HectorPereira/proyectoIntegrador2/latex/2_metodologia.tex

\section{Desarrollo de la solución}

\subsection{Alcance del proyecto}
El proyecto comprende el diseño, construcción y validación de un brazo robótico didáctico a escala. La arquitectura mecánica contempla cuatro grados de libertad (sin contar el efector), con una estructura paramétrica diseñada para corte láser en MDF de espesores entre 3.2 y 10 mm, pero adaptable también a materiales como acrílico o metal. La base será fija y deberá estar contenida dentro de un volumen de 50 $\times$ 50 $\times$ 50 cm.

\vspace{1em}

El sistema contará con efectores intercambiables, entre ellos un electroimán para la manipulación de piezas ferromagnéticas y una garra mecánica para piezas no magnéticas. Ambos estarán diseñados con un mecanismo de cambio rápido que permita alternar entre uno y otro sin dificultad.

\vspace{1em}

La actuación del brazo se logrará mediante servomotores MG996R, con uno por cada articulación principal. Para optimizar el rendimiento, se implementará una transmisión por eslabones que mantenga la mayor parte de la masa cercana a los ejes de giro.

\vspace{1em}

En cuanto al control y la electrónica, se utilizará un microcontrolador (ESP32 o ATmega328P), un driver MOSFET como el IRFZ44N (o equivalente) para gobernar el electroimán, así como finales de carrera para homing y elementos de señalización visual y sonora mediante LEDs y un buzzer de estado.

\vspace{1em}

El software incluirá un firmware desarrollado en C/C++ y una interfaz gráfica en Python, implementada en Tkinter o PyQt. Esta ofrecerá un modo manual y un modo automático, además de control ON/OFF del electroimán y una cinemática inversa planar básica para la manipulación de piezas.

\vspace{1em}

La alimentación del sistema se resolverá con una fuente capaz de abastecer tanto la lógica como la potencia, incorporando convertidores adecuados para los servos y el electroimán.

\vspace{1em}

Finalmente, en el componente de documentación y docencia, se elaborará un manual de armado, una guía docente y un conjunto mínimo de cinco prácticas de laboratorio orientadas a la enseñanza y experimentación con el brazo robótico.

\subsection{Criterios de aceptación}
El dispositivo debe ser capaz de ejecutar trayectorias punto a punto tanto en modo manual como en modo automático. Asimismo, deberá alcanzar una tasa de éxito superior al 90 \% en las tareas de agarre y manipulación de objetos, garantizando un desempeño confiable durante su operación.

\vspace{1em}

De igual forma, contará con una rutina de referencia operativa que asegure la correcta inicialización del sistema, un mecanismo de paro de emergencia y límites mecánicos verificados para preservar la seguridad del equipo y del entorno.

\vspace{1em}

Finalmente, el proyecto se entregará con un prototipo completamente ensamblado, acompañado del firmware correspondiente, la interfaz gráfica de usuario, un manual de usuario detallado y una guía docente que incluya cinco prácticas evaluables para su aplicación en el ámbito académico.

\subsection{Segmentación de proyecto}
\begin{enumerate}
  \item \textbf{Métodos de fabricación:} Definir el flujo de fabricación y los materiales del prototipo. Priorizar MDF cortado a láser para iteraciones rápidas y precisión 2D, y emplear PLA impreso en 3D en interfaces sometidas a fricción o geometrías no realizables a láser. Diseñar y fabricar galgas para validar tolerancias y encastres MDF–MDF, PLA–PLA y mixtos. Documentar parámetros de corte e impresión y criterios de aceptación dimensional.
  
  \item \textbf{Diseño y manufactura:} Modelar la estructura del brazo considerando distribución de masas, trayectorias y rigidez. Dimensionar y ubicar servomotores (MG996R y SG90), soportes, eslabones y topes mecánicos; definir uniones, casquillos y separadores. Fabricar base, articulaciones, manipulador (garra) y controlador espejo con sus accesorios. Verificar interferencias, holguras y repetibilidad; ajustar iterativamente las piezas hasta lograr el encastre objetivo.
  
  \item \textbf{Electrónica:} Integrar alimentación a 5 V, distribución de potencia y protección básica. Cablear Arduino UNO con servomotores, indicadores LED y buzzer; incorporar el controlador espejo como entrada de posición/estado. Trazar esquema eléctrico, asignar pines y preparar placa o protoboard de control. Validar corrientes de pico y caídas de tensión en carga.
  
  \item \textbf{Programación:} Desarrollar el firmware del Arduino con modos de operación manual, espejo y recorrido preprogramado. Implementar comunicación serial con la interfaz de usuario, temporización y filtrado básico de señales. Incluir homing o posiciones seguras, límites de movimiento y manejo de errores. Entregar archivo fuente versionado y un set mínimo de pruebas funcionales.
  
  \item \textbf{Documentación:} Producir el paquete de entrega: manual de uso, manual de ensamblaje y planos de fabricación. Incluir diagrama eléctrico, lista de materiales, parámetros de corte/impresión, y guías de mantenimiento. Registrar decisiones de diseño, riesgos y recomendaciones para réplica en ámbito educativo. Versionar todos los documentos y figuras con sus fuentes.
 
\end{enumerate}

\subsubsection{Esquema de procedimiento seguido}
\begin{figure}[H]
  \centering
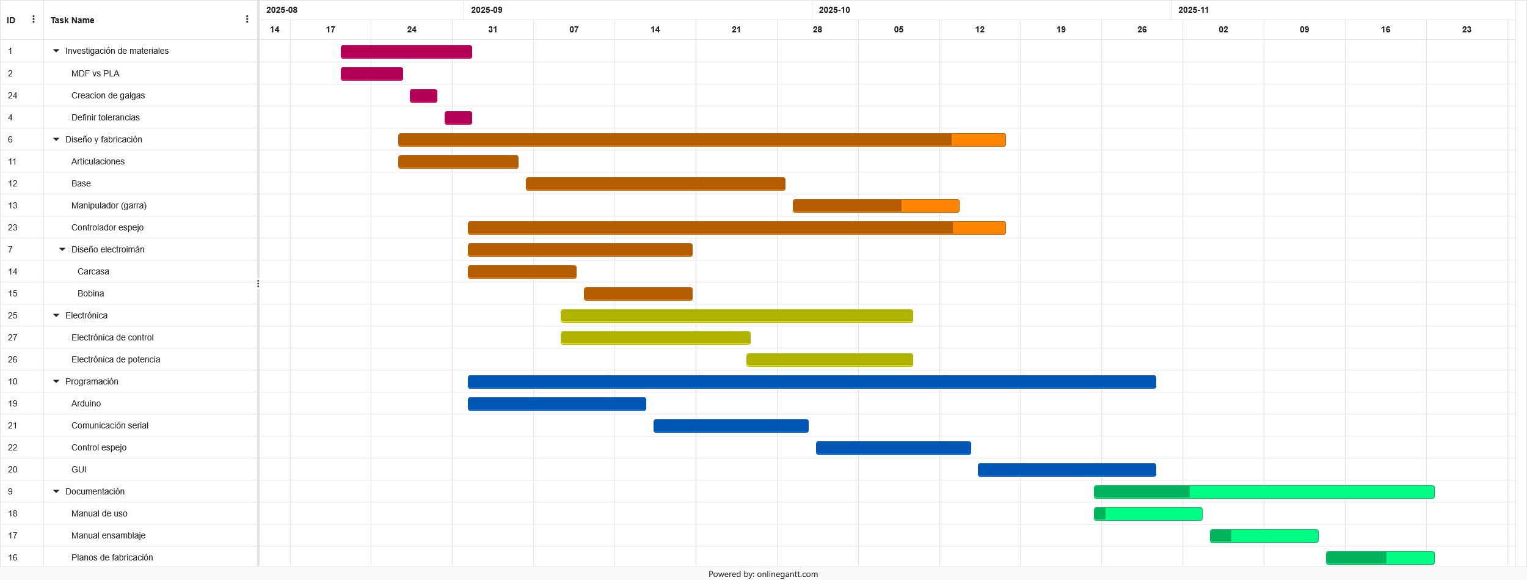
[picture p2: latex/Anexos/Gantt.png]
  
  \caption{Esquema de procedimiento y tareas seguido durante el proyecto. Fuente: elaboración propia}\label{fig:diagrama_gantt}
\end{figure}

Durante el desarrollo del proyecto se planea repartir la carga del proyecto, involucrando cada participante en una subdivisión en específico durante el transcurso de la misma. Sin embargo, permitiendo la flexibilidad de participación mixta en procesos complicados o etapas extensas. 

\vspace{1em}

Inicialmente se da paso al apartado de investigación de materiales, en donde se involucran los procesos de investigación, inspiración, y recolección de datos de métodos de fabricación disponibles en la universidad, además de investigación de lineamientos de diseño y conocimeinto específico de las herramientas. Este desarrollo tiene el objetivo de afirmar el resto del trabajo del proyecto y evitar revisiones excesivas de futuras pruebas y prototipos. 

\vspace{1em}

Luego se da lugar al apartado principal de diseño y fabricación, donde se involucran las tareas de diseñar y producir las partes mecánicas del sistema, como las articulaciones, base, eslabones, muñeca, tablero, controlador espejo, carcasa para la fuente, etc. Dentro de esta etápa también se contempla la fabricación del electroimán y el manipulador mecánico o garra.

\vspace{1em}

Otra consigna planteada la parte de electrónica, donde se busca incorporar electrónica de control, tanto para el manejo de señales de comando de motor, como de lectura para el controlador espejo, manejo adecuado de los indicadores del tablero, etc. Como la electrónica de potencia, encargada de la distribución de energía a lo largo de todo el sistema, utilizando diferentes salidas de la fuente de alimentación para lograr la mejor distribución posible de cargas, incorporando conectores macho--hembra para permitir la modularidad del sistema.

\vspace{1em}

Además, se considera la etapa de programación, donde se incorpora tanto el apartado de programación del microcontrolador en C (bajo nivel) como el desarrollo de una interfaz de usuario que permita la comunicación del sistema para mostrar información más compleja como ángulos de servomotores en tiempo real, grabación trayectos, y gráficos en tiempo real del comportamiento del brazo.

\vspace{1em}
 
Por ultimo se considera una etápa donde se realizan planos, tanto de uso, como de fabricación y mantenimiento, a fin de solucionar problemáticas que el usuario se pueda llegar a encontrar durante el proceso de ensamblado del kit, o si este quiere producir su propio kit didáctico, como si ocurren fallas en el sistema durante la operación del mismo.

\subsection{Materiales}

\begin{table}[H]
\centering
\caption{Lista general de materiales utilizados en el proyecto. Fuente: elaboración propia.}
\begin{tabular}{p{0.32\textwidth} p{0.65\textwidth}}
\toprule
\textbf{Categoría} & \textbf{Materiales} \\
\midrule

\textbf{Estructura mecánica} &
MDF de 3.0--3.2\,mm cortado a láser (base, eslabones y soportes).\\
& Piezas impresas en 3D (PLA) para articulaciones, espaciadores y topes.\\
& Tornillería M3 (tornillos, tuercas, arandelas).\\
& Adhesivos: cianoacrilato/epoxi, sellador para MDF.\\
& Lubricante seco para contactos PLA--PLA.\\
& Bridas y organizadores de cableado.\\
\midrule

\textbf{Actuadores} &
4$\times$ servomotores MG996R (180°).\\
& 1$\times$ servomotor SG90 para garra.\\
& Electroimán con bobina de cobre esmaltado y núcleo ferromagnético.\\
\midrule

\textbf{Electrónica de control} &
Arduino UNO Rev3.\\
& Módulo relé para Arduino (incluye transistor de manejo, optoacoplador y diodo de protección).\\
& LEDs + resistencias (220--330\,$\Omega$), buzzer 5\,V.\\
& 4$\times$ potenciómetros lineales de 10\,k$\Omega$.\\
& Borneras, portafusibles, fusibles (3--5\,A).\\
& Capacitores de desacople (1000--2200\,\textmu F y cerámicos).\\
& Cableado AWG18--20, funda termorretráctil, interruptor.\\
& Protoboard o placa perforada.\\
\midrule

\textbf{Fuente de alimentación} &
Fuente ATX de PC (+5\,V) con adaptador a bornes.\\
& Puenteo PS\_ON a GND y masa en estrella.\\
\bottomrule
\end{tabular}
\end{table}

\subsection{Métodos de fabricación}
\subsubsection{Tolerancias de fabricación}\label{Tolerancias}

Se fabrican galgas con impresión 3D y corte láser para identificar tolerancias y ajustes durante el proceso de diseño y fabricación. 

\begin{figure}[H]
  \centering
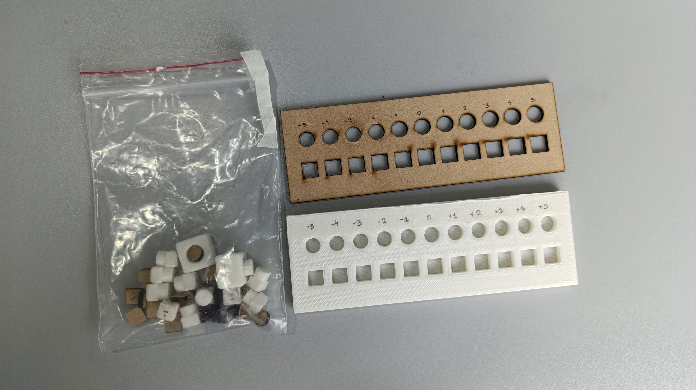
[picture p3: latex/Anexos/Pruebas/Galgas.jpg]
  
  \caption{Galgas para medición de tolerancias. Fuente: elaboración propia}\label{fig:galgas}
\end{figure}

Basádo en pruebas de encaje utilizando las galgas fabricadas, los ajustes para impresión son:
\begin{itemize}
  \item \textbf{Ajuste apretado:} 0.15mm a 0.20mm
  \item \textbf{Ajuste deslizante:} 0.25mm a 0.30mm
  \item \textbf{Ajuste flojo:} 0.30mm en adelante
\end{itemize}

Para imprimir superficies con interferencia entre sí, se debe considerar la presencia de la costura de impresión. Al momento de diseñar se debe incluir un receso en superficies redondas para permitir que la costura no sobresalga al momento de la impresión, y perjudicar la interferencia deseada.

\vspace{1em}

El corte láser brinda una precisión prácticamente exacta en la capa superficial donde se encuentra el punto focal del láser. Se debe considerar que mientras el láser atraviesa el material, y la superficie de contacto con el láser se va alejando del punto de foco, se produce una apertura de aproximadamente 1.8 grados. Lo que se traduce en que si se diseña un agujero de 10mm, en la cara trasera habrán 10.2mm.
