HectorPereira/proyectoIntegrador2/latex/1_marco_teorico.tex

\section{Fundamento técnico-conceptual}

\subsection{Análisis de mercado}
Se realizó una investigación de soluciones existentes con el fin de identificar referentes, buenas prácticas de diseño y alcances realistas para un kit didáctico. Los modelos y enlaces tomados como referencia se listan en el apéndice~\ref{apendice:inspiraciones}.

\subsubsection{GrabCAD}
GrabCAD es una plataforma comunitaria donde profesionales y estudiantes comparten modelos 3D y ensamblajes CAD.\@ Permite publicar, buscar y descargar archivos en formatos habituales (STEP/IGES, STL, SLDPRT), así como previsualizar, documentar y comentar mejoras. En esta revisión se localizaron varios brazos robóticos con distintos esquemas de actuación, útiles para comparar arquitecturas mecánicas, distribución de masas, soluciones de juntas y estrategias de fabricación.

\subsubsection{Robodacta}
Robodacta es una empresa mexicana dedicada a kits de robótica educativa para distintos niveles.\@ Sus propuestas muestran un equilibrio práctico entre costo, montaje y funcionalidad, valioso como punto de referencia. Para los objetivos de este proyecto, sin embargo, su adopción directa presenta límites: la documentación y el software son principalmente propietarios, lo que reduce la posibilidad de adaptación y reutilización abierta, y la importación añade costos y tiempos que afectan la accesibilidad en el contexto local.

\subsection{Diseños considerados}
Todas las soluciones involucran un brazo robótico de 4 articulaciones controladas por un Arduino. Las variaciones en los modelos se pueden clasificar en como se manejan las articulaciones y los actuadores utilizados. Las clasificaciones son:

\begin{itemize}
  \item\textbf{Servomotores MG996R} Un modelado directo y más convencional del brazo robótico, utilizando un servomotor por articulación y colocado directamente en la misma. Apuntando el diseño a la simplicidad, en fácil ensamblado y la reparabilidad, utilizando una combinación entre corte láser en de mdf (en mayor medida) e impresión 3d.
  
  \item\textbf{Servomotores MG996R con eslabones.} Modelo implementado con servomotores pero optimizando la distribución de peso alojando a los mismos lo más cerca del eje de rotación de cada articulación y transmitiendo el movimiento mediante eslabones y palancas, buscando mejorar la eficiencia mecánica. El diseño se vuelve más vistoso y potencialmente útil para instruir en el uso de eslabones y mecanismos simples, sin embargo aumenta la complejidad del diseño llevando mayor cantidad de partes móviles, y disminuyendo la facilidad de ensamble y reparación.

  \item\textbf{Actuadores lineales tornillo---tuerca (motor DC con reductora).} Ofrecen alta fuerza y buen costo por actuador, y pueden estar enfocados a niveles educativos superiores por la implementación de controles PID con sensado de ángulo y calibración manual, entre otras cosas. Sin embargo, el mecanismo es más lento y menos preciso; requiere encoders o potenciómetros y finales de carrera para conocer el ángulo articular. Además, el diseño de eslabones y articulaciones se torna más complejo,  y los mecanismos de codificación de posición son más propensos a \emph{interferencias/ruido} y se convierten en otro posible punto de fallo. El juego mecánico (backlash) y la fricción, además del desgaste de los potenciometros pueden degradar la repetibilidad.

  \item\textbf{Actuadores lineales con asistencia hidráulica (jeringas).} Siendo la alternativa más atractiva, pero también la más compleja. Añade una capa de transmisión hidráulica sobre el actuador lineal. A cambio, ofrece una \emph{relación fuerza---peso} muy favorable (bajo peso en el extremo móvil frente a la fuerza aplicable). No obstante, introduce menor velocidad, necesidad de purgado/cebado, riesgo de fugas y mayor mantenimiento; el control (válvulas, amortiguación) eleva la complejidad significativamente. Al igual que en la opción de tornillo---tuerca, la posición debe codificarse (p.\,ej., potenciómetros/encoders lineales), añadiendo potenciales puntos de fallo.
\end{itemize}

\subsubsection{Criterios de selección}

\begin{itemize}
  \item Distribución de peso: mide la capacidad del sistema de actuación para ubicar la masa de los actuadores cerca de la base o de los ejes principales, reduciendo así el par requerido en las articulaciones. Una buena distribución de peso incrementa la estabilidad y mejora la eficiencia energética del manipulador.
  \item Simplicidad: evalúa el grado de complejidad en el diseño, ensamblaje y operación del mecanismo. Un sistema más simple resulta más accesible para estudiantes y usuarios inexpertos, reduciendo la curva de aprendizaje y los posibles errores durante el montaje o uso.
  \item Costo: considera tanto el precio inicial de adquisición de los actuadores como el de los componentes asociados (accesorios, controladores, sensores, etc.). Este criterio es clave para mantener la accesibilidad del brazo robótico en entornos educativos.
  \item Reparabilidad: analiza la facilidad para reemplazar piezas dañadas o desgastadas, así como la disponibilidad de repuestos en el mercado. Una buena reparabilidad asegura la continuidad en el uso y la sostenibilidad a largo plazo del prototipo.
  \item Durabilidad: se refiere a la resistencia del sistema de actuación frente al desgaste mecánico, la fatiga de materiales y el uso prolongado. Los mecanismos más duraderos requieren menos mantenimiento y ofrecen mayor confiabilidad.
  \item Capacidad de carga: mide la fuerza máxima que el sistema puede ejercer en el efector final, lo cual determina el rango de piezas u objetos que el brazo robótico puede manipular. En el contexto didáctico, se prioriza un equilibrio entre capacidad de carga y ligereza del diseño.
  \item Velocidad: hace referencia al tiempo de respuesta y a la rapidez con la que el actuador puede ejecutar un movimiento. Una mayor velocidad contribuye a realizar demostraciones más dinámicas y a simular con mayor realismo procesos industriales.
  \item Precisión: evalúa la exactitud con la que el sistema puede alcanzar y mantener una posición deseada. Este atributo es fundamental para la enseñanza de conceptos de control, automatización y cinemática, ya que un mayor nivel de precisión permite ejecutar trayectorias repetibles y confiables.
\end{itemize}

\begin{table}[H]
\centering
\caption{Evaluación comparativa de mecanismos de actuación}
\begin{tabular}{lccccc}
\toprule
\textbf{Atributo} &\textbf{Peso} &\textbf{Servom.} &\textbf{Eslabones} &\textbf{Actuadores lin.} &\textbf{Pistones hidr.} \\
\midrule
Distribución de peso & 1 & 6  & 8  & 9 & 10 \\
Simplicidad          & 3 & 10 & 6  & 5 & 4  \\
Costo                & 3 & 9  & 8  & 7 & 7  \\
Reparabilidad        & 2 & 9  & 7  & 6 & 5  \\
Durabilidad          & 2 & 8  & 5  & 4 & 3  \\
Cap. de carga      & 2 & 7  & 7  & 8 & 9  \\
Velocidad            & 1 & 8  & 8  & 5 & 4  \\
Precisión            & 1 & 8  & 7  & 6 & 5  \\
\midrule
\textbf{Total ponderado}       &    & \textbf{127} & \textbf{103} & \textbf{92} & \textbf{86} \\
\bottomrule
\end{tabular}
\end{table}

Tomando en cuenta los criterios especificados con sus respectivos pesos asignados, se llega a la conclusión que un diseño con servomotores articulado es el más adecuado para llevar a cabo los objetivos planteados.

\paragraph{Lineamientos de diseño adoptados}
\begin{itemize}
  \item Enfocar el diseño en la simplicidad de montaje, reduciendo la cantidad de componentes.
  \item Reducir cantidad de elementos propensos a desgaste/fallas, planeando adecuadamente el movimiento y las interacciones físicas entre los materiales del dispositivo.  
  \item Tomar consideración de las tolerancias de fabricación en elementos deslizantes.
  \item Mantener la modularidad e intercambiabilidad del efector (electroimán/garra) y el diseño paramétrico para distintos espesores de MDF.\@
\end{itemize}

Los lineamientos de diseño se centran en garantizar un montaje sencillo y confiable, minimizando la cantidad de componentes y puntos de desgaste. Se consideraron las tolerancias de fabricación en elementos móviles, y se mantuvo un enfoque modular y paramétrico que permite la intercambiabilidad del efector y la adaptación a distintos espesores de MDF.\@

\subsection{Sustento técnico de la solución conceptual}

\subsubsection{Actuadores}

Al comparar el MG996R con el SG90 (\cite{oracid_mg996r_test} y \cite{MrProject_sg90_test}) se nota enseguida que están pensados para usos muy diferentes. El MG996R es mucho más fuerte: puede llegar a un par de hasta 10 kgf·cm, mientras que el SG90 apenas alcanza 0.7 kgf·cm. Esa diferencia hace que el primero sea ideal para mover piezas más pesadas o para darle solidez a un brazo robótico, mientras que el segundo queda limitado a proyectos pequeños y livianos.

\begin{figure}[H]
  \centering
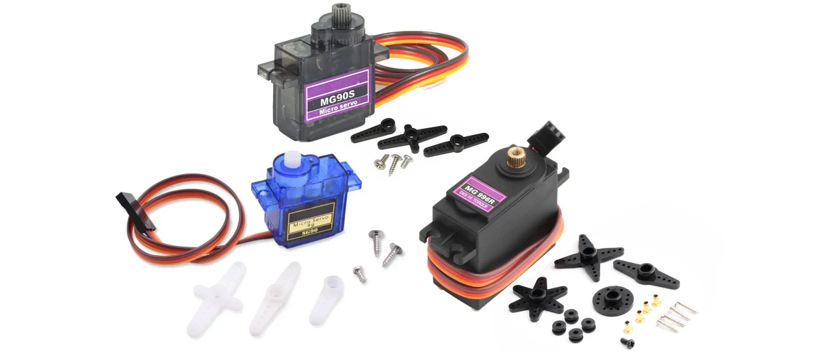
[picture p15: latex/Anexos/Servomotores/servos.jpg]
  
  \caption{Comparación de tamaños entre servomotores SG90, MG90S y MG996R. Fuente: \url{https://ecrobotics.com.bo/producto/servo-motor-mg995r/}}\label{fig:zaitronics_servos_image}
\end{figure}

En tamaño y peso también se distinguen bastante. El SG90 es muy compacto, con solo 9 gramos, frente a los 55 gramos del MG996R. Esa ligereza lo vuelve práctico cuando no hay mucho espacio o cuando se busca mantener la estructura lo más liviana posible, aunque lógicamente no tiene la misma capacidad de carga. En cuanto a velocidad, el SG90 responde un poco más rápido (0.1 s/60° frente a 0.17 s/60° a 4.8 V en el MG996R), pero esta diferencia no suele ser decisiva si lo que se necesita es fuerza y confiabilidad más que rapidez.

\vspace{1em}

Otra diferencia clave está en los materiales. El MG996R usa engranajes metálicos y un sistema de doble rodamiento de bolas, lo que le da más precisión y resistencia al desgaste. En cambio, el SG90 usa engranajes plásticos, que son más frágiles y tienden a deteriorarse con el uso. Eso sí, esta robustez del MG996R viene con un costo: su consumo de corriente es bastante más alto (puede llegar a 2.5 A en stall), mientras que el SG90 consume mucho menos y puede funcionar sin problemas con fuentes pequeñas.

\begin{table}[H]
\centering
\caption{Matriz de selección entre servos MG996R y SG90. Fuente: elaboración propia}
\begin{tabular}{lccc}
\toprule
\textbf{Atributo} & \textbf{Peso} & \textbf{Servo MG996R} & \textbf{Servo SG90} \\
\midrule
Fuerza (torque)        & 4 & 10 & 3 \\
Tamaño (dimensiones)   & 2 & 6  & 9 \\
Peso (masa)            & 2 & 5  & 9 \\
Precio                 & 2 & 7  & 9 \\
Durabilidad / materiales & 3 & 9 & 5 \\
Precisión              & 2 & 7  & 6 \\
Velocidad (s/60°)      & 1 & 6  & 9 \\
Corriente (menor=mejor) & 2 & 4  & 8 \\
\midrule
\textbf{Total ponderado} &   & \textbf{131} & \textbf{118} \\
\bottomrule
\end{tabular}
\end{table}

Basado en el resultado de la matriz de selección, el MG996R es la mejor opción cuando se busca un servo confiable, fuerte y duradero para un brazo robótico educativo que tenga que manipular piezas con cierta carga. El SG90, en cambio, es más adecuado para pruebas preliminares, proyectos sencillos o demostrativos, donde lo que importa es que sea barato, liviano y fácil de integrar. (\cite{TowerProMG996R})

\subsubsection{Estructura}

Para la fabricación del brazo se evaluaron tres alternativas: (i) estructura íntegramente en MDF mediante corte láser, (ii) piezas 100\% impresas en 3D (PLA) y (iii) enfoque híbrido, utilizando MDF como material estructural principal e interfaces de PLA en zonas de fricción y articulaciones. En el contexto del taller, el MDF ofrece una ventaja clara en \emph{tiempo de iteración}: permite realizar ajustes dimensionales rápidos (re-cortes sucesivos) y validar encastres sin esperar horas de impresión \cite{xometry_laser_vs_3dp_2022}. Además, su costo por unidad de superficie es bajo y la documentación técnica del MDF como material de ingeniería está ampliamente consolidada \cite{usda_wood_handbook_2021}.

\vspace{1em}

Ahora bien, el MDF presenta limitaciones en contactos móviles: con fricción sostenida tiende a deshilacharse y perder tolerancia, lo que afecta la repetibilidad de las uniones; de hecho, la fricción en MDF no laminado se reporta relativamente alta frente a otras chapas y tableros \cite{kukla_woodresearch_2021_mdf_friction}. Allí el PLA aporta valor: permite generar \emph{interfaces} con mejor control de tolerancias, superficies de contacto más estables y geometrías que no son viables con corte láser (chaflanes, alojamientos, casquillos, topes, etc.), con evidencia tribológica específica sobre el comportamiento de PLA impreso (influencia de textura, parámetros de impresión y lubricación) \cite{asme_pla_friction_2022}.\footnote{En zonas PLA–PLA se recomienda lubricante seco y orientar las capas para minimizar desgaste.}

\vspace{1em}

La comparación cuantitativa se resume en la matriz de selección (véase Tabla~\ref{tab:matriz_materiales}), ponderando criterios como tiempo de fabricación, costo, facilidad de retrabajo, precisión/tolerancias, comportamiento a la fricción, rigidez estructural, peso y complejidad de ensamblaje. 

\begin{table}[H]
\centering
\caption{Matriz de selección: MDF vs Impresión 3D vs Híbrido (MDF+PLA). Fuente: elaboración propia}
\begin{tabular}{lcccc}
\toprule
\textbf{Atributo} & \textbf{Peso} & \textbf{MDF} & \textbf{PLA} & \textbf{MDF+PLA} \\
\midrule
Tiempo de fabricación (menor=mejor) & 3 & 9 & 3 & 8 \\
Costo de materiales (menor=mejor)   & 2 & 9 & 5 & 8 \\
Facilidad de iteración/retrabajo    & 3 & 10 & 4 & 9 \\
Precisión / tolerancias              & 2 & 6 & 8 & 8 \\
Comportamiento a la fricción         & 3 & 3 & 8 & 8 \\
Rigidez / resistencia estructural    & 3 & 7 & 6 & 8 \\
Peso total (menor=mejor)             & 1 & 6 & 7 & 7 \\
Complejidad de ensamblaje (menor=mejor) & 1 & 8 & 6 & 6 \\
Disponibilidad de recursos (UTEC)    & 1 & 10 & 6 & 9 \\
Acabado / ajuste final               & 1 & 6 & 7 & 7 \\
\midrule
\textbf{Total ponderado}             &    & \textbf{147} & \textbf{115} & \textbf{160} \\
\bottomrule
\label{tab:matriz_materiales}
\end{tabular}
\end{table}

Con base en esa matriz, se adopta un enfoque \textbf{híbrido (MDF + interfaces PLA)}. La mayor parte de la carga estructural se resuelve con MDF, aprovechando su rapidez y economía en iteraciones; las \emph{interfaces de PLA} se emplean en articulaciones y superficies en contacto para asegurar durabilidad y estabilidad dimensional. Este esquema balancea costo y tiempos de fabricación con el desempeño mecánico requerido, y reduce riesgos de reprocesos largos propios de una solución 100\% impresa. Como consideraciones prácticas, se recomienda sellar el MDF para humedad, utilizar lubricante seco en contactos PLA–PLA, controlar la orientación de capas en piezas impresas y diseñar encastres reemplazables en las zonas de mayor desgaste.

\subsubsection{Fuente de alimentación}

Para la alimentación del brazo se evaluaron cuatro alternativas: PC (fuente ATX reciclada), una fuente conmutada de 5 V y 10 A tipo ``LED'', varias fuentes genéricas de 5 V y 2 A distribuidas por carga, y una fuente de laboratorio regulable. La fuente de PC ofrece alto margen de corriente en 5 V, protecciones integradas habituales y muy buena disponibilidad a bajo costo, a cambio de mayor volumen y la necesidad de habilitar PS\_ON, además de considerar el límite combinado 3.3 V + 5 V. La fuente LED es compacta y sencilla de cablear, pero suele tener menos margen ante picos simultáneos de servos y protecciones más básicas. La opción de múltiples fuentes genéricas permite aislar cargas, aunque complica el cableado, incrementa los puntos de falla y no comparte bien los picos intermitentes entre líneas separadas. La fuente de laboratorio ofrece excelente regulación y medición, pero no resulta práctica para un kit didáctico autónomo por costo, tamaño y dependencia de un equipo externo.

\vspace{1em}

La comparación cuantitativa se resume en la matriz de selección (véase Tabla~\ref{tab:matriz_fuente}), donde se ponderan corriente y picos, disponibilidad y costo, integración, regulación y rizado, protecciones, portabilidad, EMI, escalabilidad y confiabilidad en una escala de 1 a 10.

\begin{table}[H]
\centering
\caption{Matriz de selección de fuente de poder. Fuente: elaboración propia}
\begin{tabular}{lccccc}
\toprule
\textbf{Atributo} & \textbf{Peso} & \textbf{PC} & \textbf{LED} & \textbf{Genéricas} & \textbf{Fuente de lab.} \\
\midrule
Corriente continua y picos         & 3 & 9 & 7 & 6 & 8 \\
Disponibilidad + costo             & 2 & 10 & 7 & 8 & 3 \\
Facilidad de integración/ensamble  & 2 & 6 & 9 & 4 & 5 \\
Regulación y rizado                & 2 & 8 & 6 & 7 & 9 \\
Protecciones (OCP/OVP/OTP, etc.)   & 2 & 9 & 6 & 7 & 9 \\
Portabilidad / formato             & 1 & 5 & 7 & 6 & 3 \\
Ruido eléctrico/EMI                & 1 & 7 & 6 & 6 & 8 \\
Escalabilidad (margen futuro)      & 2 & 9 & 6 & 5 & 7 \\
Confiabilidad global               & 2 & 8 & 7 & 5 & 8 \\
\midrule
\textbf{Total ponderado}           &   & \textbf{139} & \textbf{116} & \textbf{102} & \textbf{117} \\
\bottomrule
\label{tab:matriz_fuente}
\end{tabular}
\end{table}

Con base en esa matriz (PC = 139, LED = 116, Genéricas = 102, Fuente de lab. = 117), se elige la fuente ATX de PC porque ofrece el mejor equilibrio entre margen de corriente para picos de servos, protecciones, escalabilidad y disponibilidad/costo para un kit educativo. Como guía de implementación: no usar la línea +5VSB, puentear PS\_ON a masa para encendido, distribuir 5 V con fusibles por rama, colocar capacitores de reserva cerca de los servos y realizar conexión de masa en estrella para reducir caídas y ruido.

\subsubsection{Microcontrolador}

Se consideraron tres controladores para el prototipo: Arduino UNO, Arduino NANO y ESP32. El Arduino UNO fue el más disponible en el taller y es el entorno con el que el equipo ya ha trabajado en otras asignaturas, lo que reduce tiempos de integración y riesgo de bloqueos. Su ecosistema es estable, la documentación y ejemplos son abundantes y la interfaz a 5 V simplifica el manejo de servomotores y periféricos típicos del proyecto (\cite{arduino_uno_rev3_docs}). 

\vspace{1em}

El Arduino NANO ofrece la misma plataforma ATmega328P en un formato más compacto. Mantiene la compatibilidad de librerías, el mapa de pines esencial y el mismo flujo de programación, con la ventaja de ocupar menos espacio en la base del brazo. A cambio, el conector y la disposición de pines pueden resultar menos cómodos en banco y, según versión, la disponibilidad en stock puede ser algo menor que la del UNO (\cite{arduino_nano_specs}).

\vspace{1em}

La ESP32 agrega mayor capacidad de cómputo y conectividad inalámbrica (Wi-Fi/BLE), pero requiere trabajar a 3.3 V lógicos, puede demandar adaptación de niveles para ciertos periféricos, y su curva de aprendizaje es más pronunciada para el equipo. Además, su disponibilidad local y costo por unidad resultan menos favorables en el contexto educativo planteado (\cite{espressif_esp32_series_ds}).

La comparación cuantitativa de estos criterios se presenta en la matriz de selección (véase el cuadro~\ref{tab:matriz_micro}).

\begin{table}[H]
\centering
\caption{Matriz de selección de microcontrolador. Fuente: elaboración propia}
\begin{tabular}{lcccc}
\toprule
\textbf{Atributo} & \textbf{Peso} & \textbf{UNO} & \textbf{NANO} & \textbf{ESP32} \\
\midrule
Disponibilidad en UTEC                     & 3 & 10 & 9  & 5  \\
Integración con servos/5 V                 & 3 & 9  & 9  & 6  \\
Ecosistema y soporte en curso              & 2 & 10 & 9  & 7  \\
Costo                                      & 2 & 8  & 9  & 8  \\
Tamaño                                     & 1 & 7  & 10 & 8  \\
Rendimiento (CPU/RAM)                      & 1 & 6  & 6  & 10 \\
Conectividad (UART extra/WiFi/BLE)         & 1 & 3  & 3  & 10 \\
Consumo (menor = mejor)                    & 1 & 8  & 9  & 5  \\
Robustez en banco (taller/educativo)       & 1 & 8  & 7  & 7  \\
Expansión de E/S y temporizadores          & 1 & 8  & 7  & 9  \\
\midrule
\textbf{Total ponderado}                 &   & \textbf{133} & \textbf{132} & \textbf{112} \\
\bottomrule
\label{tab:matriz_micro}
\end{tabular}
\end{table}

Con base en esa matriz y en la experiencia del equipo, se selecciona Arduino UNO. Es la opción más apropiada por disponibilidad, familiaridad, integración directa a 5 V, ecosistema y costo. El NANO queda como alternativa equivalente cuando el espacio sea crítico sin cambiar el entorno de trabajo. La ESP32 se considera para una revisión futura en la que la conectividad inalámbrica y el mayor rendimiento sean requisitos explícitos.

\subsubsection{Ecuaciones y parámetros relevantes}

\paragraph{Par y torque}
\begin{equation}
  \boldsymbol{\tau} = \boldsymbol{r} \times \boldsymbol{F} \,.\,
\end{equation}

\begin{itemize}
  \item $\bm{\tau} \rightarrow$ torque (kgf·cm o N·m)
  \item $\bm{F} \rightarrow$ fuerza en (kgf o N)
  \item $\bm{r} \rightarrow$ distancia del eje al punto de aplicación de la fuerza  (cm o m)
\end{itemize}

\cite{libretexts_torque_2023}

\paragraph{Potencia eléctrica del servo}
\begin{equation}
  P_{\mathrm{servo}} = V\,I \,.\,
\end{equation}

\begin{itemize}
  \item $P_{{servo}} \rightarrow$ potencia consumida por el servo (W)
  \item $V \rightarrow$ voltaje de alimentación (V)
  \item $I \rightarrow$ corriente consumida por el servo (A)
\end{itemize}

\cite{openstax_power_2020}

\paragraph{Consumo total del sistema}
\begin{equation}
  I_{\mathrm{total}} = \sum I_{\mathrm{servos}} + I_{\mathrm{electroiman}} + I_{\mathrm{microcontrolador}} + I_{\mathrm{indicadores}} \,.\,
\end{equation}

\begin{itemize}
  \item $I_{{total}} \rightarrow$ corriente total necesaria (A)
  \item $I_{{servos}} \rightarrow$ corriente de cada servo (A)
  \item $I_{{electroiman}} \rightarrow$ corriente del electroimán (A)
  \item $I_{{microcontrolador}} \rightarrow$ corriente del microcontrolador (A)
  \item $I_{{indicadores}} \rightarrow$ corriente consumida por com componentes indicadores(A)
\end{itemize}

\cite{openstax_kcl_2022}

\paragraph{Control por PWM}
\begin{equation}
  \theta = \frac{t_{\mathrm{high}}-t_{\min}}{\,t_{\max}-t_{\min}\,}\,(\theta_{\max}-\theta_{\min}) + \theta_{\min} \,.\,
\end{equation}

\begin{itemize}
  \item $\theta \rightarrow$ ángulo del servo (°)
  \item $t_{{high}} \rightarrow$ duración del pulso de control (s)
  \item $t_{{\min}}, t_{{\max}} \rightarrow$ tiempos de pulso correspondientes a los extremos del ángulo (s)
  \item $\theta_{{\min}}, \theta_{{\max}} \rightarrow$ ángulos extremos del servo (°)
\end{itemize}

\cite{wiki_lerp_2025,servocity_servofaq}

\paragraph{Momento de inercia de las piezas rotantes}
\begin{equation}
  I = \sum_i m_i\,r_i^{2} \,.\,
\end{equation}

\begin{itemize}
  \item $I \rightarrow$ momento de inercia (kg·cm² o kg·m²)
  \item $m_i \rightarrow$ masa de cada componente (kg)
  \item $r_i \rightarrow$ distancia al eje de rotación (cm o m)
\end{itemize}

\cite{openstax_inertia_2016}

\paragraph{Fuerza del electroimán}
\begin{equation}
  F_{\mathrm{em}} \approx \frac{B^{2}A}{2\mu_{0}} \;\;\text{con}\;\; B \simeq \mu_{0}\,\frac{N I}{g}
  \;\Rightarrow\;
  F_{\mathrm{em}} \approx \frac{(\mu_{0} N I)^{2} A}{2\,g^{2}} \,.\,
\end{equation}

\begin{itemize}
  \item $F_{{em}} \rightarrow$ fuerza de atracción del electroimán (N)
  \item $\mu \rightarrow$ permeabilidad del núcleo (H/m)
  \item $N \rightarrow$ número de vueltas de la bobina
  \item $I \rightarrow$ corriente aplicada (A)
  \item $A \rightarrow$ área del núcleo (m²)
  \item $g \rightarrow$ distancia entre el núcleo y la pieza ferromagnética (m)
\end{itemize}

\cite{wiki_magnetic_pressure_2025}

\paragraph{Resistencia de un conductor de cobre}
\begin{equation}
  R = \rho\,\frac{\ell}{A} \,.\,
\end{equation}

\begin{itemize}
  \item $R \rightarrow$ resistencia eléctrica del segmento ($\Omega$)
  \item $\rho \rightarrow$ resistividad del material ($\Omega\!\cdot\!\mathrm{m}$); para cobre a $20\,^{\circ}\mathrm{C}$, $\rho \approx 1.68\times 10^{-8}\ \Omega\!\cdot\!\mathrm{m}$
  \item $\ell \rightarrow$ longitud del conductor (m)
  \item $A \rightarrow$ área de la sección transversal (m$^{2}$); para alambre circular, $A=\pi\!\left(\frac{d}{2}\right)^{2}$
  \item $d \rightarrow$ diámetro del alambre (m) \emph{(si se usa la expresión de $A$)}
\end{itemize}

\cite{libretexts_resistivity_2025}

\paragraph{Corrección por temperatura}
\begin{equation}
  R(T) = R_{0}\,\bigl[\,1+\alpha\,(T-T_{0})\,\bigr] \,.\,
\end{equation}

\begin{itemize}
  \item $R(T) \rightarrow$ resistencia a la temperatura $T$ ($\Omega$)
  \item $R_{0} \rightarrow$ resistencia a la temperatura de referencia $T_{0}$ ($\Omega$), típicamente $20\,^{\circ}\mathrm{C}$
  \item $\alpha \rightarrow$ coeficiente de temperatura del cobre ($^{\circ}\mathrm{C}^{-1}$), $\alpha \approx 3.9\times 10^{-3}$
  \item $T \rightarrow$ temperatura de operación ($^{\circ}\mathrm{C}$)
  \item $T_{0} \rightarrow$ temperatura de referencia ($^{\circ}\mathrm{C}$)
\end{itemize}

\cite{hyperphysics_tcr_cu}

% Electrónica 
% Quiza agregar algunas figuras aca para complementar

\subsection{Aspectos electrónicos en sistemas mecatrónicos}

En los sistemas mecatrónicos y robóticos, el diseño electrónico constituye un elemento central para asegurar un funcionamiento preciso, estable y seguro. La arquitectura electrónica integra subsistemas de control, potencia y sensado que deben operar de manera coordinada, y cuya correcta disposición influye directamente en el desempeño global del sistema.

\subsubsection{Microcontroladores como unidades de control}

Los microcontroladores modernos, basados en arquitecturas como AVR o ARM, suelen actuar como núcleo del sistema electrónico. Estos dispositivos integran periféricos tales como temporizadores, módulos PWM y conversores analógico-digitales (ADC), lo que permite accionar servomotores, adquirir señales de potenciómetros o sensores y gestionar entradas digitales \cite{arduino_uno_rev3_docs, espressif_esp32_series_ds}. Debido a la sensibilidad de estos módulos, es necesario que el entorno electrónico minimice interferencias y fluctuaciones que puedan afectar la precisión del control en tiempo real.

\subsubsection{Distribución de potencia y reducción de ruido}

Un aspecto fundamental en el diseño electrónico de sistemas robóticos es la adecuada separación entre las líneas de potencia y las de lógica. Los actuadores, especialmente los motores y otros elementos inductivos, introducen variaciones rápidas de corriente que pueden provocar caídas de tensión o ruidos eléctricos en las referencias de señal. La aplicación de técnicas de distribución como la masa en estrella mejora la estabilidad del sistema al reducir diferencias de potencial no deseadas entre retornos, en concordancia con los principios generales de circulación de corriente descritos en la teoría de circuitos \cite{openstax_kcl_2022}. Esta estrategia resulta esencial para preservar la fiabilidad de las mediciones analógicas y evitar comportamientos impredecibles en el microcontrolador.

\subsubsection{Conmutación de cargas inductivas}

Los sistemas que manejan electroimanes, relés o motores deben considerar los fenómenos eléctricos asociados a la naturaleza inductiva de estos actuadores. Al ser desconectados, los inductores liberan la energía almacenada en su campo magnético en forma de picos de tensión potencialmente dañinos para los componentes de control. Este comportamiento está directamente relacionado con los principios de energía y potencia eléctrica en sistemas con elementos reactivos \cite{openstax_power_2020}. Para proteger el circuito se utilizan dispositivos como diodos de rueda libre o \emph{flyback}, y en algunos casos capacitores de desacoplo, que ayudan a reducir interferencias de alta frecuencia durante los transitorios.

\subsubsection{Compatibilidad electromagnética y desacoplo}

La coexistencia de múltiples actuadores, sensores y líneas de señal dentro de un mismo sistema aumenta la probabilidad de interferencias electromagnéticas internas. Para garantizar la compatibilidad electromagnética (EMC) se emplean técnicas como el uso de capacitores de desacoplo próximos a los circuitos integrados, el mantenimiento de distancias adecuadas entre las líneas de potencia y señal y, cuando es necesario, el uso de cables trenzados o apantallados para señales susceptibles al ruido. Estas prácticas se fundamentan en los principios básicos de conducción de corriente y caída de tensión en redes eléctricas \cite{openstax_kcl_2022}, y permiten preservar la integridad de las señales en sistemas que requieren precisión temporal o mediciones analógicas confiables.

% Programación Atmega328p
% Quiza agregar algunas figuras aca para complementar
\subsection{Programación del microcontrolador}

\subsubsection{Control de servomotores mediante modulación por ancho de pulso (PWM)}

Los servomotores de tipo RC constituyen uno de los actuadores más empleados en sistemas robóticos educativos e industriales debido a su capacidad de posicionamiento angular. Su funcionamiento se basa en la técnica de modulación por ancho de pulso (PWM), donde la posición del eje se determina por la duración del pulso de control. De forma típica, el servomotor interpreta pulsos comprendidos entre 1~ms y 2~ms dentro de un periodo de aproximadamente 20~ms, lo cual corresponde al estándar ampliamente documentado para servos RC \cite{servocity_servofaq, mg996r_datasheet, TowerProSG90}. Esta técnica permite un control preciso y de baja complejidad computacional, lo que facilita su integración en microcontroladores de recursos limitados.

\vspace{1em}

Para obtener movimientos continuos y evitar vibraciones mecánicas, se emplean técnicas de \emph{slew rate limiting}, que consisten en limitar la variación máxima del ángulo por unidad de tiempo. Dicho suavizado mejora la estabilidad del sistema, reduce esfuerzos en las articulaciones y aumenta la vida útil de los componentes mecánicos.

\subsubsection{Conversión analógico-digital en microcontroladores}

Los microcontroladores modernos incorporan conversores analógico-digitales (ADC) que permiten convertir señales analógicas en valores digitales discretos. En dispositivos basados en la arquitectura AVR, como los empleados en plataformas ampliamente utilizadas en educación y prototipado electrónico, los ADC suelen ofrecer una resolución de 10 bits \cite{arduino_uno_rev3_docs}. Esta resolución permite representar hasta 1024 niveles diferentes, lo que resulta adecuado para tareas de control articulado basadas en potenciómetros u otros sensores variables.

\vspace{1em}

Las lecturas analógicas suelen requerir procesos de \emph{escalado} o mapeo para convertir el rango del ADC en magnitudes físicas tales como grados articulares. Este proceso lineal permite correlacionar directamente la entrada del usuario con la posición deseada del actuador.

\subsubsection{Comunicación serial UART en sistemas embebidos}

La comunicación serial asíncrona mediante UART (Universal Asynchronous Receiver-Transmitter) es una de las interfaces más utilizadas en sistemas embebidos debido a su simplicidad y bajo costo. Este protocolo emplea tramas formadas por bits de inicio, datos y parada, permitiendo el intercambio de información entre un microcontrolador y una computadora o dispositivo externo.

\vspace{1em}

En sistemas robóticos, la interfaz UART permite implementar arquitecturas distribuidas en las cuales el control de alto nivel reside en una aplicación externa, mientras que el microcontrolador ejecuta las tareas de control de bajo nivel. La naturaleza textual de diversos protocolos implementados sobre UART facilita su depuración y expansión.

\subsubsection{Interfaz humano-máquina (HMI) en robótica}

Las interfaces humano-máquina (HMI) constituyen un componente clave en sistemas robóticos, ya que proveen el medio mediante el cual el operador interactúa con el sistema. Una HMI puede variar desde paneles de control físicos hasta aplicaciones gráficas avanzadas que permiten supervisar el estado del robot, introducir consignas y visualizar información relevante en tiempo real.

\vspace{1em}

En el ámbito de la manipulación robótica, una HMI adecuada facilita la operación intuitiva del sistema, el registro de trayectorias, la automatización de tareas y el control seguro de los actuadores. La comunicación bidireccional entre el microcontrolador y la interfaz gráfica permite recibir telemetría, enviar comandos y mantener coherencia entre el estado físico del robot y su representación lógica en software.

\subsubsection{Máquinas de estado finito en sistemas embebidos}

Las máquinas de estado finito (FSM, por sus siglas en inglés) son un modelo ampliamente utilizado para estructurar la lógica de control en sistemas embebidos. En este enfoque, el comportamiento del sistema se representa mediante estados definidos y transiciones condicionadas, lo que permite modelar secuencias de eventos como cambios de modo de operación, activación de actuadores o ejecución de patrones temporizados.

\vspace{1em}

El uso de FSM ofrece ventajas en términos de claridad, robustez y mantenibilidad del código, especialmente en sistemas que integran múltiples modos de operación, temporizaciones y eventos asincrónicos, tales como botones, actuadores o señales provenientes de una interfaz externa.

\subsubsection{Antirrebote en lectura de botones}

Los interruptores mecánicos presentan un fenómeno conocido como ``rebote'' (\emph{bouncing}), caracterizado por múltiples transiciones rápidas entre niveles lógicos durante el cambio de estado. Si no se implementan mecanismos de filtrado, estos rebotes pueden generar lecturas erróneas, activaciones múltiples o comportamientos no deseados.

\vspace{1em}

El antirrebote por software consiste en ignorar transiciones sucesivas durante un intervalo corto de tiempo, asegurando que cada pulsación se interprete como un único evento. Este procedimiento es esencial en sistemas donde se implementan botones para conmutar modos de operación o activar funciones críticas.

\subsubsection{Control de actuadores digitales simples}

Además de servomotores, los sistemas robóticos frecuentemente incorporan actuadores digitales como electroimanes, relés o elementos sonoros como buzzers. Su acción implica con frecuencia cargas inductivas, las cuales pueden generar picos de tensión durante la conmutación debido a la energía almacenada en sus campos magnéticos. Estos fenómenos se explican desde los principios de potencia y comportamiento eléctrico descritos en la literatura básica \cite{openstax_power_2020}. El control mediante salidas digitales permite activar o desactivar dichos actuadores de forma confiable, mientras que la incorporación de técnicas de protección evita daños en los componentes.

\vspace{1em}

Los buzzers se emplean comúnmente como medio de retroalimentación auditiva dentro de la interfaz humano-máquina, permitiendo indicar cambios de estado, alertas o confirmaciones al usuario. La generación de patrones sonoros mediante máquinas de estado aporta flexibilidad y precisión temporal.

\subsubsection{Seguridad funcional en sistemas robóticos}

La seguridad constituye un aspecto fundamental en sistemas robóticos, debido a la presencia de partes móviles y posibles riesgos para el operador. Las medidas de seguridad por software incluyen la imposición de límites angulares, la validación de comandos, la implementación de rampas de movimiento y la prevención de cambios bruscos de estado. Estas estrategias contribuyen a evitar daños en los actuadores, reducir esfuerzos innecesarios, prolongar la vida útil del mecanismo y proteger al usuario ante comportamientos inesperados.

\subsubsection{Temporización y control en tiempo real}

Los microcontroladores disponen de temporizadores internos que permiten implementar tareas periódicas, generar señales PWM o medir intervalos de tiempo. La temporización es esencial para coordinar el control de servomotores, ejecutar bucles de lectura, actualizar máquinas de estado y transmitir telemetría a tasas constantes.

\vspace{1em}

El uso de temporizadores en sistemas embebidos garantiza un comportamiento determinístico, especialmente en aquellas aplicaciones donde la sincronización temporal y la repetitividad del movimiento son críticas.

% Interfaz de usuario
% Quiza agregar algunas figuras aca para complementar

\subsection{Interfaz gráfica de usuario}

\subsubsection{Interfaz humano-máquina (HMI)}

En los sistemas robóticos con múltiples grados de libertad, la interacción entre el operador y la máquina constituye un elemento fundamental para garantizar precisión, seguridad y repetitividad. Las interfaces humano-máquina (HMI, por sus siglas en inglés) permiten que el usuario supervise y controle el estado del sistema sin interactuar directamente con los niveles más bajos del hardware.

En el campo de la robótica manipuladora, las HMI han evolucionado desde paneles de control físico hasta interfaces gráficas de usuario (GUI), las cuales se han consolidado como una solución estándar tanto en entornos educativos como industriales. La popularidad de estos enfoques puede observarse en numerosos desarrollos y modelos de brazos robóticos disponibles en repositorios abiertos y plataformas de diseño asistido por computadora \cite{grabcad_robot_arm_6dof, grabcad_robotic_arm_216}. Este tipo de interfaces facilita el control manual y, simultáneamente, permite visualizar en tiempo real parámetros como posiciones articulares, trayectorias, estados de actuadores y condiciones operativas del robot.

\subsubsection{Interfaces gráficas de usuario en robótica}

Las interfaces gráficas proporcionan ventajas relevantes frente a mecanismos de control exclusivamente físicos. Entre las más destacadas se encuentran la precisión en la configuración de parámetros, la visualización clara del estado del sistema, la incorporación de funciones avanzadas como la grabación de trayectorias y la posibilidad de incluir restricciones de seguridad mediante software. En la robótica moderna, estas herramientas son fundamentales para mejorar la usabilidad y reducir la intervención directa sobre los actuadores, tal como se evidencia en múltiples implementaciones didácticas y experimentales \cite{youtube_robot_arm_control, robodacta_mini_arm_joystick}.

\subsubsection{Arquitecturas de comunicación en sistemas robóticos}

Los sistemas robóticos suelen adoptar arquitecturas distribuidas, en las cuales las tareas de alto nivel se ejecutan en una plataforma de cómputo externa, mientras que el controlador embebido gestiona el control de tiempo real. La interacción entre ambos módulos se implementa comúnmente mediante protocolos de comunicación serie, ya sea en configuraciones síncronas o asíncronas, utilizando estructuras de comunicación basadas en mensajes. Estos modelos permiten mantener un control determinístico a nivel de actuadores y, al mismo tiempo, ofrecen flexibilidad y extensibilidad en la capa superior del sistema.

\subsubsection{Modos de operación en manipuladores robóticos}

Muchos sistemas robóticos incorporan múltiples modos de operación con fines de redundancia funcional, seguridad y adaptabilidad. Un modelo común distingue entre el \textbf{control manual o directo}, donde los comandos provienen de la manipulación física por parte del operador, y el \textbf{control asistido por software}, donde las consignas se generan desde una interfaz gráfica, un planificador o un algoritmo supervisor. Este enfoque permite combinar la precisión del control automático con la intuición y supervisión humana, manteniendo así un equilibrio entre flexibilidad y confiabilidad.

\subsubsection{Grabación y reproducción de trayectorias}

La grabación de trayectorias es una técnica ampliamente utilizada en robótica industrial, especialmente en aplicaciones de manipulación, ensamblaje y tareas repetitivas. Consiste en muestrear el estado del robot —generalmente posiciones articulares o cartesianas— a intervalos regulares y almacenarlos en forma de secuencia temporal. La reproducción se realiza replicando la secuencia respetando el mismo ritmo de muestreo, lo que permite repetir movimientos con alta fidelidad sin requerir intervención directa del operador. Ejemplos didácticos y demostraciones funcionales de esta técnica pueden encontrarse en diversas plataformas de contenido educativo \cite{youtube_robot_arm_mirror}.

\subsubsection{Seguridad en interfaces de control robótico}

En el diseño de interfaces de control para sistemas mecatrónicos, la seguridad operativa es un criterio crítico. Una HMI bien diseñada debe evitar transiciones bruscas de estado, incluir verificaciones de coherencia de comandos, impedir movimientos fuera de rango y garantizar que los cambios entre modos de operación sean suaves y progresivos. Estos principios contribuyen a proteger tanto al operador como a los componentes mecánicos del robot, reduciendo la probabilidad de fallas o comportamientos inesperados del sistema.
