HectorPereira/proyectoIntegrador2/latex/main.tex

\documentclass[11pt]{article}
\usepackage[T1]{fontenc}
\usepackage{comment}
\usepackage{bm}
\usepackage{booktabs}
\usepackage[utf8]{inputenc}
\usepackage[spanish]{babel}
\usepackage{graphicx}
\usepackage{float}
\usepackage{multicol}
\usepackage[natbibapa]{apacite}
\usepackage[hyphens,spaces]{url} % optional, but highly recommended
\usepackage{siunitx}
\usepackage{natbib}
\usepackage{listings}
\usepackage{xcolor}
\usepackage{pdfpages}

% ============================
%    ESTILO PARA LISTINGS
% ============================
\definecolor{miverde}{rgb}{0,0.6,0}
\definecolor{miamarillo}{rgb}{0.7,0.5,0}
\definecolor{mimagenta}{rgb}{0.58,0,0.82}
\definecolor{migris}{rgb}{0.95,0.95,0.95}

\lstdefinestyle{estilo-mectronica}{
    backgroundcolor=\color{migris},
    commentstyle=\color{miverde},
    keywordstyle=\color{blue}\bfseries,
    stringstyle=\color{mimagenta},
    numberstyle=\tiny\color{miamarillo},
    basicstyle=\ttfamily\small,
    breaklines=true,
    numbers=left,
    numbersep=8pt,
    tabsize=4,
    showspaces=false,
    showtabs=false,
    frame=single,
    literate=
        {á}{{\'a}}1
        {é}{{\'e}}1
        {í}{{\'\i}}1
        {ó}{{\'o}}1
        {ú}{{\'u}}1
        {ñ}{{\~n}}1
        {Á}{{\'A}}1
        {É}{{\'E}}1
        {Í}{{\'I}}1
        {Ó}{{\'O}}1
        {Ú}{{\'U}}1
        {Ñ}{{\~N}}1
        {¿}{{\textquestiondown}}1
        {¡}{{\textexclamdown}}1
}

\lstset{style=estilo-mectronica, language=C}

\sisetup{round-mode=places,round-precision=2,detect-all}
\usepackage[
  colorlinks=true,
  linkcolor=black,
  urlcolor=black,
  citecolor=black
]{hyperref}
\usepackage[
  a4paper,
  top=25mm,bottom=25mm,left=25mm,right=25mm,
  includefoot,heightrounded,footskip=12mm
]{geometry}
\flushbottom      % asegura que el texto llegue al margen inferior

\begin{document}

% --- Portada a sangre (sin márgenes) ---
\newgeometry{
  left=0mm,right=0mm,top=0mm,bottom=0mm,
  headheight=0pt,headsep=0pt,footskip=0pt,
  includehead=false,includefoot=false
}
\begin{titlepage}
  \thispagestyle{empty}
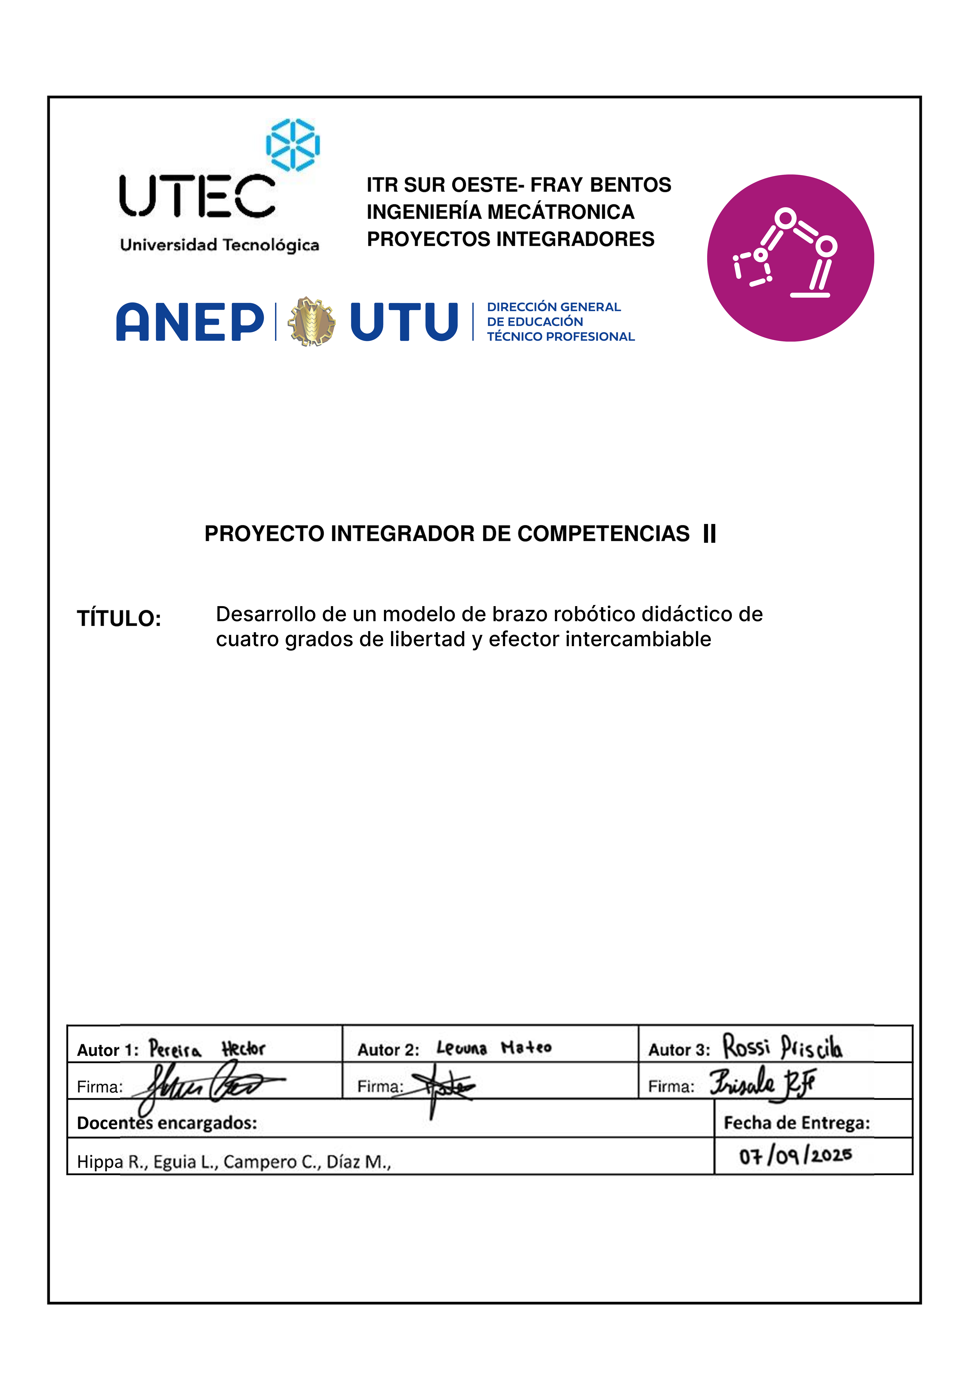
[picture p16: latex/Anexos/Portada.png]
  \noindent
\end{titlepage}
\restoregeometry{}
\clearpage   % página limpia con márgenes restaurados

\tableofcontents

\newpage

\input{0_introduccion}

\input{1_marco_teorico}

\input{2_metodologia}

\input{3_resultados}

\input{4_conclusiones}

\bibliographystyle{apacite}
\nocite{*}
\bibliography{5_referencias}

\appendix
\input{6_apendice}

\end{document}
