HectorPereira/proyectoIntegrador2/latex/evidencias 2/evidencias.pdf

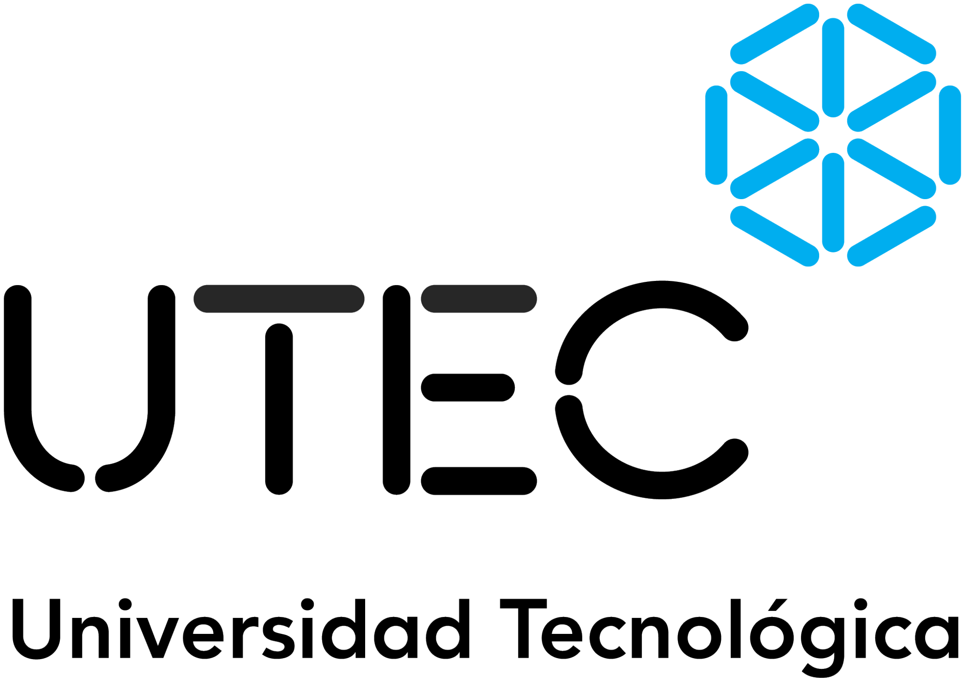
[picture p26: figure]

## Universidad Tecnológica del Uruguay (UTEC)

Proyecto Integrador Brazo robótico didáctico

## Evidencias de proyecto

Integrantes: Mateo Lecuna, Hector Pereira, Priscila Rossi Docente/s: Marcelo Diaz, Christian Campero
Fecha: 26 de octubre de 2025

## Índice

1. Resumen | 2
2. Metodología y cronograma | 2
3. Evidencias de diseño y fabricación | 2
4. Electrónica y programación | 7
A. Repositorio de evidencias digitales | 10
B. Código | 10
B.1. Control de Servomotor con Modo Potenciómetro y Comunicación Serial (USART) . . . | 10

## 1. Resumen

## 2. Metodología y cronograma

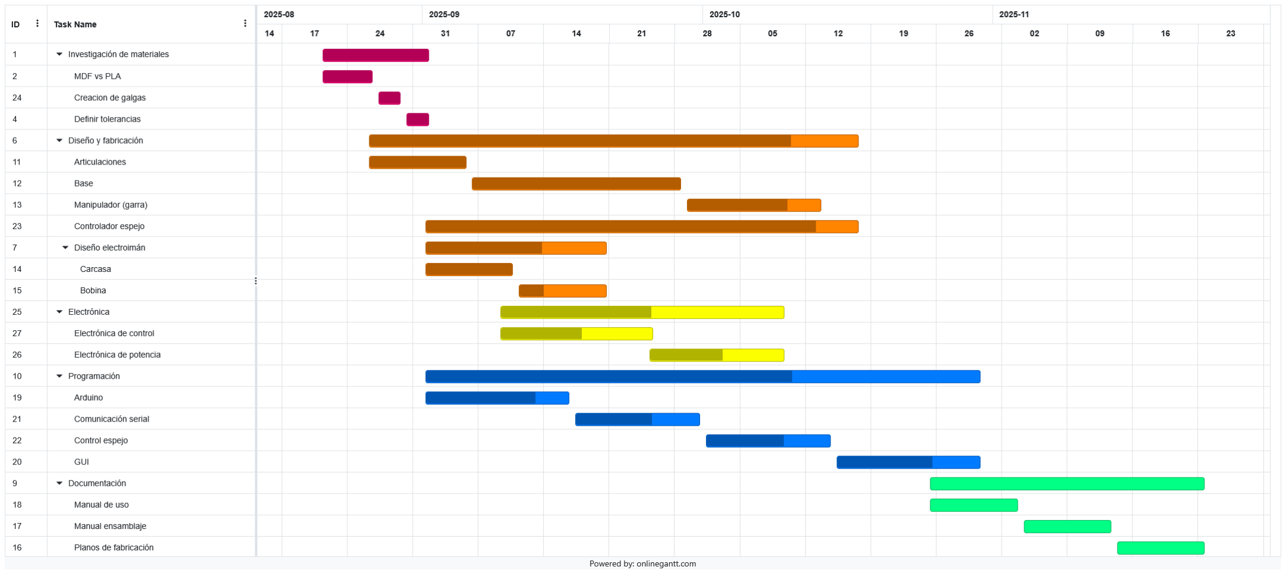
[picture p27: figure]

Figura 1: Diagrama de Gantt. Fuente: elaboración própia

## 3. Evidencias de diseño y fabricación

3.1. Materiales y métodos

Para el desarrollo del brazo robótico se emplearon materiales accesibles y técnicas de fabricación complementarias, priorizando la modularidad y facilidad de ensamblaje. Las primeras etapas se centraron en el uso de MDF cortado por láser para los componentes estructurales, debido a su precisión y rapidez de fabricación, mientras que las piezas que requerían geometrías más complejas o encastres nos se imprimieron en 3D con lamento PLA.
El diseño se realizó íntegramente en software CAD, permitiendo iterar entre versiones y evaluar virtualmente la cinemática de cada articulación. Posteriormente, se llevaron a cabo pruebas físicas con prototipos a escala real para validar tolerancias, rigidez y facilidad de ensamblaje antes de consolidar el diseño nal.
3.2. Brazo articulado

Se realizaron cortes en MDF de los tres primeros segmentos articulados del brazo con el n de evaluar tolerancias de fabricación, rigidez estructural y dicultad de ensamblaje. Durante esta etapa se vericó el calce de los servomotores y articulaciones, así como la estabilidad del conjunto al aplicar cargas simuladas.
Los resultados mostraron que el espesor del material utilizado era insuciente para garantizar la rigidez necesaria, especialmente en los puntos de articulación. Además, el tipo de encastre abierto empleado en esta primera versión dicultaba el armado, ya que las piezas tendían a salirse de posición durante el proceso de montaje.


Figura 2: Corte y ensamblaje preliminar de los tres primeros segmentos en MDF para evaluar tolerancias, rigidez y dicultad de ensamblaje. Fuente: elaboración propia.

A partir de estas observaciones, se rediseñaron los componentes con un sistema de encastre envolvente, el cual permite mantener las piezas en posición estable antes del pegado o atornillado. Asimismo, se incorporó una base con patas y una supercie destinada al montaje de los componentes electrónicos, mejorando la distribución del peso y el acceso durante el mantenimiento. Se añadieron también monturas adicionales para la jación de tornillos y la instalación de medios elásticos como gomas o resortes que asisten al servomotor de la articulación inferior en ángulos de apertura críticos.


Figura 3: Render del diseño nal del brazo robótico, con encastres envolventes y base estructural reforzada. Fuente: elaboración propia.

El modelo nal presentó una notable mejora en rigidez y estabilidad durante el ensamblaje. Las gomas elásticas implementadas resultaron ecaces para reducir el esfuerzo sobre los servomotores, evitando la necesidad de sustituirlos por modelos de mayor torque. Finalmente, se realizó una prueba funcional con el electroimán montado, utilizando una galga reciclada de un diseño anterior para estimar el comportamiento dinámico y la capacidad de carga del brazo.


Figura 4: Modelo nal ensamblado del brazo articulado con gomas elásticas de asistencia y prueba del electroimán. Fuente: elaboración propia.

3.3. Controlador espejo

El controlador del brazo fue diseñado como una réplica funcional que permite manipular directamente las articulaciones del modelo principal mediante un sistema de control espejo. En su primera versión, se optó por una estructura completamente fabricada en PLA impreso en 3D, lo que ofrecía una alta precisión dimensional pero presentaba limitaciones en rigidez y tiempos de fabricación prolongados.


Figura 5: Diseño inicial del controlador del brazo fabricado completamente en PLA. Fuente: elaboración propia.

Frente a estas limitaciones, se implementó un rediseño híbrido que combina MDF y PLA, aprovechando las ventajas de ambos métodos. La estructura principal se construyó en MDF mediante corte láser, garantizando una base robusta y de rápida producción, mientras que los encastres, acoples y carcasas con geometrías más complejas se imprimieron en PLA.


Figura 6: Nuevo diseño del controlador híbrido MDFPLA, combinando corte láser e impresión 3D para optimizar rigidez y precisión. Fuente: elaboración propia.

El diseño nal logra una integración eciente entre las piezas de madera y plástico, garantizando la precisión mecánica necesaria para reproducir los movimientos del brazo robótico. Además, el enfoque modular del diseño facilita futuras mejoras, como la incorporación de sensores o la sustitución de componentes especícos sin necesidad de rehacer toda la estructura.

## 4. Electrónica y programación

4.1. Electrónica de control

El sistema de control del brazo robótico está basado en un microcontrolador ATmega328P montado sobre una placa Arduino Uno, el cual actúa como unidad principal de procesamiento y coordinación de señales. En el circuito se implementa una arquitectura de tipo control espejo, donde un conjunto de potenciómetros permite reproducir manualmente los movimientos que el brazo ejecuta mediante servomotores.
Cada potenciómetro funciona como un divisor de tensión conectado entre 5.00 V y tierra, entregando en su terminal central una señal analógica proporcional al ángulo de giro. Estas señales son adquiridas por las entradas analógicas del microcontrolador (A0A3), digitalizadas mediante su convertidor analógicodigital (ADC) interno y posteriormente traducidas a señales de modulación por ancho de pulso (PWM) generadas en los pines digitales (D6-B1-B2). Cada una de estas salidas PWM gobierna directamente un servomotor, logrando así que la posición de los ejes del brazo robótico imite en tiempo real el movimiento realizado sobre los potenciómetros del controlador.

La alimentación del sistema se distribuye a través de una línea común de 5.00 V y una referencia de tierra compartida. En esta conguración, los servomotores, potenciómetros y el microcontrolador comparten la misma fuente de energía, garantizando la coherencia de referencia eléctrica. No obstante, para versiones nales o de mayor carga mecánica, se considera la posibilidad de incorporar una fuente externa de corriente continua dedicada exclusivamente a los servomotores, a n de evitar caídas de tensión durante el funcionamiento.
Finalmente, el esquema incluye tres indicadores luminosos LED rojo, verde y azul que cumplen funciones de depuración y señalización visual. Estos se conectan a través de resistencias limitadoras de corriente y permiten indicar estados del sistema como encendido, operación correcta o condiciones de error.


Figura 7: Diagrama eléctrico del sistema de control del brazo robótico, con conexiones entre potenciómetros, servomotores, LEDs y microcontrolador Arduino Uno. Fuente: elaboración propia.

4.2. Interfaz de usuario

La interfaz de usuario fue desarrollada en Python utilizando la biblioteca Tkinter, con el propósito de ofrecer un medio visual e intuitivo para interactuar con el sistema. Desde esta aplicación, el usuario puede seleccionar entre dos modos de funcionamiento: automático y manual, ambos comunicados con el microcontrolador a través del protocolo USART.
En el modo automático, el programa ejecuta secuencias predenidas de movimiento controlando los ángulos de cada servomotor directamente desde el entorno Python. Los valores de posición se transmiten mediante el puerto serial al microcontrolador, que interpreta los comandos y ajusta los servos en consecuencia. Este modo resulta útil para la ejecución repetitiva de trayectorias o demostraciones programadas sin intervención del usuario.
Por otro lado, el modo manual permite al operador controlar en tiempo real la posición de cada articulación a través de los potenciómetros del controlador espejo. En este caso, la interfaz cumple el rol de monitor serial, mostrando los valores de ángulo recibidos desde el microcontrolador y permitiendo el cambio de estado o calibración mediante comandos especícos.
El seteo de ángulos, el cambio entre modos de operación y la comunicación bidireccional entre Python y el microcontrolador se gestionan completamente a través del puerto serial, utilizando mensajes de texto estructurados y delimitadores que aseguran la correcta interpretación de los datos en ambos sentidos. Esta implementación facilita la depuración del sistema y ofrece una capa adicional de control y supervisión sobre el hardware embebido.


Figura 8: Interfaz de usuario desarrollada en Python utilizando la biblioteca Tkinter, con opciones de control automático y manual comunicadas por USART. Fuente: elaboración propia.

## A. Repositorio de evidencias digitales

Con el n de centralizar y facilitar el acceso a todos los materiales complementarios del proyecto, se ha dispuesto un repositorio en línea que contiene los archivos digitales correspondientes a las evidencias presentadas en este informe. Dicho repositorio incluye fotografías del proceso de fabricación, renders de los modelos 3D, archivos CAD, esquemas eléctricos, simulaciones, programas en C y Python, así como los recursos multimedia asociados a las pruebas funcionales.

El acceso al repositorio puede realizarse mediante el siguiente enlace:

Repositorio en Google Drive Evidencias del Proyecto (https://drive.google.com/drive/folders/1XPbaXmohBO5XQhgipXt-RZ1E9vsX4483?usp=drive_link)

## B. Código

B.1. Control de Servomotor con Modo Potenciómetro y Comunicación Serial (USART)

#define F_CPU 16000000UL

#include <avr/io.h>

#include <avr/interrupt.h> #include <util/delay.h>

#include <stdint.h>

#include <stdbool.h>

#include <string.h>

#include <stdio.h>

/* ===== Servo (D9/OC1A) ===== */
#define SERVO_MIN_US | 500

#define SERVO_MAX_US | 2500

#define SERVO_SLEW_STEP | 2

static inline void servo_init(void){ DDRB |= (1<<PB1);
TCCR1A = (1<<COM1A1) | (1<<WGM11);
TCCR1B = (1<<WGM13) | (1<<WGM12) | (1<<CS11); // presc=8
ICR1 = 39999; // 20 ms
}
static inline uint16_t us_to_ticks(uint16_t us){ return (uint16_t)(us*2); } static inline void servoA_write_us(uint16_t us){
if(us<SERVO_MIN_US) us=SERVO_MIN_US; if(us>SERVO_MAX_US) us=SERVO_MAX_US; OCR1A = us_to_ticks(us);
}
static inline uint16_t deg_to_us(uint8_t deg){ if(deg>180) deg=180;
return (uint16_t)(SERVO_MIN_US + ((uint32_t)(SERVO_MAX_US-SERVO_MIN_US)*deg)/180); }

/* ===== ADC (A0) ===== */ #define ADC_SAMPLES 10
#define ADC_DEADBAND 2

static inline void adc_init(void){ ADMUX = (1<<REFS0);
ADCSRA = (1<<ADEN) | (1<<ADPS2) | (1<<ADPS1); // /64
}
static inline uint16_t adc_read(uint8_t ch){
ADMUX = (ADMUX & 0xF0) | (ch & 0x0F);
ADCSRA |= (1<<ADSC);
while(ADCSRA & (1<<ADSC));

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
