HectorPereira/proyectoIntegrador2/latex/evidencias/evidencias.tex

\documentclass[11pt,a4paper]{article}

% Idioma y codificación
\usepackage[spanish,es-tabla]{babel}
\usepackage[T1]{fontenc}
\usepackage[utf8]{inputenc}
\usepackage{csquotes}
\usepackage{multicol}
\usepackage{siunitx}
\sisetup{round-mode=places,round-precision=2,detect-all}

% Formato y utilidades
\usepackage[a4paper,margin=2.5cm]{geometry}
\usepackage{graphicx}
\graphicspath{{../anexos/}{figuras/}{imagenes/}{img/}}
\usepackage{float}      % [H]
\usepackage{hyperref}
\usepackage{booktabs}
\hypersetup{
  colorlinks=true,
  linkcolor=black,
  urlcolor=blue,
  citecolor=black
}

% Bibliografía
\usepackage[style=ieee,backend=biber]{biblatex}
\addbibresource{referencias.bib}

\begin{document}

% Portada simple
\begin{titlepage}
  \centering
  {\Large Universidad Tecnol\'ogica del Uruguay (UTEC)\par}
  \vspace{0.5cm}
  {\large Proyecto Integrador — Brazo rob\'otico did\'actico\par}
  \vspace{2cm}
  {\LARGE Evidencias del proyecto\par}
  \vspace{1.5cm}
  \begin{tabular}{rl}
    Integrantes: & Hector Pereira, Mateo Lecuna, Priscila Rossi \\
    Docente/s:   & Marcelo Diaz, Christian Campero \\
    Fecha:       & \today
  \end{tabular}
  \vfill
\end{titlepage}

\tableofcontents
\newpage

\section{Resumen}
Se aplicaron matrices de selección para decidir: mecanismo de actuación (se favorecieron servomotores frente a actuadores lineales e hidráulicos), y, entre servos, la comparación MG996R vs SG90; además, materialidad (MDF, PLA o híbrido), fuente de poder y microcontrolador (UNO/NANO/ESP32).

\section{Metodología y cronograma}

\begin{figure}[H]
  \centering
  
  \caption{Diagrama de Gantt. Fuente: elaboración própia}
\end{figure}

\section{Evidencias de diseño y fabricación}

\subsection{Materiales y métodos}

\begin{table}[H]
\centering
\caption{Matriz de selección: mecanismos de actuación}
\begin{tabular}{lccccc}
\toprule
\textbf{Atributo} &\textbf{Peso} &\textbf{Servom.} &\textbf{Eslab.} &\textbf{Actuad. lin.} &\textbf{Pistones hidr.} \\
\midrule
Distribución de peso & 1 & 6  & 8  & 9 & 10 \\
Simplicidad          & 3 & 10 & 6  & 5 & 4  \\
Costo                & 3 & 9  & 8  & 7 & 7  \\
Reparabilidad        & 2 & 9  & 7  & 6 & 5  \\
Durabilidad          & 2 & 8  & 5  & 4 & 3  \\
Cap. de carga      & 2 & 7  & 7  & 8 & 9  \\
Velocidad            & 1 & 8  & 8  & 5 & 4  \\
Precisión            & 1 & 8  & 7  & 6 & 5  \\
\midrule
\textbf{Total ponderado}       &    & \textbf{127} & \textbf{103} & \textbf{92} & \textbf{86} \\
\bottomrule
\end{tabular}
\end{table}

\begin{table}[H]
\centering
\caption{Matriz de selección entre servos MG996R y SG90}
\begin{tabular}{lccc}
\toprule
\textbf{Atributo} & \textbf{Peso} & \textbf{Servo MG996R} & \textbf{Servo SG90} \\
\midrule
Fuerza (torque)        & 4 & 10 & 3 \\
Tamaño (dimensiones)   & 2 & 6  & 9 \\
Peso (masa)            & 2 & 5  & 9 \\
Precio                 & 2 & 7  & 9 \\
Durabilidad / materiales & 3 & 9 & 5 \\
Precisión              & 2 & 7  & 6 \\
Velocidad (s/60°)      & 1 & 6  & 9 \\
Corriente (menor=mejor) & 2 & 4  & 8 \\
\midrule
\textbf{Total ponderado} &   & \textbf{131} & \textbf{118} \\
\bottomrule
\end{tabular}
\end{table}

\begin{table}[H]
\centering
\caption{Matriz de selección: MDF vs Impresión 3D vs Híbrido (MDF+PLA)}
\begin{tabular}{lcccc}
\toprule
\textbf{Atributo} & \textbf{Peso} & \textbf{MDF} & \textbf{PLA} & \textbf{MDF+PLA} \\
\midrule
Tiempo de fabricación (menor=mejor) & 3 & 9 & 3 & 8 \\
Costo de materiales (menor=mejor)   & 2 & 9 & 5 & 8 \\
Facilidad de iteración/retrabajo    & 3 & 10 & 4 & 9 \\
Precisión / tolerancias              & 2 & 6 & 8 & 8 \\
Comportamiento a la fricción         & 3 & 3 & 8 & 8 \\
Rigidez / resistencia estructural    & 3 & 7 & 6 & 8 \\
Peso total (menor=mejor)             & 1 & 6 & 7 & 7 \\
Complejidad de ensamblaje (menor=mejor) & 1 & 8 & 6 & 6 \\
Disponibilidad de recursos (UTEC)    & 1 & 10 & 6 & 9 \\
Acabado / ajuste final               & 1 & 6 & 7 & 7 \\
\midrule
\textbf{Total ponderado}             &    & \textbf{147} & \textbf{115} & \textbf{160} \\
\bottomrule
\end{tabular}
\end{table}

\begin{table}[H]
\centering
\caption{Matriz de selección de fuente de poder}
\begin{tabular}{lccccc}
\toprule
\textbf{Atributo} & \textbf{Peso} & \textbf{PC} & \textbf{LED} & \textbf{Genéricas} & \textbf{Fuente de lab.} \\
\midrule
Corriente continua y picos         & 3 & 9 & 7 & 6 & 8 \\
Disponibilidad + costo             & 2 & 10 & 7 & 8 & 3 \\
Facilidad de integración/ensamble  & 2 & 6 & 9 & 4 & 5 \\
Regulación y rizado                & 2 & 8 & 6 & 7 & 9 \\
Protecciones (OCP/OVP/OTP, etc.)   & 2 & 9 & 6 & 7 & 9 \\
Portabilidad / formato             & 1 & 5 & 7 & 6 & 3 \\
Ruido eléctrico/EMI                & 1 & 7 & 6 & 6 & 8 \\
Escalabilidad (margen futuro)      & 2 & 9 & 6 & 5 & 7 \\
Confiabilidad global               & 2 & 8 & 7 & 5 & 8 \\
\midrule
\textbf{Total ponderado}           &   & \textbf{139} & \textbf{116} & \textbf{102} & \textbf{117} \\
\bottomrule
\end{tabular}
\end{table}

\begin{table}[H]
\centering
\caption{Matriz de selección de microcontrolador}
\begin{tabular}{lcccc}
\toprule
\textbf{Atributo} & \textbf{Peso} & \textbf{UNO} & \textbf{NANO} & \textbf{ESP32} \\
\midrule
Disponibilidad en UTEC                     & 3 & 10 & 9  & 5  \\
Integración con servos/5 V                 & 3 & 9  & 9  & 6  \\
Ecosistema y soporte en curso              & 2 & 10 & 9  & 7  \\
Costo                                      & 2 & 8  & 9  & 8  \\
Tamaño                                     & 1 & 7  & 10 & 8  \\
Rendimiento (CPU/RAM)                      & 1 & 6  & 6  & 10 \\
Conectividad (UART extra/WiFi/BLE)         & 1 & 3  & 3  & 10 \\
Consumo (menor = mejor)                    & 1 & 8  & 9  & 5  \\
Robustez en banco (taller/educativo)       & 1 & 8  & 7  & 7  \\
Expansión de E/S y temporizadores          & 1 & 8  & 7  & 9  \\
\midrule
\textbf{Total ponderado}                 &   & \textbf{133} & \textbf{132} & \textbf{112} \\
\bottomrule
\end{tabular}
\end{table}

\subsection{Galgas y tolerancias}
% Descripción de pruebas y cómo se midió. Incluir figuras si corresponde.

Recolección de mediciones a partir de 

\begin{figure}[H]
  \centering
  
  \caption{Galgas para medición de tolerancias. Fuente: elaboración própia}\label{fig:galgas}
\end{figure}

\begin{table}[H]
\centering
\caption{Galgas AR en PLA (agujero redondo, \si{mm})}
\begin{tabular}{l*{11}{S[table-format=2.2]}}
\toprule
{Med.} & {9.5} & {9.6} & {9.7} & {9.8} & {9.9} & {10.0} & {10.1} & {10.2} & {10.3} & {10.4} & {10.5} \\
\midrule
Dis. & 9.5 & 9.6 & 9.7 & 9.8 & 9.9 & 10.0 & 10.1 & 10.2 & 10.3 & 10.4 & 10.5 \\
Real  & 9.0  & 9.1  & 9.2  & 9.3  & 9.4  & 9.5  & 9.6   & 9.7   & 9.8   & 9.9   & 10.0   \\
\bottomrule
\end{tabular}
\end{table}

% ==== 2) AC – PLA (agujero cuadrado, PLA) ====
\begin{table}[H]
\centering
\caption{Galgas AC en PLA (agujero cuadrado, \si{mm})}
\begin{tabular}{l*{11}{S[table-format=2.2]}}
\toprule
{Med.} & {9.5} & {9.6} & {9.7} & {9.8} & {9.9} & {10.0} & {10.1} & {10.2} & {10.3} & {10.4} & {10.5} \\
\midrule
Dis. & 9.5 & 9.6 & 9.7 & 9.8 & 9.9 & 10.0 & 10.1 & 10.2 & 10.3 & 10.4 & 10.5 \\
Real     & 9.4  & 9.5  & 9.6  & 9.7  & 9.8  & 9.9   & 10.0   & 10.1   & 10.2   & 10.3   & 10.4   \\
\bottomrule
\end{tabular}
\end{table}

% ==== 3) PR – PLA (perno redondo, PLA) ====
\begin{table}[H]
\centering
\caption{Galgas PR en PLA (perno redondo, \si{mm})}
\begin{tabular}{l*{11}{S[table-format=2.2]}}
\toprule
{Med.} & {9.5} & {9.6} & {9.7} & {9.8} & {9.9} & {10.0} & {10.1} & {10.2} & {10.3} & {10.4} & {10.5} \\
\midrule
Dis. & 9.5 & 9.6 & 9.7 & 9.8 & 9.9 & 10.0 & 10.1 & 10.2 & 10.3 & 10.4 & 10.5 \\
Real     & 9.3  & 9.4  & 9.5  & 9.6  & 9.7  & 9.8   & 9.9   & 10.0   & 10.1   & 10.2   & 10.3   \\
\bottomrule
\end{tabular}
\end{table}

% ==== 4) PC – PLA (perno cuadrado, PLA) ====
\begin{table}[H]
\centering
\caption{Galgas PC en PLA (perno cuadrado, \si{mm})}
\begin{tabular}{l*{11}{S[table-format=2.2]}}
\toprule
{Med} & {9.5} & {9.6} & {9.7} & {9.8} & {9.9} & {10.0} & {10.1} & {10.2} & {10.3} & {10.4} & {10.5} \\
\midrule
Dis. & 9.5 & 9.6 & 9.7 & 9.8 & 9.9 & 10.0 & 10.1 & 10.2 & 10.3 & 10.4 & 10.5 \\
Real     & 9.7  & 9.8  & 9.9  & 10.0  & 10.1  & 10.2   & 10.3   & 10.4   & 10.5   & 10.6   & 10.7   \\
\bottomrule
\end{tabular}
\end{table}

% ==== 5) AR – MDF (agujero redondo, MDF) ====
\begin{table}[H]
\centering
\caption{Galgas AR en MDF (agujero redondo, \si{mm})}
\begin{tabular}{l*{11}{S[table-format=2.2]}}
\toprule
{Med.} & {9.5} & {9.6} & {9.7} & {9.8} & {9.9} & {10.0} & {10.1} & {10.2} & {10.3} & {10.4} & {10.5} \\
\midrule
Dis. & 9.5 & 9.6 & 9.7 & 9.8 & 9.9 & 10.0 & 10.1 & 10.2 & 10.3 & 10.4 & 10.5 \\
Real     & 9.5 & 9.6 & 9.7 & 9.8 & 9.9 & 10.0 & 10.1 & 10.2 & 10.3 & 10.4 & 10.5 \\
\bottomrule
\end{tabular}
\end{table}

% ==== 6) AC – MDF (agujero cuadrado, MDF) ====
\begin{table}[H]
\centering
\caption{Galgas AC en MDF (agujero cuadrado, \si{mm})}
\begin{tabular}{l*{11}{S[table-format=2.2]}}
\toprule
{Med.} & {9.5} & {9.6} & {9.7} & {9.8} & {9.9} & {10.0} & {10.1} & {10.2} & {10.3} & {10.4} & {10.5} \\
\midrule
Dis. & 9.5 & 9.6 & 9.7 & 9.8 & 9.9 & 10.0 & 10.1 & 10.2 & 10.3 & 10.4 & 10.5 \\
Real     & 9.5 & 9.6 & 9.7 & 9.8 & 9.9 & 10.0 & 10.1 & 10.2 & 10.3 & 10.4 & 10.5 \\
\bottomrule
\end{tabular}
\end{table}

\subsection{Diseños y prototipos}
% Versiones, cambios y fotos de las piezas.
\subsubsection{Modelo anterior}

\begin{figure}[H]
  \centering
  
  \caption{Version anterior diseñada con eslabones y efector de garra. Fuente: elaboración própia}
\end{figure}

Modelo descartado diseñado utilizando eslabones.

\subsubsection{Articulación}
Utilizando las tolerancias obtenidas a partir de las galgas. Se realizan diseños y prototipos para una articulación desmontable. 
\begin{figure}[H]
  \centering
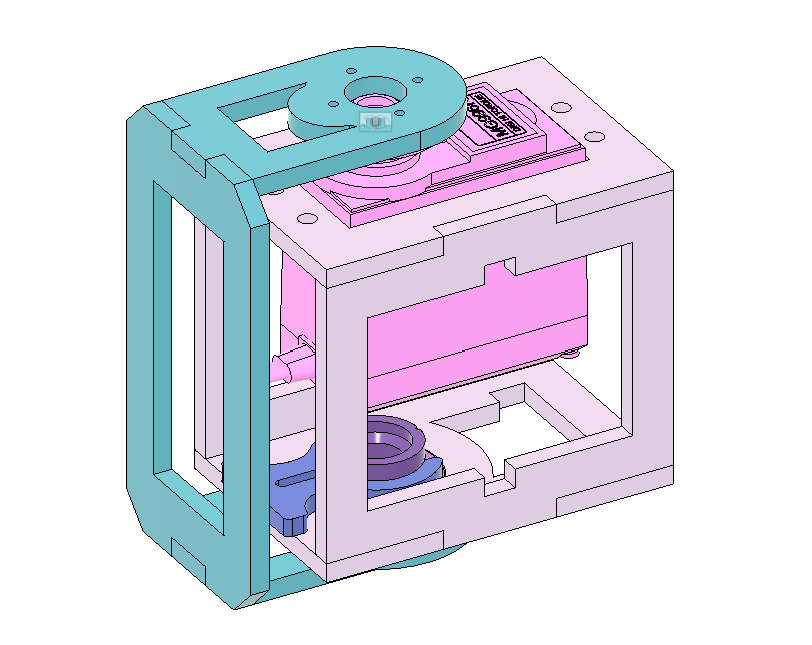
[picture p28: latex/Anexos/Articulacion/V2.png]
  
  \caption{Sistema de articulación desmontable. Fuente: elaboración própia}
\end{figure}

\begin{figure}[H]
  \centering
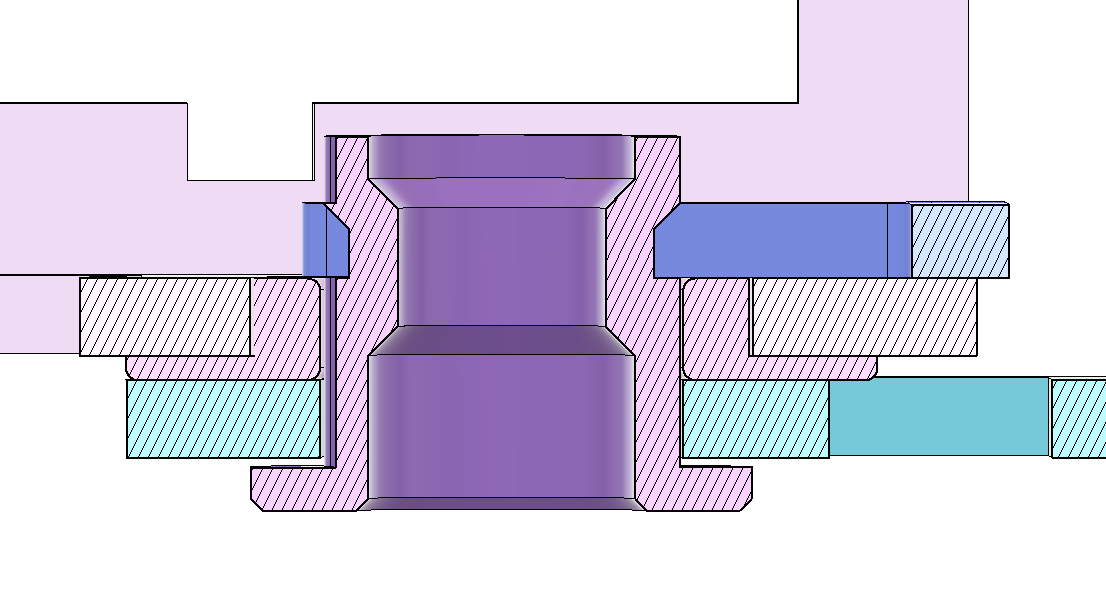
[picture p29: latex/Anexos/Articulacion/Perno V2.png]
  
  \caption{Corte transversal perno --- versión original. Fuente: elaboración própia}
\end{figure}

\begin{figure}[H]
  \centering
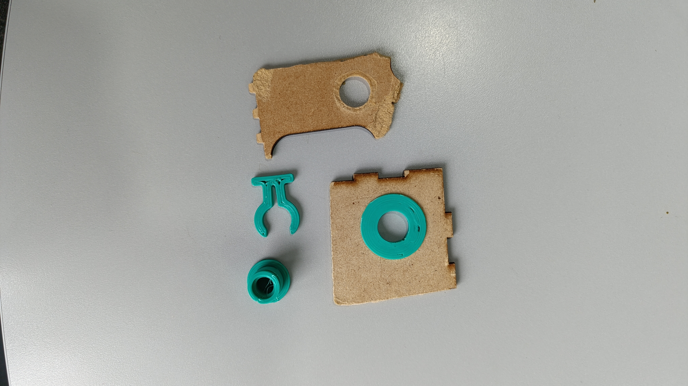
[picture p30: latex/Anexos/Pruebas/Prueba articulacion.jpg]
  
  \caption{Prueba de articulación con descartes de MDF. Fuente: elaboración própia}
\end{figure}

Una vez realizadas pruebas con el modelo inicial se observa un desgaste considerable en superficies con fricción PLA + MDF. Se decide incorporar otra interfaz de PLA en el diseño del pivote de la articulación para evitar el contacto PLA con el MDF. También se observa que el seguro se sale con facilidad al momento de aplicar fuerzas laterales a la articulación, por lo que se cambia el diseño de perno sólido por un diseño de perno y seguro calzante.

\begin{figure}[H]
  \centering
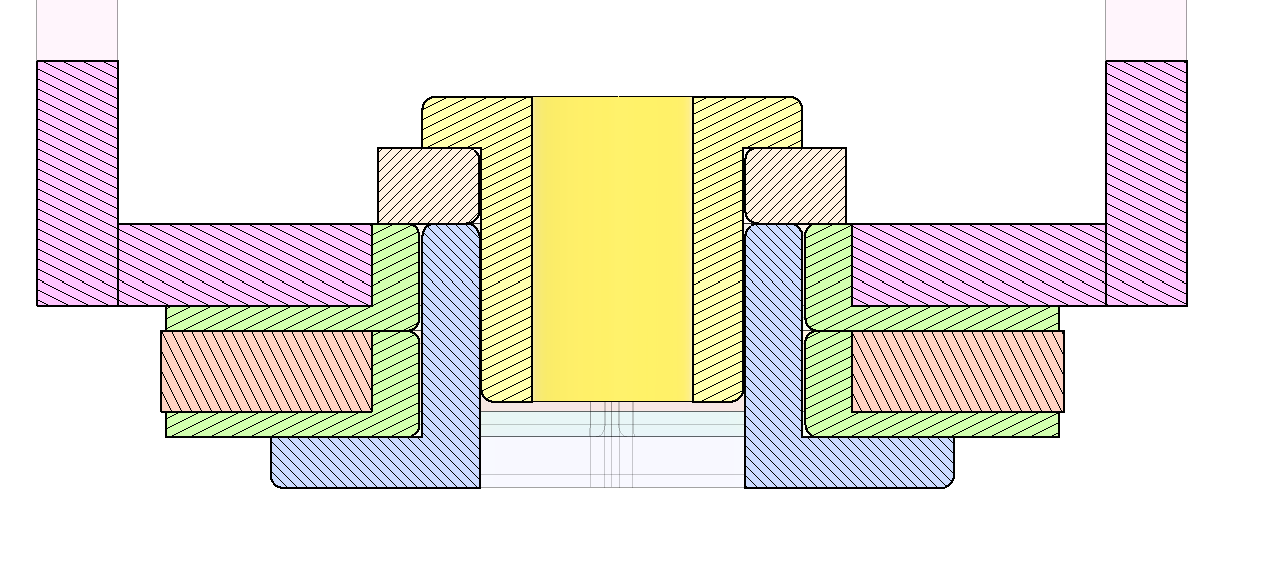
[picture p31: latex/Anexos/Articulacion/Perno V3.png]
  
  \caption{Corte transversal perno --- versión mejorada. Fuente: elaboración própia}
\end{figure}

En este diseño se evita el contacto de superficies de PLA y MDF entre sí, y se mejora la sujeción del seguro al perno al utilizar un tope regulable (amarillo) el cual se encastra a presión, ajustándo la fuerza de apriete de la articulación en el proceso. Este ajuste es único, luego es el seguro quien se encarga del montaje y desmontaje de la articulación.

\subsubsection{Electroimán}

Se diseña y realiza el proceso de maquinado manual para la carcasa del electroimán. Se compra un segmento de barra de acero en Dinapoli para luego trabajar el material en un torno manual.

\begin{figure}[H]
  \centering
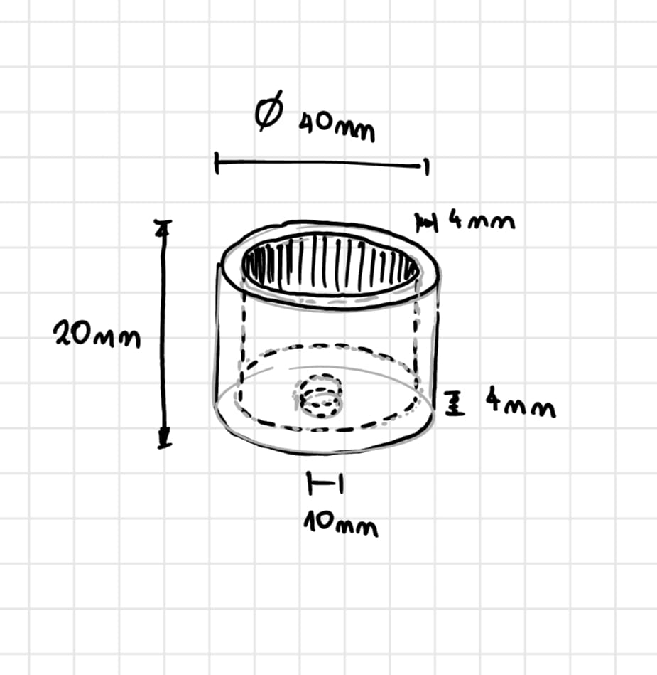
[picture p32: latex/Anexos/Torno/Plano.jpg]
  
  \caption{Plano de pieza a fabricar. Fuente: elaboración própia}
\end{figure}

\begin{figure}[H]
  \centering
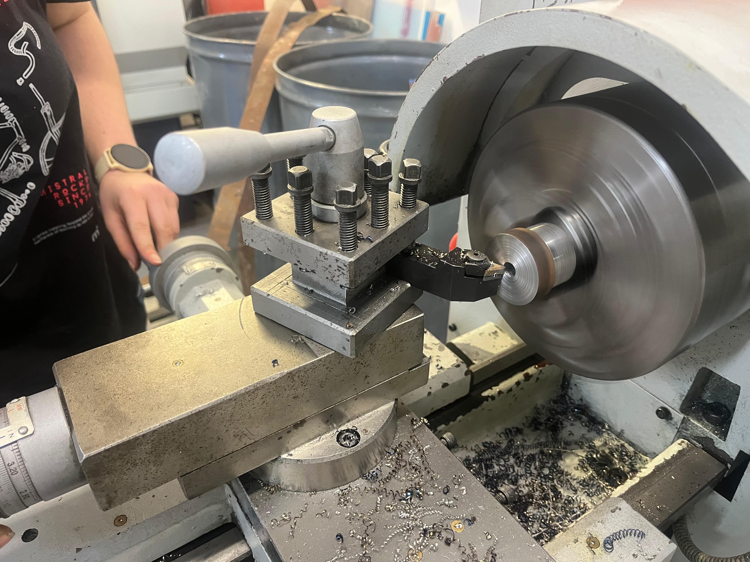
[picture p33: latex/Anexos/Torno/Maquinado.jpg]
  
  \caption{Maquinado de pieza en torno manual. Fuente: elaboración própia}
\end{figure}

\begin{figure}[H]
  \centering
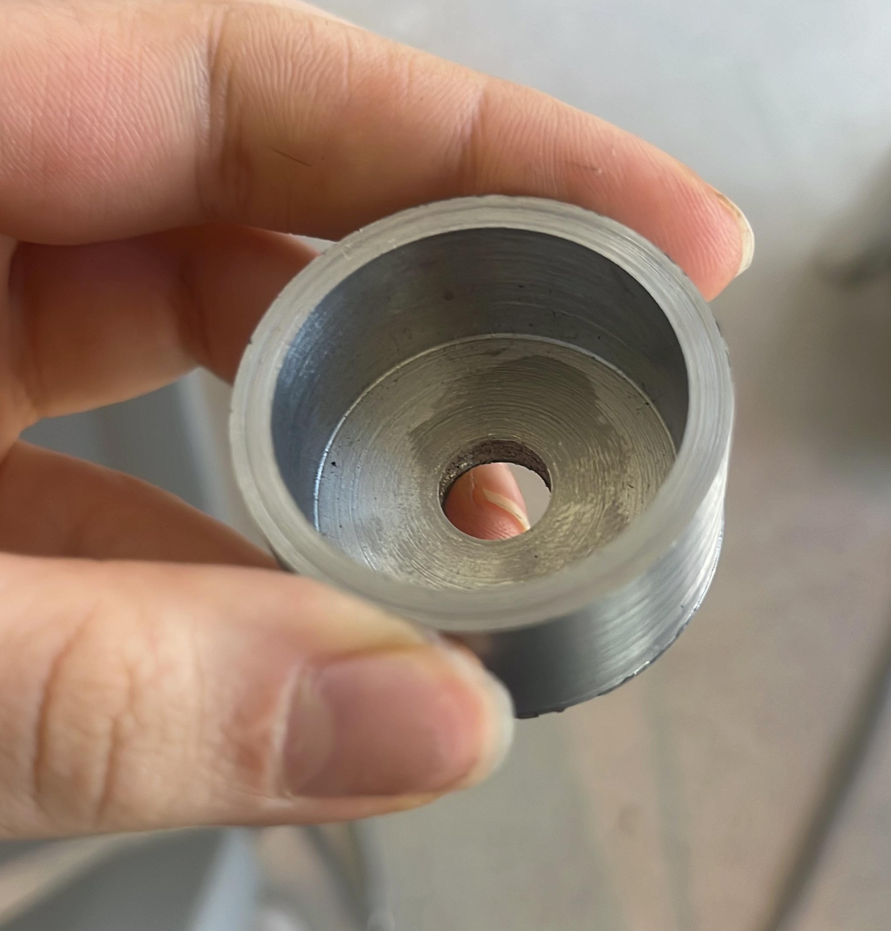
[picture p34: latex/Anexos/Torno/Pieza final.jpg]
  
  \caption{Resultado obtenido. Fuente: elaboración própia}
\end{figure}

La pieza se deja intecionalmente a sobremedida a fin de luego de continuar con el proceso de prototipado volver a maquinar el material para llevarlo hasta las medidas adecuadas.

\subsubsection{Controlador espejo}

\begin{figure}[H]
  \centering
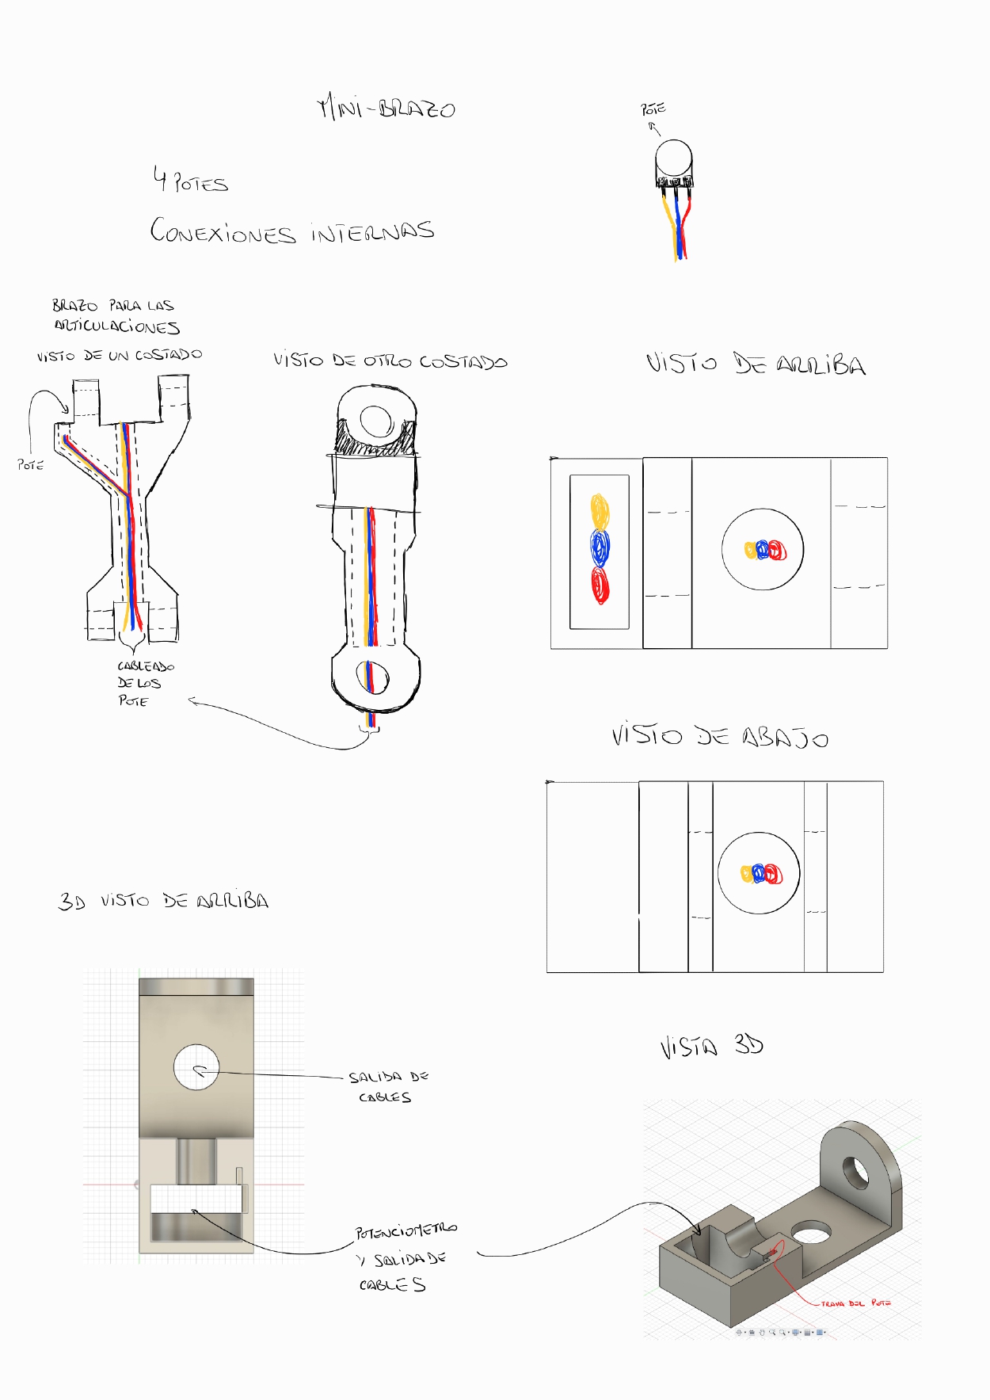
[picture p35: latex/Anexos/Controlador Espejo/Notas controlador.jpg]
  
  \caption{Proceso de diseño de controlador espejo. Fuente: elaboración própia}
\end{figure}

\section{Electrónica y programación}

\begin{figure}[H]
  \centering
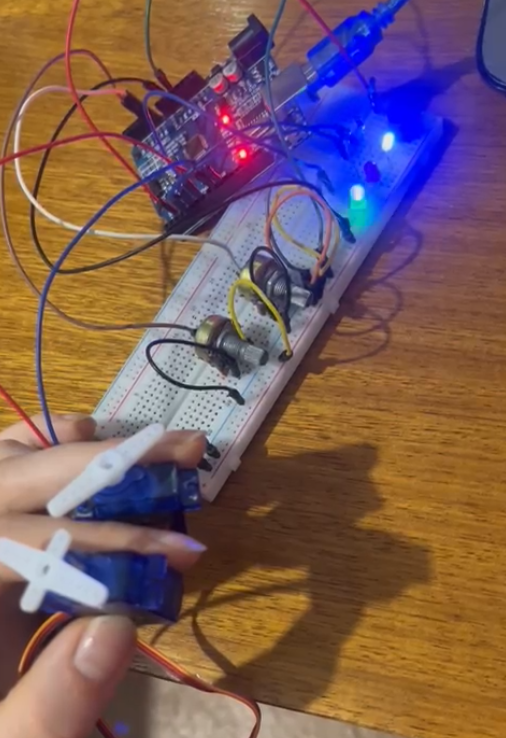
[picture p36: latex/Anexos/software/Pruebas de integración.png]
  
  \caption{Pruebas de integración entre código y componentes. Fuente: elaboración própia}
\end{figure}

\newpage

\appendix
\section{Inspiraciones y referencias de mercado}

\begin{multicols}{2}
% images

\begin{figure}[H]
  \centering
  
  \caption{Modelo con actuadores lineales.}\label{fig:insp.actuadores}
\end{figure}

Inspiración inicial tomada de GrabCAD para un modelo con actuadores actuadores lineales. Se observa como se posicionarían los actuadores dentro del modelo para lograr una mejor distribución de masa.

\vspace{3em}

\begin{figure}[H]
  \centering
  
  \caption{Modelo hibrido/hidráulico.}\label{fig:insp.oruga}
\end{figure}

Modelo mixto con servomotores y actuadores lineales encontrado en GrabCAD, primera consideración para el uso de eslabones y articulaciones. En este modelo se aprecia la restricción del movimiento de la acticulación final del manipulador.

\begin{figure}[H]
  \centering
  
  \caption{Manipulador por garra y servomotor.}\label{fig:insp.orugaGarra}
\end{figure}

Modelo aparte del manipulador con el servomotor sg90 y la garra. A partir de este modelo se considera el uso de un servomotor más pequeño para aprovechar que el manipulador no requiere tanta fuerza de agarre y delegar los servomotores más potentes mg996r a realizar el movimiento de las articulaciones. 

\begin{figure}[H]
  \centering
  
  \caption{Sistema de eslabones.}\label{fig:insp.eslabones}
\end{figure}

Otra inspiración para implementar el uso de eslabones en el brazo robótico ya con el uso de servomotores mg996r (encontrado en GrabCAD)

\begin{figure}[H]
  \centering
  
  \caption{Sistema de eslabones con mayor libertad.}\label{fig:insp.eslabones2}
\end{figure}

Una idea más general del posicionamiento de los eslabones porporcionado por el creador de contenido `thang010146' en YouTube. Este modeo cuenta con el grado de libertad faltante en modelos anteriores

\begin{figure}[H]
  \centering
  
  \caption{Modelo en MDF.}\label{fig:insp.mdf}
\end{figure}

Implemetación de un brazo robótico con especificaciones similares a las buscadas y haciendo uso de materiales como MDF y tornillos. Se descubre que el modelo pertenece a una empresa Mejicana llamada Robodacta, y que distribuyen este brazo como un kit de aprendizaje ensamblable.

\begin{figure}[H]
  \centering
  
  \caption{Modelo similar en plástico.}\label{fig:insp.plastico}
\end{figure}

Modelo muy similar al anterior, haciendo uso de materiales plásticos y tornillos, comercializado en Uruguay por Mercado Libre.

\begin{figure}[H]
  \centering
  
  \caption{Controlador espejo con potenciometros}\label{fig:insp.control}
\end{figure}
Inspiración dedicada a la realización de un control `espejo' para comandar el brazo articulado, haciendo usod e potenciometros los cuales controlan el ángulo de cada articulación.

\begin{figure}[H]
  \centering
  
  \caption{Control por joystick}\label{fig:insp.joystick}
\end{figure}

Modelo original de Robodacta, el cual se encuentra publicado en su sitio web. Este cuenta con un control de joystick para comandar el brazo articulado.

\begin{figure}[H]
  \centering
  
  \caption{Modelo impreso con control espejo}\label{fig:insp.impreso}
\end{figure}

Modelo impreso de código libre por el creador de contenido `Build Some Stuff' con un sistema de control espejo similar al mostrado anteriormente. Dispone de una serie de videos mostrando materiales, ensamblaje, software y uso del brazo articulado con su controlador. 

\end{multicols}

\subsection{Código}\label{apendice:codigo}

\begin{verbatim}
#define F_CPU 16000000UL
#include <avr/io.h>
#include <util/delay.h>
#include <avr/interrupt.h>
#include <stdbool.h>

/* ==== Pines ==== */
#define LED_ROJO   PD4
#define LED_VERDE  PD5
#define LED_AZUL   PD7
#define BUZZER     PD3
#define ELECTRO    PB0

#define SERVO1_PIN PB1  // D9
#define SERVO2_PIN PB2  // D10
#define SERVO3_PIN PD6  // D6
#define SERVO4_PIN PD7  // D7

#define SERVO_MIN_US 1000
#define SERVO_MAX_US 2000
#define DEAD_ZONE 2  // grados

/* ==== Variables globales ==== */
volatile uint16_t servo3_pulse = 1500;
volatile uint16_t servo4_pulse = 1500;

bool modoManual = true;

/* ===== UART ===== */
void uart_init(unsigned int ubrr) {
	UBRR0H = (unsigned char)(ubrr>>8);
	UBRR0L = (unsigned char)ubrr;
	UCSR0B = (1<<TXEN0) | (1<<RXEN0) | (1<<RXCIE0);
	UCSR0C = (1<<UCSZ01) | (1<<UCSZ00);
}
void uart_send(char c){
	while(!(UCSR0A & (1<<UDRE0)));
	UDR0 = c;
}
volatile char rx_char = 0;
ISR(USART_RX_vect){
	rx_char = UDR0;
	if(rx_char == 'm') modoManual = true;
	if(rx_char == 'a') modoManual = false;
}

/* ===== ADC ===== */
void adc_init(){
	ADMUX = (1<<REFS0); // AVcc
	ADCSRA = (1<<ADEN)|(1<<ADPS2)|(1<<ADPS1)|(1<<ADPS0);
}
uint16_t adc_read(uint8_t ch){
	ADMUX = (ADMUX & 0xF0) | (ch & 0x0F);
	ADCSRA |= (1<<ADSC);
	while(ADCSRA & (1<<ADSC));
	return ADC;
}

/* ===== Servos ===== */
void servo12_init(){
	ICR1 = 39999;
	TCCR1A = (1<<COM1A1)|(1<<COM1B1)|(1<<WGM11);
	TCCR1B = (1<<WGM13)|(1<<WGM12)|(1<<CS11);
	DDRB |= (1<<SERVO1_PIN)|(1<<SERVO2_PIN);
}
void servo1_set(uint8_t angle){ 
  OCR1A = (SERVO_MIN_US + angle*(SERVO_MAX_US-SERVO_MIN_US)/180)*2; 
}
void servo2_set(uint8_t angle){ 
  OCR1B = (SERVO_MIN_US + angle*(SERVO_MAX_US-SERVO_MIN_US)/180)*2; 
  }

void servo34_init(){
	DDRD |= (1<<SERVO3_PIN)|(1<<SERVO4_PIN);
	TCCR2A = (1<<COM2A1)|(1<<COM2B1)|(1<<WGM21)|(1<<WGM20);
	TCCR2B = (1<<CS21);
}
void servo3_set(uint8_t angle){ 
  OCR2A = ((SERVO_MIN_US + angle*(SERVO_MAX_US-SERVO_MIN_US)/180)*2)/8; 
}
void servo4_set(uint8_t angle){ 
  OCR2B = ((SERVO_MIN_US + angle*(SERVO_MAX_US-SERVO_MIN_US)/180)*2)/8; 
}

/* ===== Buzzer ===== */
void beep(uint8_t n){
	for(uint8_t i=0;i<n;i++){
		PORTD |= (1<<BUZZER);
		_delay_ms(200);
		PORTD &= ~(1<<BUZZER);
		_delay_ms(150);
	}
}

/* ===== LEDs ===== */
void leds_off(){ PORTD &= ~((1<<LED_ROJO)|(1<<LED_VERDE)|(1<<LED_AZUL)); }

/* ===== MAIN ===== */
int main(void){
	DDRD |= (1<<LED_ROJO)|
          (1<<LED_VERDE)|
          (1<<LED_AZUL)|
          (1<<BUZZER)|
          (1<<SERVO3_PIN)|
          (1<<SERVO4_PIN);

	DDRB |= (1<<SERVO1_PIN)|
          (1<<SERVO2_PIN)|
          (1<<ELECTRO);
	adc_init();
	servo12_init();
	servo34_init();
	uart_init(103); // 9600 baudios
	sei();
	
	uint8_t last_angle[4] = {0,0,0,0};
	
	while(1){
		uint16_t pot[4];
		pot[0] = adc_read(0);
		pot[1] = adc_read(1);
		pot[2] = adc_read(2);
		pot[3] = adc_read(3);
		uint8_t angle[4];
		for(uint8_t i=0;i<4;i++) angle[i] = (pot[i]*180UL)/1023;
		
		if(modoManual){
			// punto muerto
			for(uint8_t i=0;i<4;i++){
				if(abs(angle[i]-last_angle[i])<DEAD_ZONE) angle[i] = last_angle[i];
			}
			servo1_set(angle[0]);
			servo2_set(angle[1]);
			servo3_set(angle[2]);
			servo4_set(angle[3]);
			
			// LEDs
			if(angle[0]!=last_angle[0] |
      | angle[1]!=last_angle[1] |
      | angle[2]!=last_angle[2] |
      | angle[3]!=last_angle[3])
			PORTD |= (1<<LED_VERDE);
			else
			PORTD &= ~(1<<LED_VERDE);
			
			if(angle[3]!=last_angle[3]) PORTD |= (1<<LED_AZUL);
			else PORTD &= ~(1<<LED_AZUL);
			
			last_angle[0]=angle[0];
      last_angle[1]=angle[1]; 
      last_angle[2]=angle[2];
      last_angle[3]=angle[3];
			
			} else {
			// Modo automático ejemplo
			static uint8_t step = 0;
			static uint16_t t = 0;
			if(++t>200){ 
				t=0;

				uint8_t autoSteps[4][4]={{0,0,0,0},
                                 {45,45,45,45},
                                 {90,90,90,90},
                                 {180,180,180,180}};
				servo1_set(autoSteps[step][0]);
				servo2_set(autoSteps[step][1]);
				servo3_set(autoSteps[step][2]);
				servo4_set(autoSteps[step][3]);
				PORTD |= (1<<LED_VERDE);
				if(autoSteps[step][3]>0) beep(2); 
				if(++step>=4) step=0;
			}
		}
		_delay_ms(10);
	}
}

\end{verbatim}
\end{document}
