HectorPereira/proyectoIntegrador2/latex/evidencias/evidencias.pdf

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

## 1. Resumen

Se aplicaron matrices de selección para decidir: mecanismo de actuación (se favorecieron servomotores frente a actuadores lineales e hidráulicos), y, entre servos, la comparación MG996R vs SG90; además, materialidad (MDF, PLA o híbrido), fuente de poder y microcontrolador (UNO/NANO/ESP32).

## 2. Metodología y cronograma

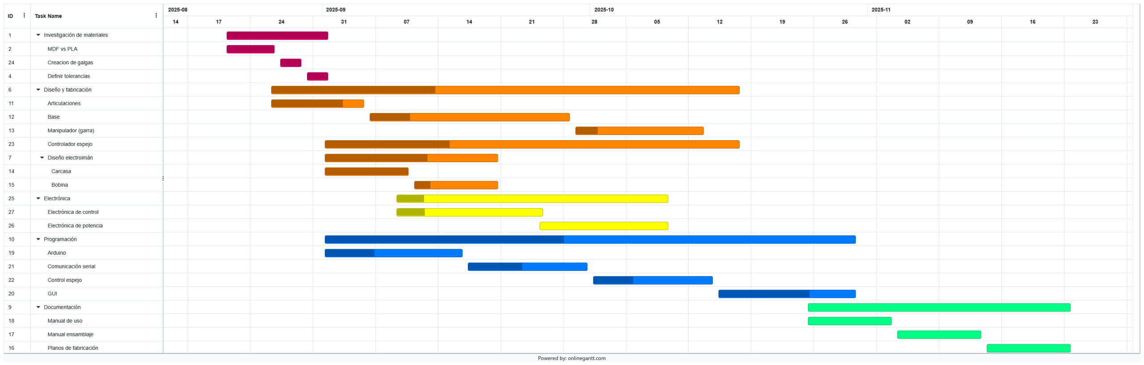
[picture p37: figure]

Figura 1: Diagrama de Gantt. Fuente: elaboración própia

## 3. Evidencias de diseño y fabricación

3.1. Materiales y métodos

Tabla 1: Matriz de selección: mecanismos de actuación
Atributo | Peso | Servom. | Eslab. | Actuad. lin. | Pistones hidr.
Distribución de peso | 1 | 6 | 8 | 9 | 10
Simplicidad | 3 | 10 | 6 | 5 | 4
Costo | 3 | 9 | 8 | 7 | 7
Reparabilidad | 2 | 9 | 7 | 6 | 5
Durabilidad | 2 | 8 | 5 | 4 | 3
Cap. de carga | 2 | 7 | 7 | 8 | 9
Velocidad | 1 | 8 | 8 | 5 | 4
Precisión | 1 | 8 | 7 | 6 | 5
Total ponderado | | 127 | 103 | 92 | 86

Tabla 2: Matriz de selección entre servos MG996R y SG90
Atributo | Peso | Servo MG996R Servo SG90
Fuerza (torque) | 4 | 10 | 3
Tamaño (dimensiones) | 2 | 6 | 9
Peso (masa) | 2 | 5 | 9
Precio | 2 | 7 | 9
Durabilidad / materiales | 3 | 9 | 5
Precisión | 2 | 7 | 6
Velocidad (s/60°) | 1 | 6 | 9
Corriente (menor=mejor) | 2 | 4 | 8
Total ponderado | | 131 | 118

Tabla 3: Matriz de selección: MDF vs Impresión 3D vs Híbrido (MDF+PLA)

Atributo | Peso | MDF | PLA | MDF+PLA
Tiempo de fabricación (menor=mejor) | 3 | 9 | 3 | 8
Costo de materiales (menor=mejor) | 2 | 9 | 5 | 8
Facilidad de iteración/retrabajo | 3 | 10 | 4 | 9
Precisión / tolerancias | 2 | 6 | 8 | 8
Comportamiento a la fricción | 3 | 3 | 8 | 8
Rigidez / resistencia estructural | 3 | 7 | 6 | 8
Peso total (menor=mejor) | 1 | 6 | 7 | 7
Complejidad de ensamblaje (menor=mejor) | 1 | 8 | 6 | 6
Disponibilidad de recursos (UTEC) | 1 | 10 | 6 | 9
Acabado / ajuste nal | 1 | 6 | 7 | 7
Total ponderado | | 147 | 115 | 160

Tabla 4: Matriz de selección de fuente de poder
Atributo | Peso | PC | LED Genéricas | Fuente de lab.
Corriente continua y picos | 3 | 9 | 7 | 6 | 8
Disponibilidad + costo | 2 | 10 | 7 | 8 | 3
Facilidad de integración/ensamble | 2 | 6 | 9 | 4 | 5
Regulación y rizado | 2 | 8 | 6 | 7 | 9
Protecciones (OCP/OVP/OTP, etc.) | 2 | 9 | 6 | 7 | 9
Portabilidad / formato | 1 | 5 | 7 | 6 | 3
Ruido eléctrico/EMI | 1 | 7 | 6 | 6 | 8
Escalabilidad (margen futuro) | 2 | 9 | 6 | 5 | 7
Conabilidad global | 2 | 8 | 7 | 5 | 8
Total ponderado | | 139 | 116 | 102 | 117

Tabla 5: Matriz de selección de microcontrolador
Atributo | Peso | UNO | NANO | ESP32
Disponibilidad en UTEC | 3 | 10 | 9 | 5
Integración con servos/5 V | 3 | 9 | 9 | 6
Ecosistema y soporte en curso | 2 | 10 | 9 | 7
Costo | 2 | 8 | 9 | 8
Tamaño | 1 | 7 | 10 | 8
Rendimiento (CPU/RAM) | 1 | 6 | 6 | 10
Conectividad (UART extra/WiFi/BLE) | 1 | 3 | 3 | 10
Consumo (menor = mejor) | 1 | 8 | 9 | 5
Robustez en banco (taller/educativo) | 1 | 8 | 7 | 7
Expansión de E/S y temporizadores | 1 | 8 | 7 | 9
Total ponderado | | 133 | 132 | 112
3.2. Galgas y tolerancias

Recolección de mediciones a partir de

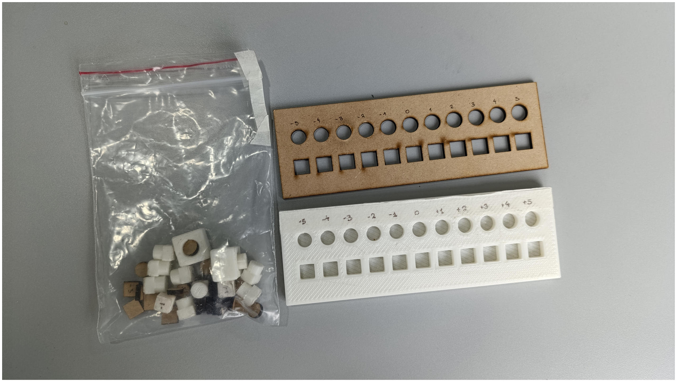
[picture p38: figure]

Figura 2: Galgas para medición de tolerancias. Fuente: elaboración própia

Tabla 6: Galgas AR en PLA (agujero redondo, mm)
Med. | 9.5 | 9.6 | 9.7 | 9.8 | 9.9 | 10.0 | 10.1 | 10.2 | 10.3 | 10.4 | 10.5
Dis. | 9.50 | 9.60 | 9.70 | 9.80 | 9.90 10.00 10.10 10.20 10.30 10.40 10.50
Real | 9.00 | 9.10 | 9.20 | 9.30 | 9.40 | 9.50 | 9.60 | 9.70 | 9.80 | 9.90 10.00

Tabla 7: Galgas AC en PLA (agujero cuadrado, mm)
Med. | 9.5 | 9.6 | 9.7 | 9.8 | 9.9 | 10.0 | 10.1 | 10.2 | 10.3 | 10.4 | 10.5
Dis. | 9.50 | 9.60 | 9.70 | 9.80 | 9.90 10.00 10.10 10.20 10.30 10.40 10.50
Real | 9.40 | 9.50 | 9.60 | 9.70 | 9.80 | 9.90 10.00 10.10 10.20 10.30 10.40

Tabla 8: Galgas PR en PLA (perno redondo, mm)
Med. | 9.5 | 9.6 | 9.7 | 9.8 | 9.9 | 10.0 | 10.1 | 10.2 | 10.3 | 10.4 | 10.5
Dis. | 9.50 | 9.60 | 9.70 | 9.80 | 9.90 10.00 10.10 10.20 10.30 10.40 10.50
Real | 9.30 | 9.40 | 9.50 | 9.60 | 9.70 | 9.80 | 9.90 10.00 10.10 10.20 10.30

Tabla 9: Galgas PC en PLA (perno cuadrado, mm)
Med | 9.5 | 9.6 | 9.7 | 9.8 | 9.9 | 10.0 | 10.1 | 10.2 | 10.3 | 10.4 | 10.5
Dis. | 9.50 | 9.60 | 9.70 | 9.80 | 9.90 10.00 10.10 10.20 10.30 10.40 10.50
Real | 9.70 | 9.80 | 9.90 10.00 10.10 10.20 10.30 10.40 10.50 10.60 10.70

Tabla 10: Galgas AR en MDF (agujero redondo, mm)
Med. | 9.5 | 9.6 | 9.7 | 9.8 | 9.9 | 10.0 | 10.1 | 10.2 | 10.3 | 10.4 | 10.5
Dis. | 9.50 | 9.60 | 9.70 | 9.80 | 9.90 10.00 10.10 10.20 10.30 10.40 10.50
Real | 9.50 | 9.60 | 9.70 | 9.80 | 9.90 10.00 10.10 10.20 10.30 10.40 10.50

Tabla 11: Galgas AC en MDF (agujero cuadrado, mm)
Med. | 9.5 | 9.6 | 9.7 | 9.8 | 9.9 | 10.0 | 10.1 | 10.2 | 10.3 | 10.4 | 10.5
Dis. | 9.50 | 9.60 | 9.70 | 9.80 | 9.90 10.00 10.10 10.20 10.30 10.40 10.50
Real | 9.50 | 9.60 | 9.70 | 9.80 | 9.90 10.00 10.10 10.20 10.30 10.40 10.50

3.3. Diseños y prototipos
3.3.1. Modelo anterior


Figura 3: Version anterior diseñada con eslabones y efector de garra. Fuente: elaboración própia

Modelo descartado diseñado utilizando eslabones.

3.3.2. Articulación

Utilizando las tolerancias obtenidas a partir de las galgas. Se realizan diseños y prototipos para una articulación desmontable.

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

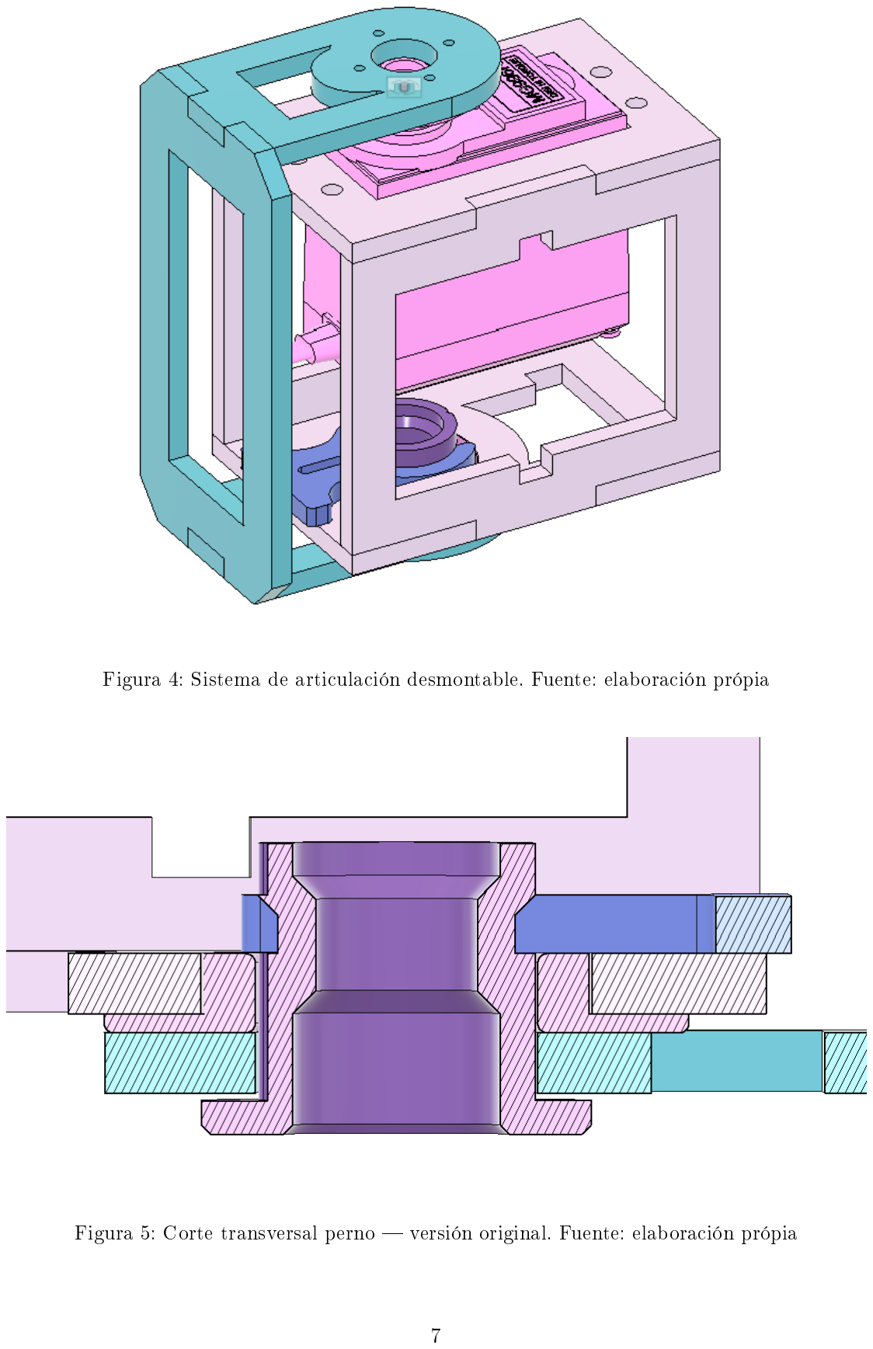
[picture p39: page 8]


Figura 6: Prueba de articulación con descartes de MDF. Fuente: elaboración própia

Una vez realizadas pruebas con el modelo inicial se observa un desgaste considerable en supercies con fricción PLA + MDF. Se decide incorporar otra interfaz de PLA en el diseño del pivote de la articulación para evitar el contacto PLA con el MDF. También se observa que el seguro se sale con facilidad al momento de aplicar fuerzas laterales a la articulación, por lo que se cambia el diseño de perno sólido por un diseño de perno y seguro calzante.

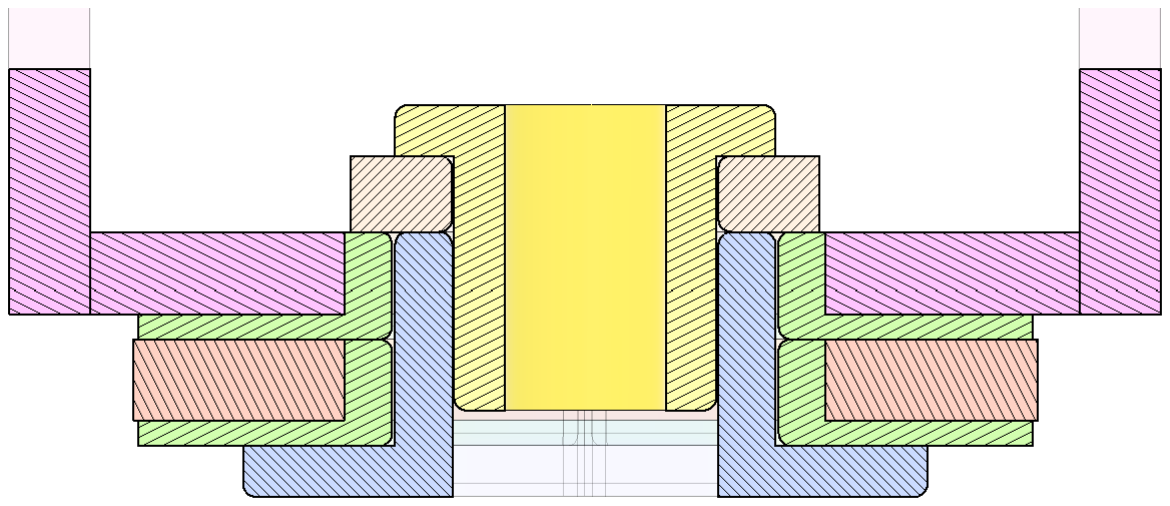
[picture p40: figure]

Figura 7: Corte transversal perno versión mejorada. Fuente: elaboración própia

En este diseño se evita el contacto de supercies de PLA y MDF entre sí, y se mejora la sujeción del seguro al perno al utilizar un tope regulable (amarillo) el cual se encastra a presión, ajustándo la fuerza de apriete de la articulación en el proceso. Este ajuste es único, luego es el seguro quien se encarga del montaje y desmontaje de la articulación.

3.3.3. Electroimán

Se diseña y realiza el proceso de maquinado manual para la carcasa del electroimán. Se compra un segmento de barra de acero en Dinapoli para luego trabajar el material en un torno manual.


Figura 8: Plano de pieza a fabricar. Fuente: elaboración própia

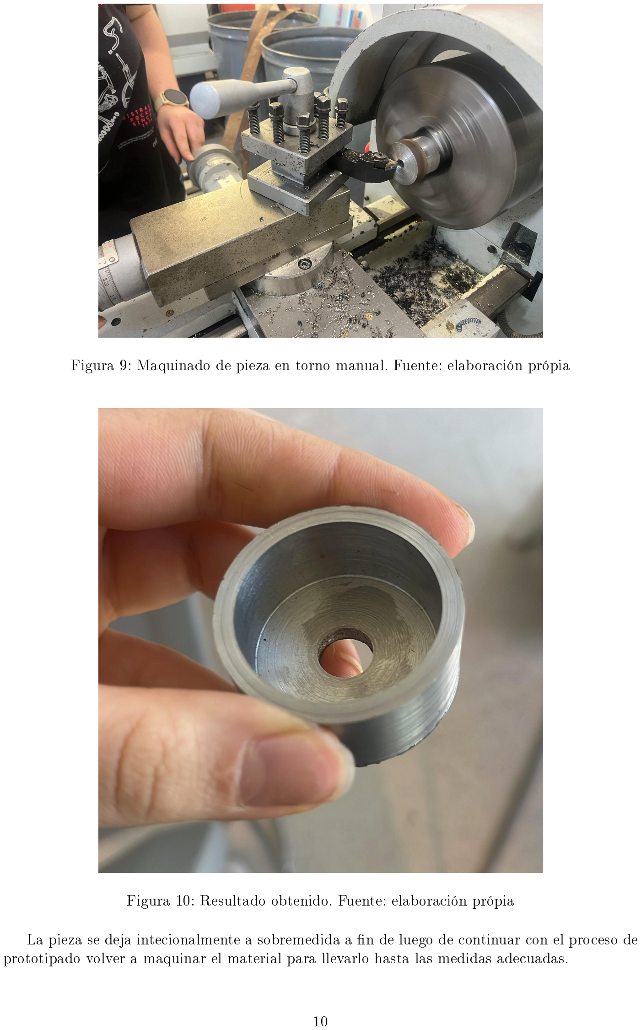
[picture p41: page 11]

Figura 9: Maquinado de pieza en torno manual. Fuente: elaboración própia

Figura 10: Resultado obtenido. Fuente: elaboración própia

La pieza se deja intecionalmente a sobremedida a n de luego de continuar con el proceso de prototipado volver a maquinar el material para llevarlo hasta las medidas adecuadas.

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


## A. Inspiraciones y referencias de mercado


Figura 13: Modelo con actuadores lineales.

Inspiración inicial tomada de GrabCAD para un modelo con actuadores actuadores lineales. Se observa como se posicionarían los actuadores dentro del modelo para lograr una mejor distribución de masa.

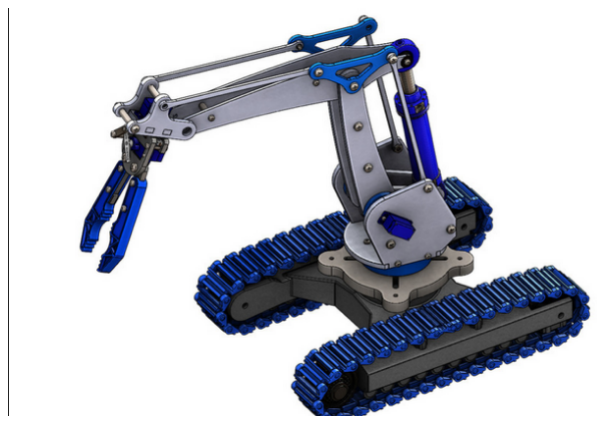
[picture p42: figure]

Figura 14: Modelo hibrido/hidráulico.

Modelo mixto con servomotores y actuadores lineales encontrado en GrabCAD, primera consideración para el uso de eslabones y articulaciones. En este modelo se aprecia la restricción del movimiento de la acticulación nal del manipulador.

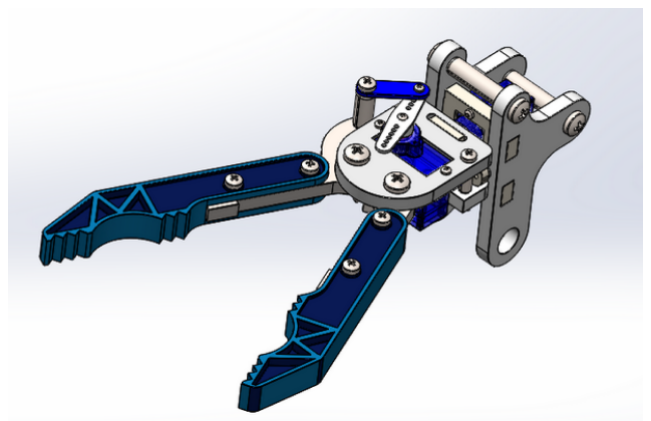
[picture p43: figure]

Figura 15: Manipulador por garra y servomotor.

Modelo aparte del manipulador con el servomotor sg90 y la garra. A partir de este modelo se considera el uso de un servomotor más pequeño para aprovechar que el manipulador no requiere tanta fuerza de agarre y delegar los servomotores más potentes mg996r a realizar el movimiento de las articulaciones.

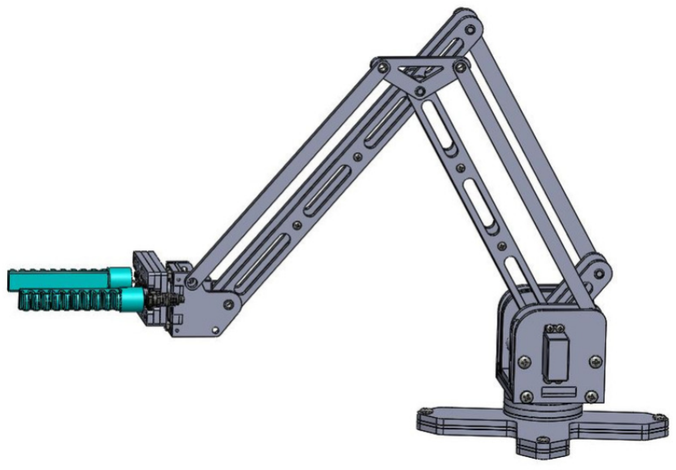
[picture p44: figure]

Figura 16: Sistema de eslabones.

Otra inspiración para implementar el uso de eslabones en el brazo robótico ya con el uso de servomotores mg996r (encontrado en Grab-CAD)


Figura 17: Sistema de eslabones con mayor libertad.

Una idea más general del posicionamiento de los eslabones porporcionado por el creador de contenido `thang010146' en YouTube. Este modeo cuenta con el grado de libertad faltante en modelos anteriores

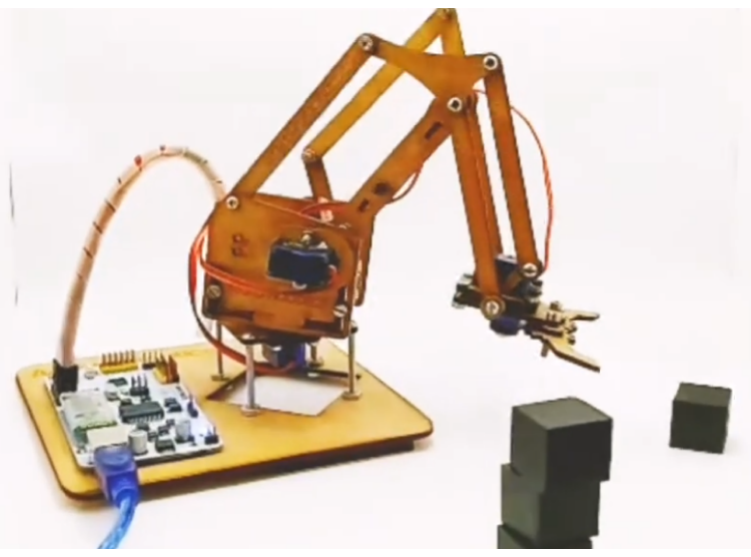
[picture p45: figure]

Figura 18: Modelo en MDF.

Implemetación de un brazo robótico con especicaciones similares a las buscadas y haciendo uso de materiales como MDF y tornillos. Se descubre que el modelo pertenece a una empresa Mejicana llamada Robodacta, y que distribuyen este brazo como un kit de aprendizaje ensamblable.

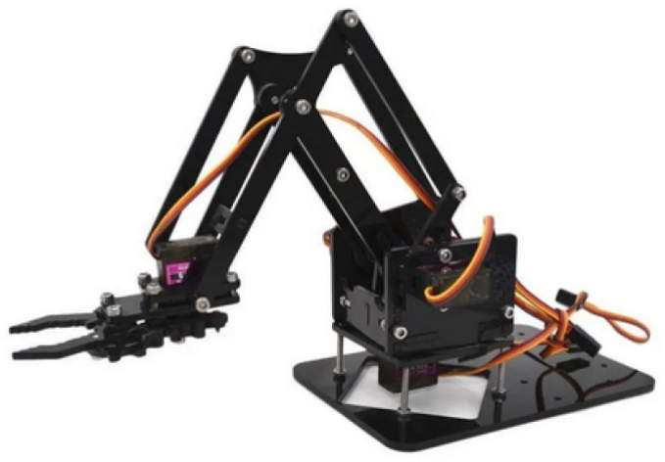
[picture p46: figure]

Figura 19: Modelo similar en plástico.

Modelo muy similar al anterior, haciendo uso de materiales plásticos y tornillos, comercializado en Uruguay por Mercado Libre.

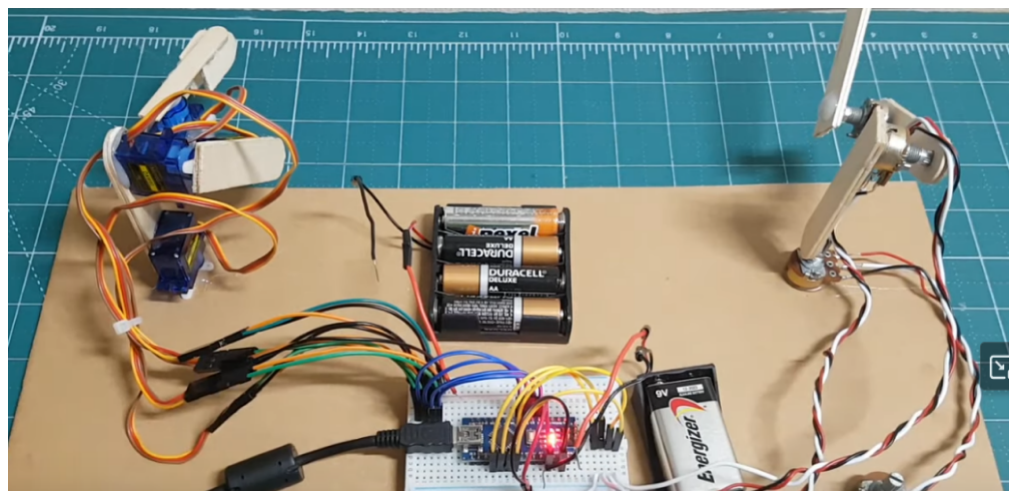
[picture p47: figure]

Figura 20: Controlador espejo con potenciometros

Inspiración dedicada a la realización de un control `espejo' para comandar el brazo articulado, haciendo usod e potenciometros los cuales controlan el ángulo de cada articulación.

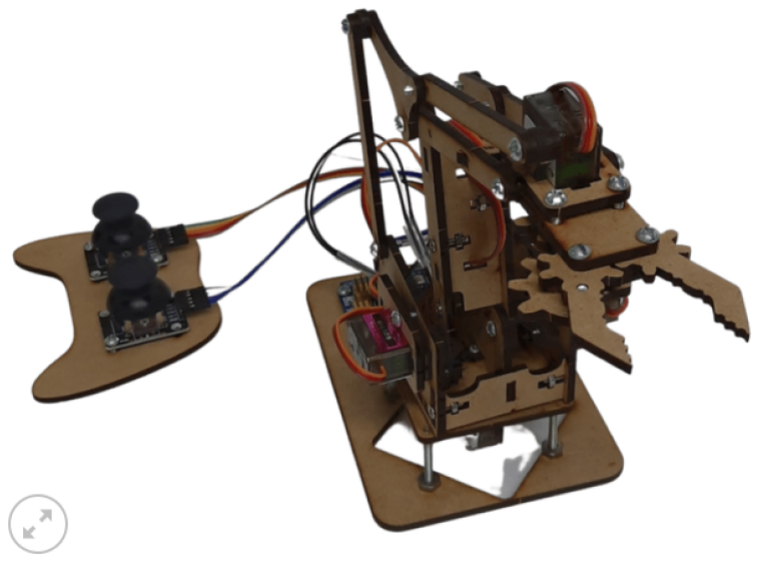
[picture p48: figure]

Figura 21: Control por joystick

Modelo original de Robodacta, el cual se encuentra publicado en su sitio web. Este cuenta con un control de joystick para comandar el brazo articulado.


Figura 22: Modelo impreso con control espejo

Modelo impreso de código libre por el creador de contenido `Build Some Stu' con un sistema de control espejo similar al mostrado anteriormente. Dispone de una serie de videos mostrando materiales, ensamblaje, software y uso del brazo articulado con su controlador.
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
