HectorPereira/proyectoIntegrador2/latex/Anexos/CAD/brazo.png

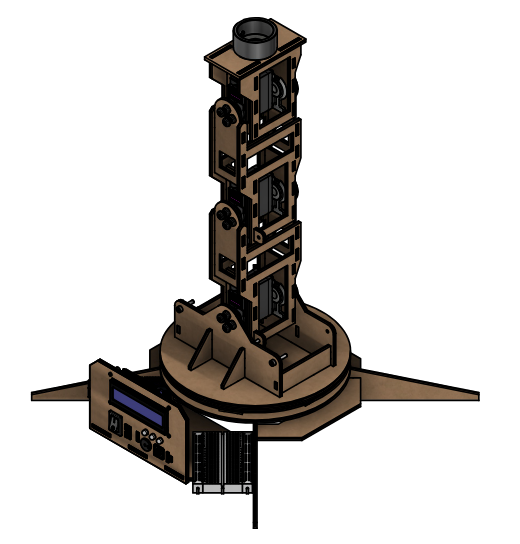
latex/Anexos/CAD/brazo.png
