HectorPereira/proyectoIntegrador2/latex/Anexos/CAD/despieceEspejoSimple.png

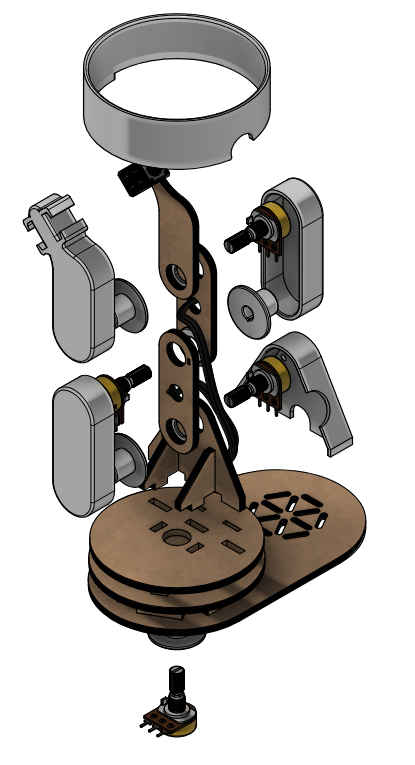
latex/Anexos/CAD/despieceEspejoSimple.png
