HectorPereira/proyectoIntegrador2/latex/Anexos/CAD/espejo.png

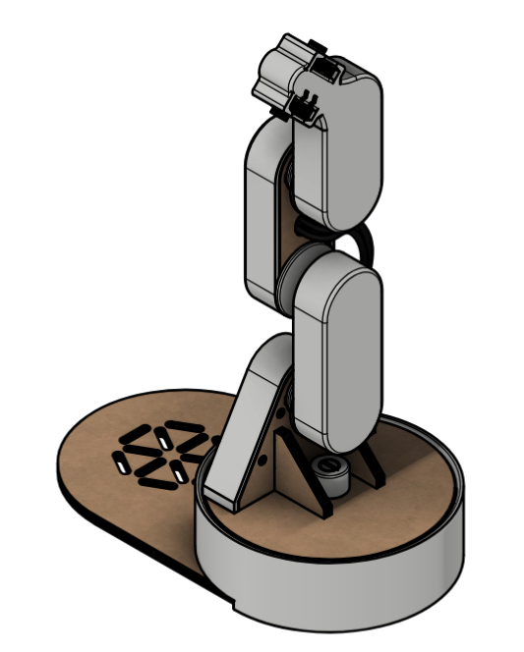
latex/Anexos/CAD/espejo.png
