HectorPereira/proyectoIntegrador2/latex/Anexos/CAD/espejoAcople.png

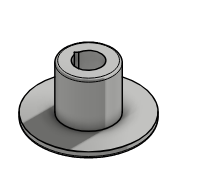
latex/Anexos/CAD/espejoAcople.png
