HectorPereira/proyectoIntegrador2/latex/Anexos/CAD/espejoBase.png

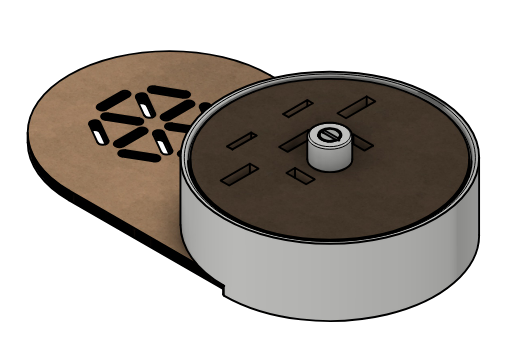
latex/Anexos/CAD/espejoBase.png
