HectorPereira/proyectoIntegrador2/latex/Anexos/CAD/espejoEslabon.png

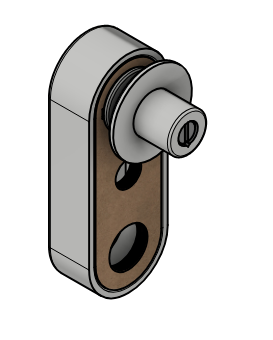
latex/Anexos/CAD/espejoEslabon.png
