HectorPereira/proyectoIntegrador2/latex/Anexos/CAD/espejoEslabonDes.png

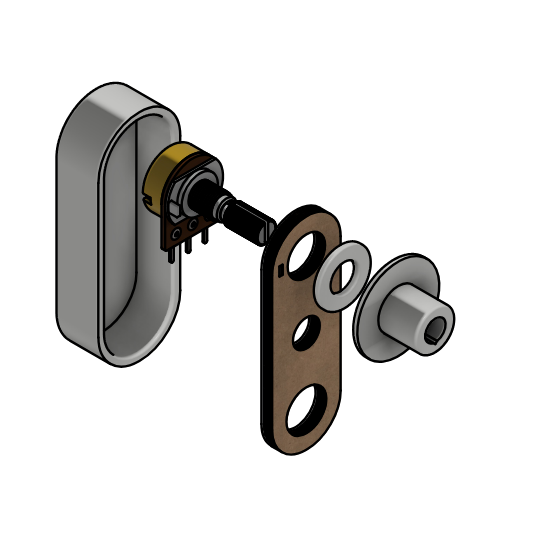
latex/Anexos/CAD/espejoEslabonDes.png
