HectorPereira/proyectoIntegrador2/latex/Anexos/CAD/espejoHombro.png

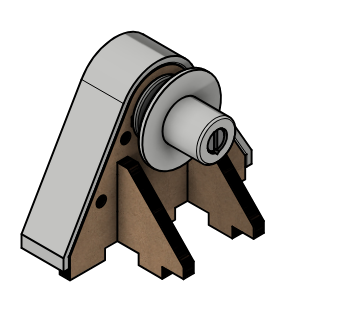
latex/Anexos/CAD/espejoHombro.png
