HectorPereira/proyectoIntegrador2/latex/Anexos/CAD/espejoHombroDefs.png

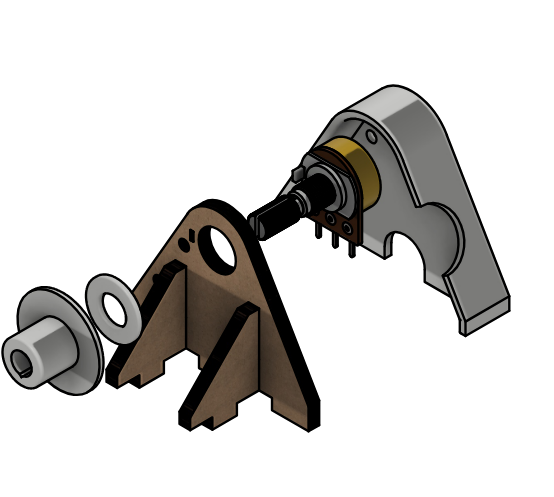
latex/Anexos/CAD/espejoHombroDefs.png
