HectorPereira/proyectoIntegrador2/latex/Anexos/CAD/espejoMuneca.png

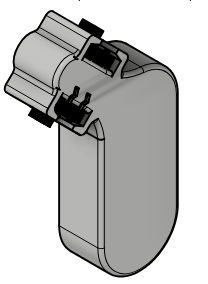
latex/Anexos/CAD/espejoMuneca.png
