HectorPereira/proyectoIntegrador2/latex/Anexos/CAD/espejoMunecaDes.png

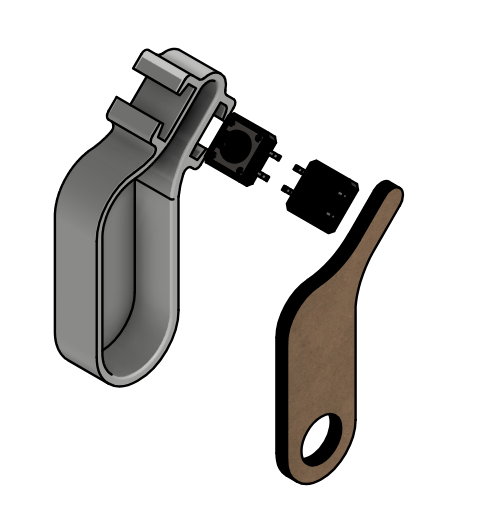
latex/Anexos/CAD/espejoMunecaDes.png
