HectorPereira/proyectoIntegrador2/latex/Anexos/CAD/espejoPote.png

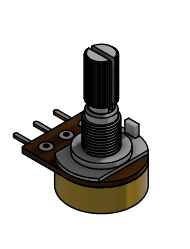
latex/Anexos/CAD/espejoPote.png
