HectorPereira/proyectoIntegrador2/latex/Anexos/CAD/espejoRealidad.png

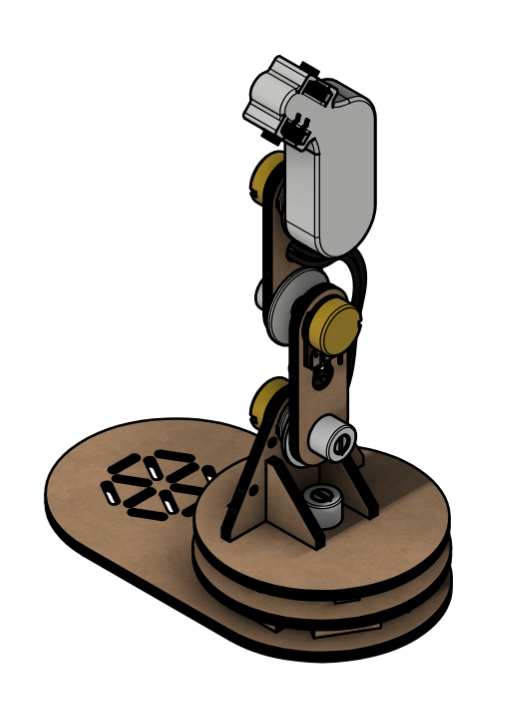
latex/Anexos/CAD/espejoRealidad.png
