HectorPereira/proyectoIntegrador2/latex/Anexos/CAD/fuenteAlim2.png

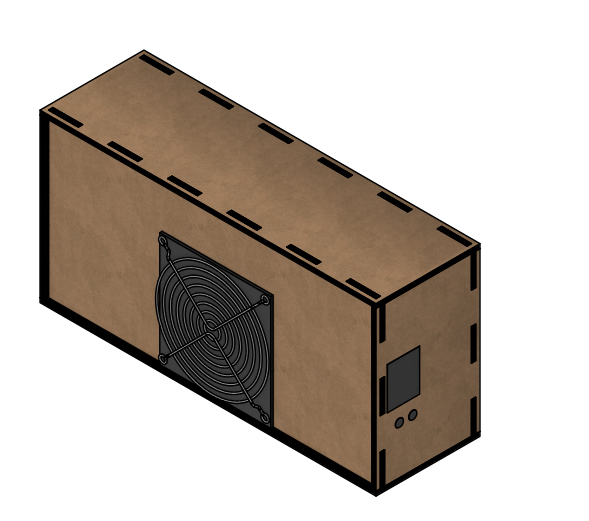
latex/Anexos/CAD/fuenteAlim2.png
