HectorPereira/proyectoIntegrador2/latex/Anexos/circuito/relay.webp

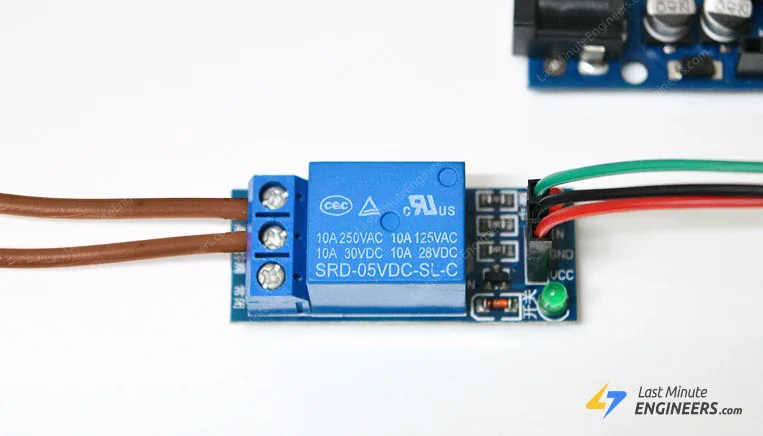
latex/Anexos/circuito/relay.webp
