HectorPereira/proyectoIntegrador2/latex/Anexos/fisico/demo.png

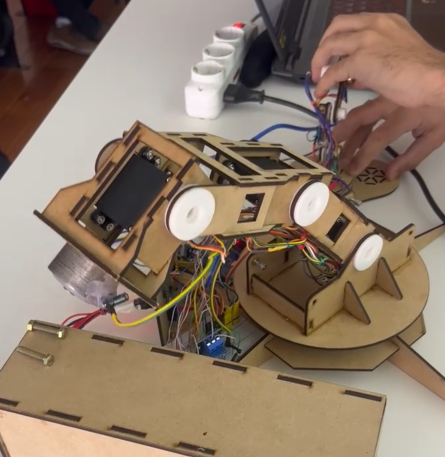
latex/Anexos/fisico/demo.png
