HectorPereira/proyectoIntegrador2/latex/Anexos/fisico/electroiman.png

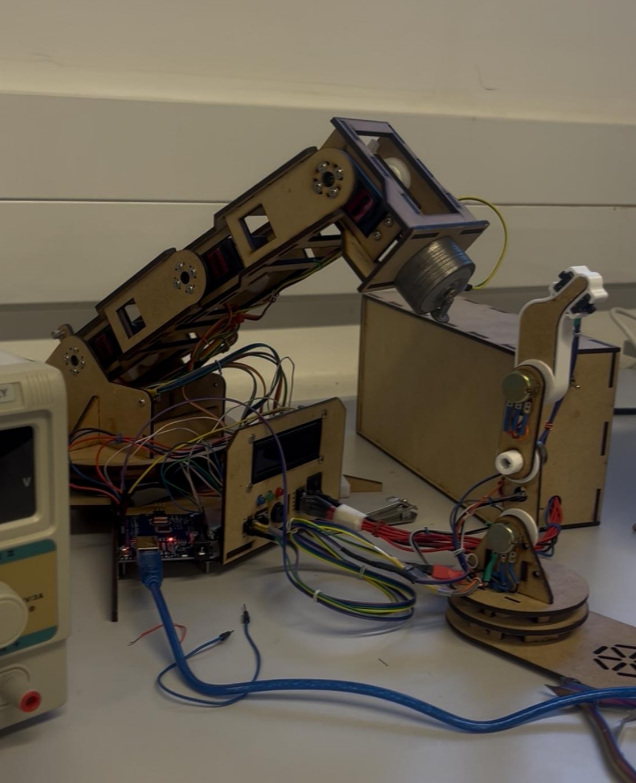
latex/Anexos/fisico/electroiman.png
