HectorPereira/proyectoIntegrador2/latex/Anexos/software/ventanaApp.png

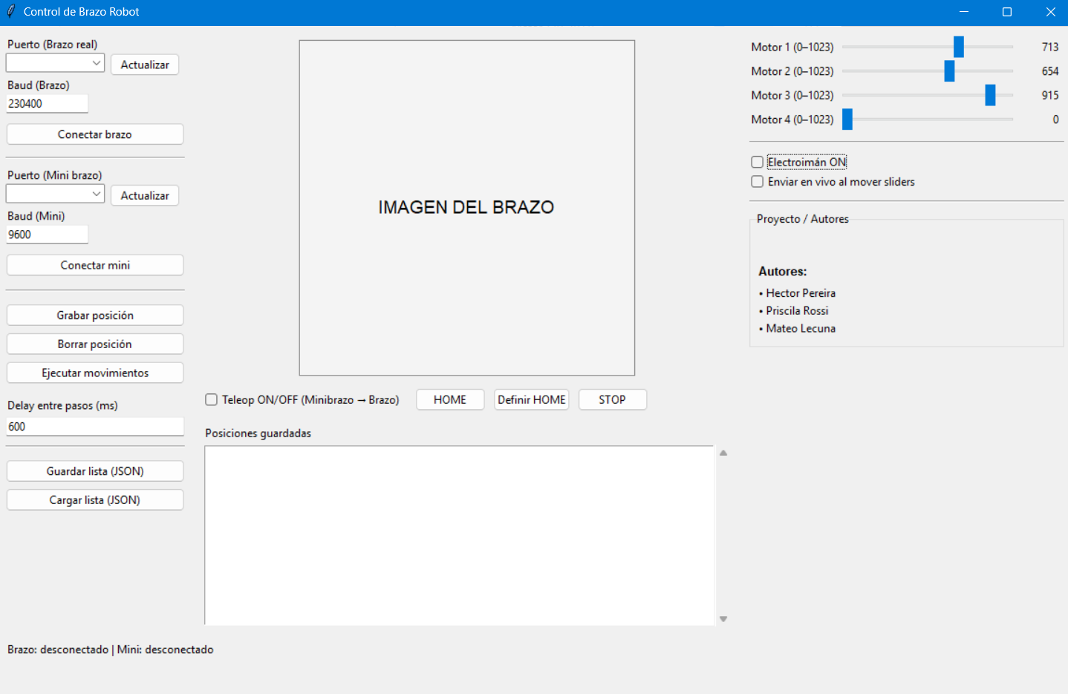
latex/Anexos/software/ventanaApp.png
