HectorPereira/proyectoIntegrador2/latex/evidencias 2/anexos/Brazo V3/Screenshot 2025-10-24 211305.png

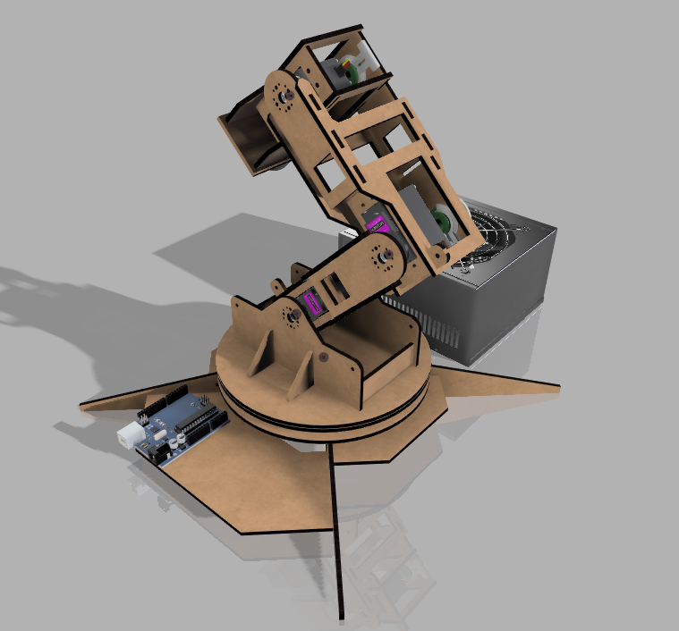
latex/evidencias 2/anexos/Brazo V3/Screenshot 2025-10-24 211305.png
