HectorPereira/proyectoIntegrador2/latex/evidencias 2/anexos/Controlador espejo V3/Screenshot 2025-10-22 213041.png

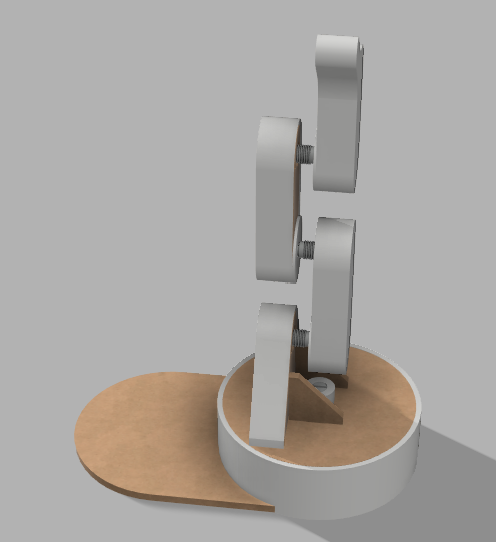
latex/evidencias 2/anexos/Controlador espejo V3/Screenshot 2025-10-22 213041.png
