HectorPereira/proyectoIntegrador2/latex/evidencias 2/anexos/Controlador espejo V3/WhatsApp Image 2025-10-24 at 16.07.16_919f81bd.jpg

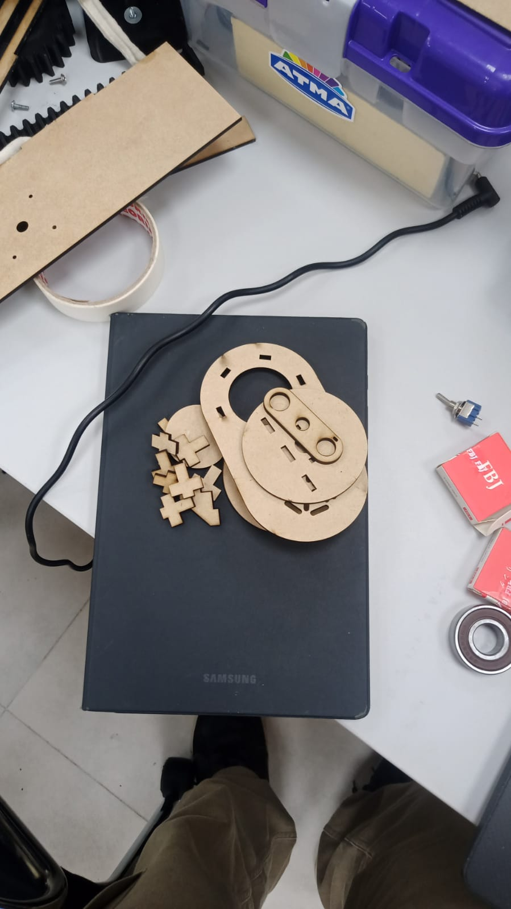
latex/evidencias 2/anexos/Controlador espejo V3/WhatsApp Image 2025-10-24 at 16.07.16_919f81bd.jpg
