HectorPereira/proyectoIntegrador2/latex/evidencias 2/anexos/Gripper/Screenshot 2025-10-25 161838.png

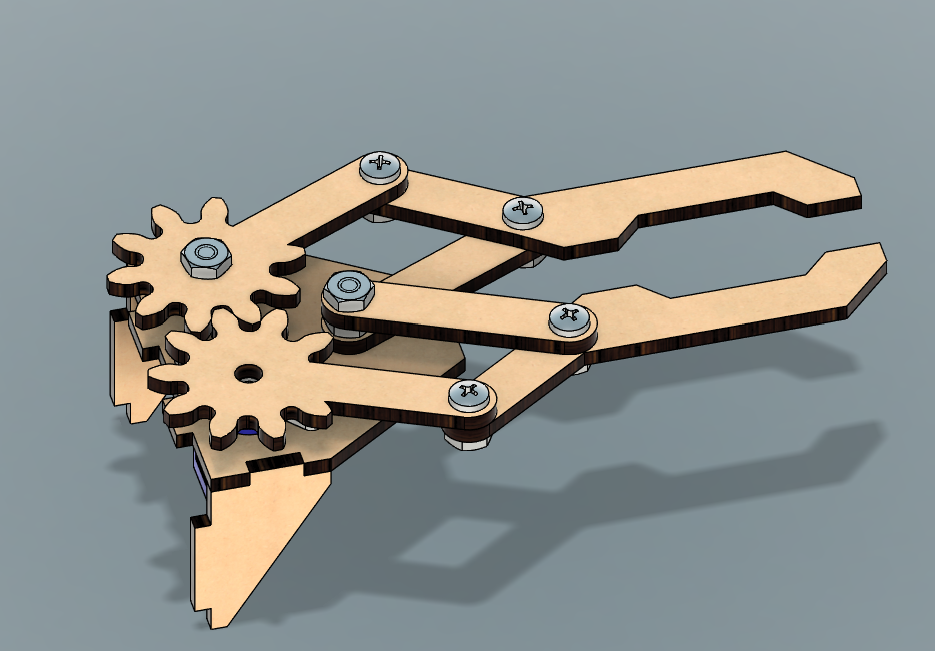
latex/evidencias 2/anexos/Gripper/Screenshot 2025-10-25 161838.png
