HectorPereira/proyectoIntegrador2/fab/cortes mdf/galga mdf/Galga MDF.dxf

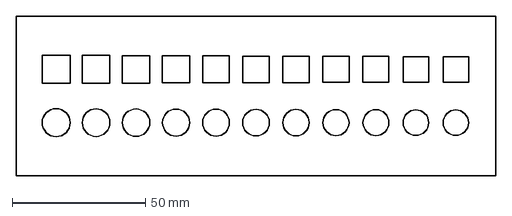
[picture p98: CAD file, 2025-09-06]
fab/cortes mdf/galga mdf/Galga MDF.dxf
180.0 x 60.0 mm
