HectorPereira/proyectoIntegrador2/fab/impresiones/galga/99.stl

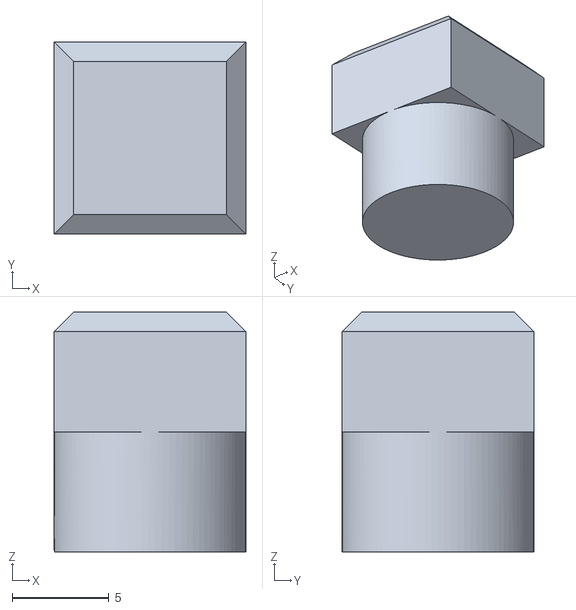
[picture p99: CAD file, 2025-09-06]
fab/impresiones/galga/99.stl
9.90 x 9.90 x 12.4
