HectorPereira/proyectoIntegrador2/fab/impresiones/galga/100.stl

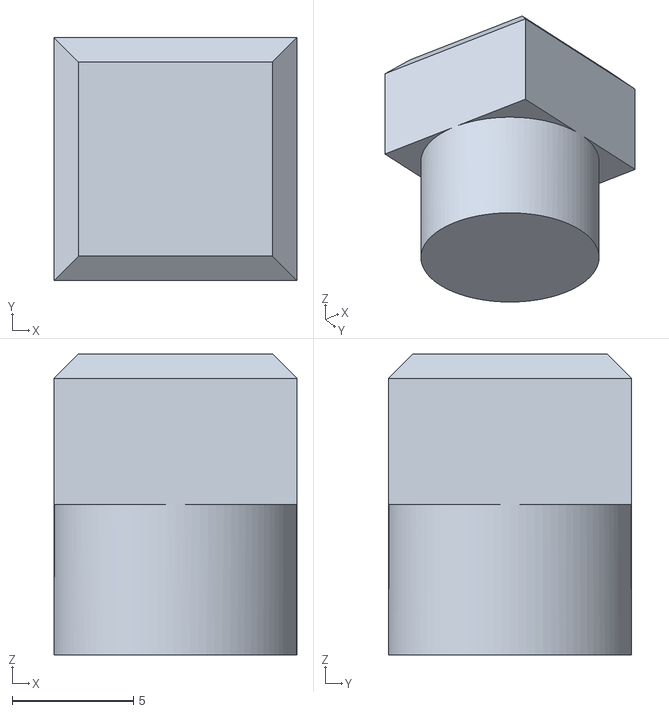
[picture p100: CAD file, 2025-09-06]
fab/impresiones/galga/100.stl
10.0 x 10.0 x 12.4
