HectorPereira/proyectoIntegrador2/fab/impresiones/galga/galga.stl

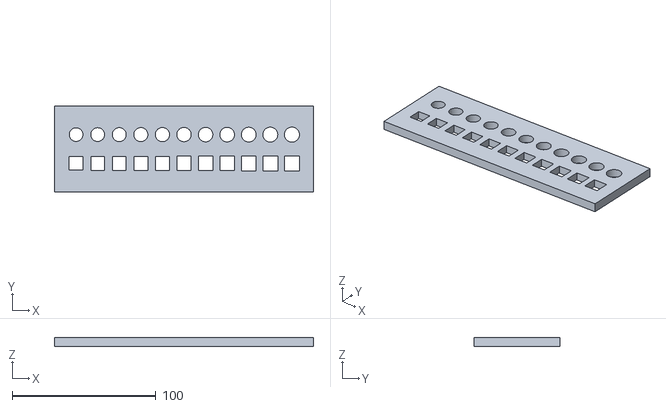
[picture p101: CAD file, 2025-09-06]
fab/impresiones/galga/galga.stl
180.0 x 60.0 x 6.20
