HectorPereira/proyectoIntegrador2/fab/impresiones/galga/104.stl

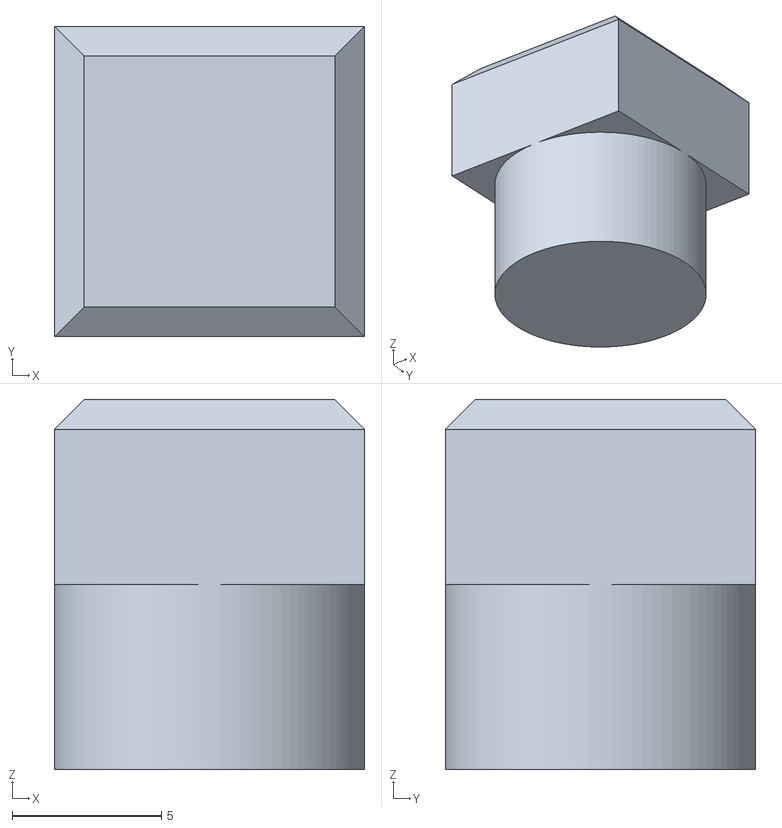
[picture p102: CAD file, 2025-09-06]
fab/impresiones/galga/104.stl
10.4 x 10.4 x 12.4
