HectorPereira/proyectoIntegrador2/fab/impresiones/galga/97.stl

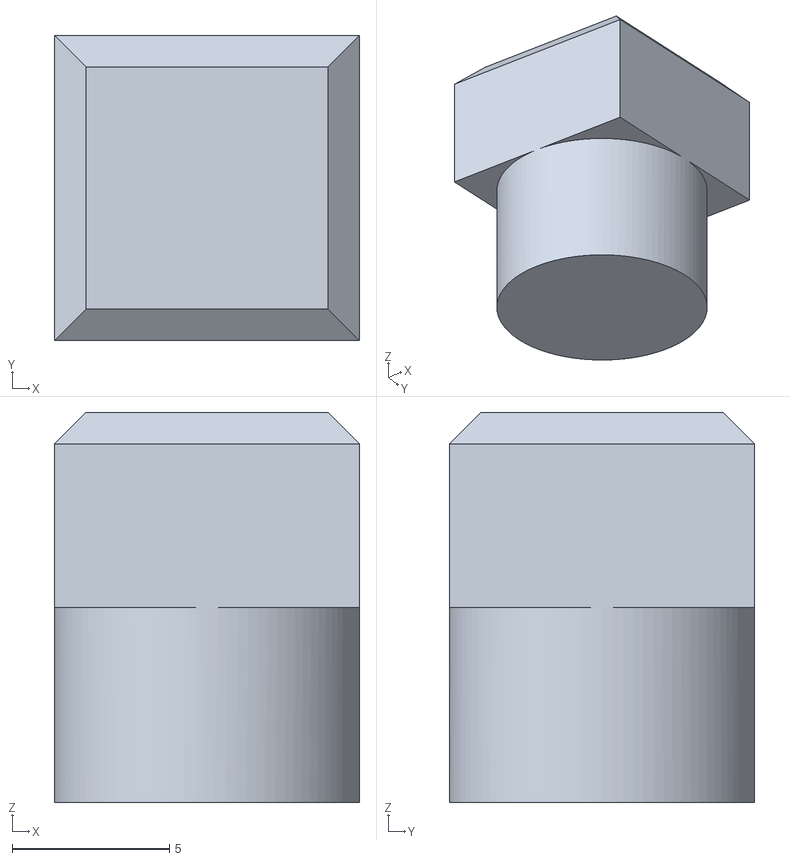
[picture p103: CAD file, 2025-09-06]
fab/impresiones/galga/97.stl
9.70 x 9.70 x 12.4
