HectorPereira/proyectoIntegrador2/fab/impresiones/galga/95.stl

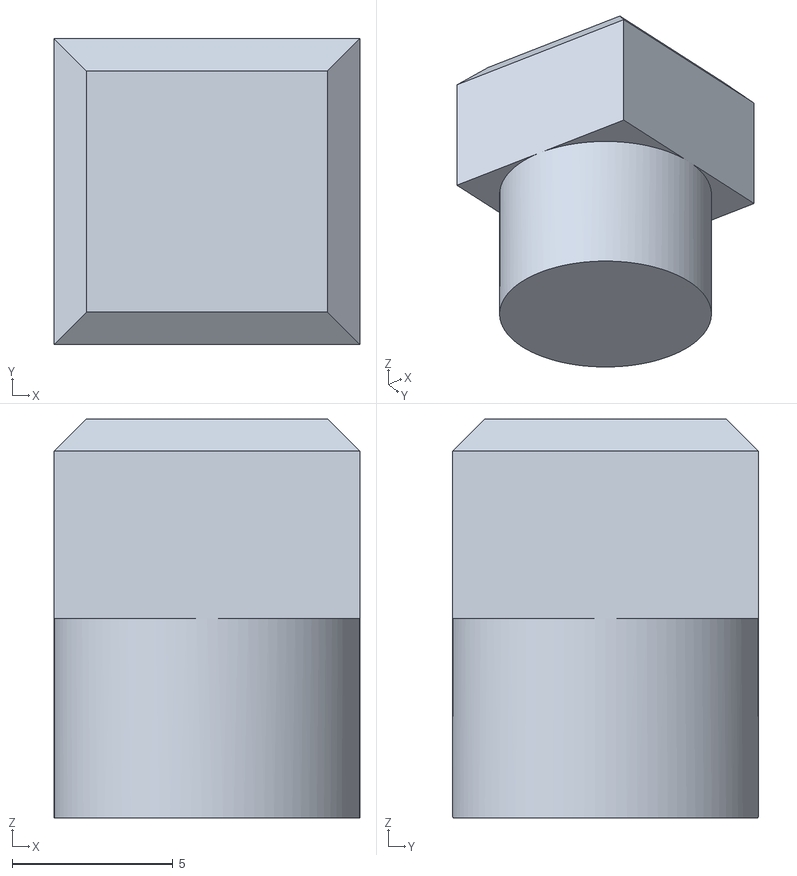
[picture p104: CAD file, 2025-09-06]
fab/impresiones/galga/95.stl
9.50 x 9.50 x 12.4
