HectorPereira/proyectoIntegrador2/fab/impresiones/galga/103.stl

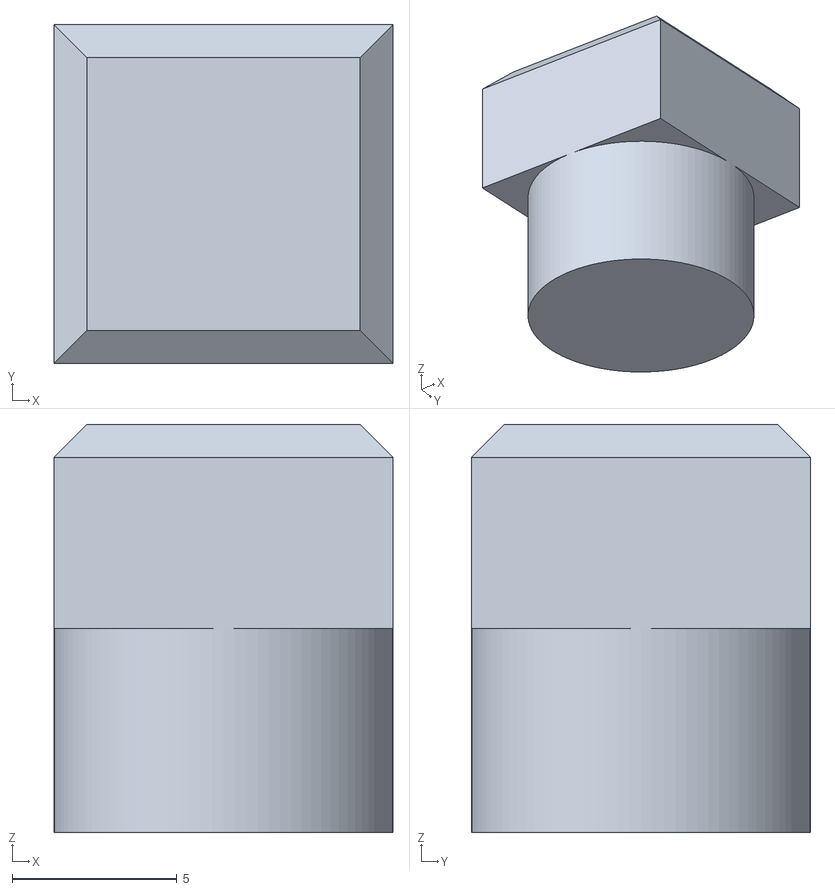
[picture p105: CAD file, 2025-09-06]
fab/impresiones/galga/103.stl
10.3 x 10.3 x 12.4
