HectorPereira/proyectoIntegrador2/fab/impresiones/galga/105.stl

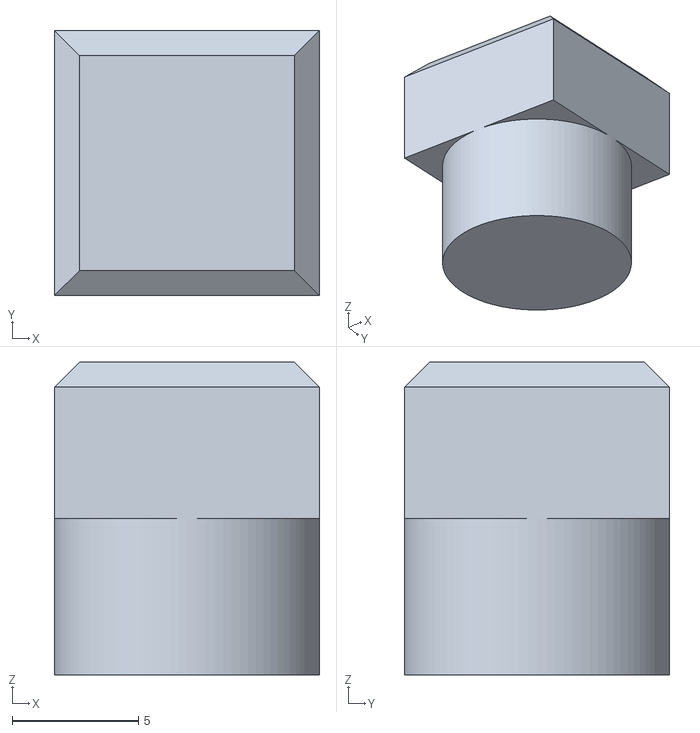
[picture p106: CAD file, 2025-09-06]
fab/impresiones/galga/105.stl
10.5 x 10.5 x 12.4
