HectorPereira/proyectoIntegrador2/fab/impresiones/galga/101.stl

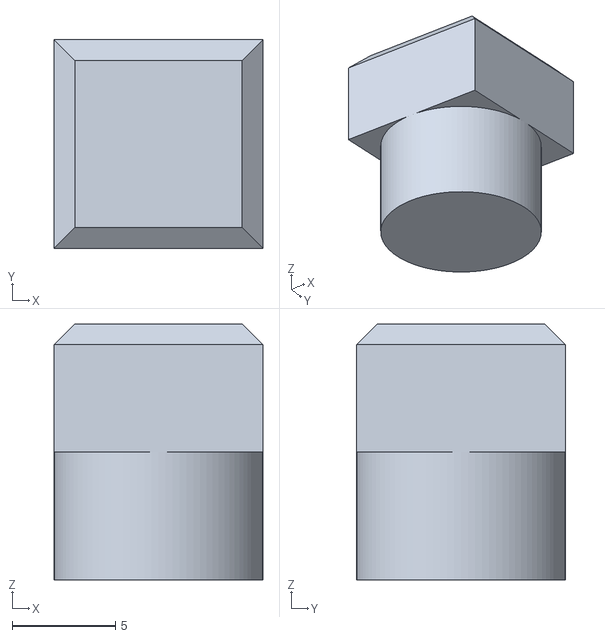
[picture p107: CAD file, 2025-09-06]
fab/impresiones/galga/101.stl
10.1 x 10.1 x 12.4
