HectorPereira/proyectoIntegrador2/fab/impresiones/galga/98.stl

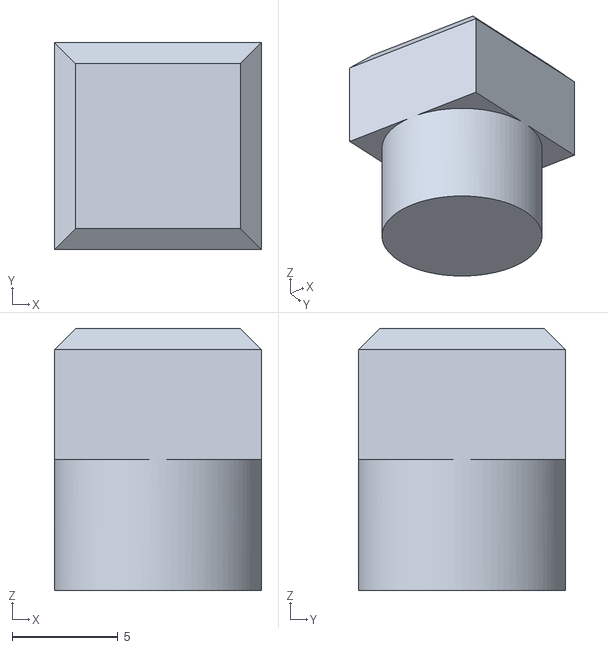
[picture p108: CAD file, 2025-09-06]
fab/impresiones/galga/98.stl
9.80 x 9.80 x 12.4
