HectorPereira/proyectoIntegrador2/fab/impresiones/galga/96.stl

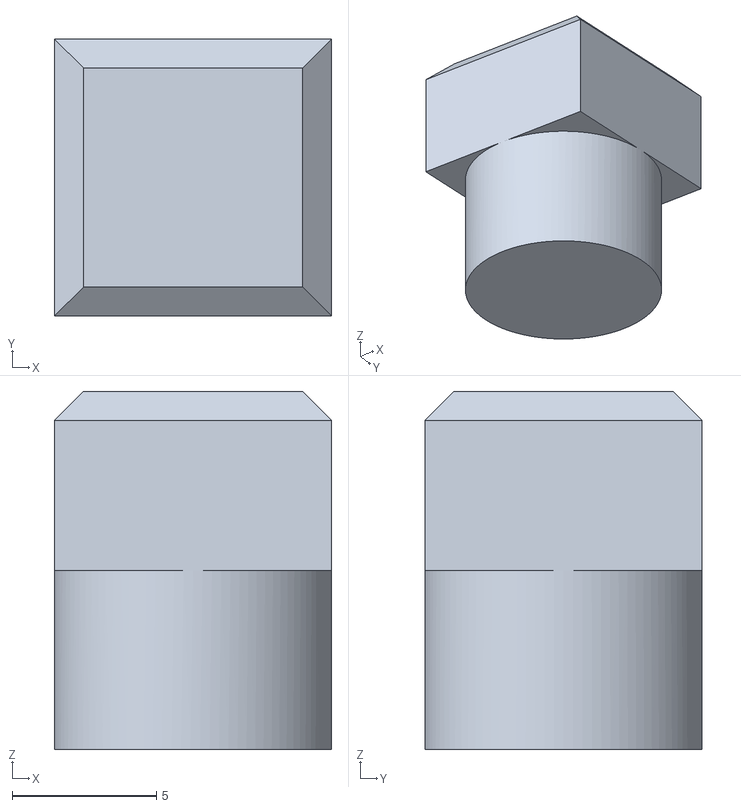
[picture p109: CAD file, 2025-09-06]
fab/impresiones/galga/96.stl
9.60 x 9.60 x 12.4
