HectorPereira/proyectoIntegrador2/(list of files, cad)

Other CAD files:
fab/impresiones/galga/102.stl
