HectorPereira/proyectoIntegrador2/latex/evidencias 2/anexos/Brazo V3/Pruebas ensamblaje/Screenshot 2025-10-25 165349.png

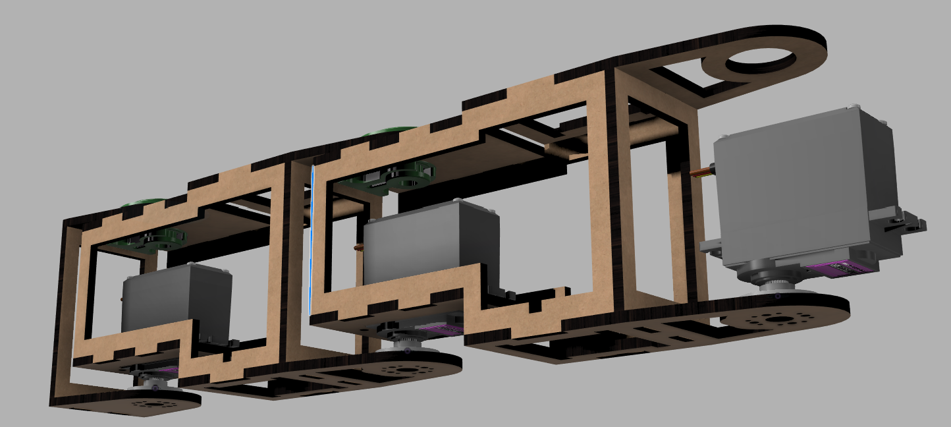
latex/evidencias 2/anexos/Brazo V3/Pruebas ensamblaje/Screenshot 2025-10-25 165349.png
