HectorPereira/proyectoIntegrador2/latex/3_resultados.tex

\section{Análisis de resultados}

\subsection{Diseño y fabricación}
\subsubsection{Articulaciones desmontables}

Con base en los lineamientos de tolerancias del apartado~\ref{Tolerancias}, se diseñó y fabricó una articulación desmontable para el brazo robótico. El objetivo fue verificar encastres, juego angular y comportamiento frente a rozamiento en las superficies de contacto.

\vspace{1em}

Inicialmente se construyó con descartes de MDF cortados a láser y herrajes M3. La pieza se sometió a esfuerzos de fricción, corte y rotación para observar desgaste, holguras y deformaciones. El prototipo permitió validar el principio mecánico, pero evidenció pérdida de tolerancia en contactos MDF-MDF bajo uso repetido. 

\begin{figure}[H]
  \centering
  
  \caption{Sistema de articulación desmontable. Fuente: elaboración própia}\label{fig:articulacionV2}
\end{figure}

Posteriormente se reemplazaron las superficies de contacto por insertos impresos en PLA, configurando una interfaz PLA–PLA en las zonas con rozamiento. Se ajustaron tolerancias según las galgas obtenidas, reduciendo el juego en el conjunto ensamblado y mejorando la repetibilidad. Se documentaron espesores, holguras objetivo y par de apriete de tornillería para su reproducción. Véase figura \ref{fig:corte_pernoV3}

\begin{figure}[H]
  \centering
  
  \caption{Corte transversal perno --- versión mejorada. Fuente: elaboración própia}\label{fig:corte_pernoV3}
\end{figure}

Se identifican con verde las superficie de contacto que friccionan contra el perno azúl, las cualés tienen un ajuste deslizante con el perno. En amarillo se muestra la pieza que actúa como tope para el seguro del perno. En el modelo anterior se utilizaba una sola pieza que hacía esta función, pero al utilizar este tope (con un ajuste apretado) permite regular la fuerza de ajuste y juego de la articulación. El seguro que se encuentra entre el tope y el perno, este permite montar y desmontar la articulación de manera sencilla.

\begin{figure}[H]
  \centering
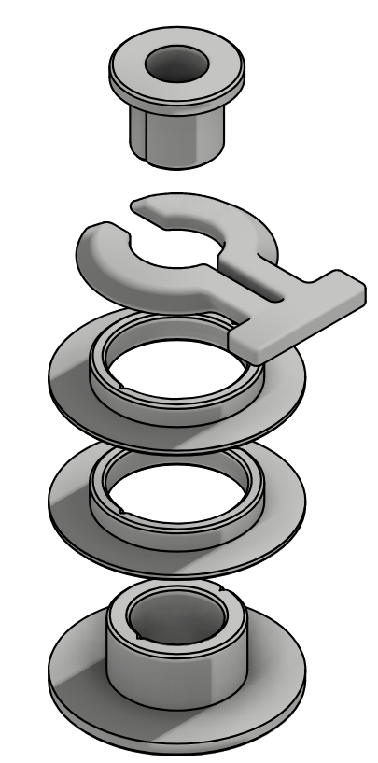
[picture p111: latex/Anexos/CAD/despieceArticulacion.png]
  
  \caption{Despiece de articulación desmontable. Fuente: elaboración própia}\label{fig:despiece_articulacion}
\end{figure}

\newpage

\subsubsection{Brazo robótico articulado}

\paragraph*{\textbf{Muñeca}} --- \\

La muñeca está compuesta por una estructura principal de 5 piezas de MDF (véase la figura~\ref{fig:brazoMuneca}). Alberga al servomotor de la misma, junto con el electroimán, y la articulación que la une al eslabón anterior.

\begin{figure}[H]
  \centering
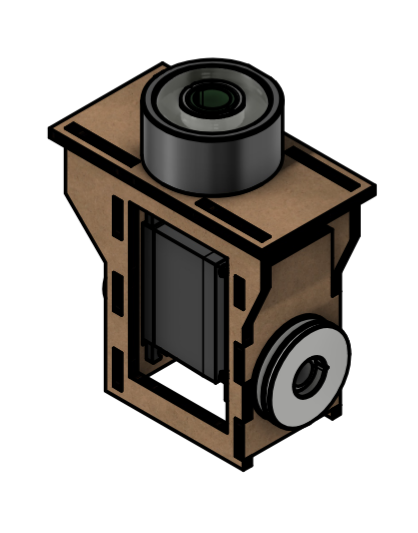
[picture p112: latex/Anexos/CAD/brazoMuneca.png]
  
  \caption{Muñeca de brazo robótico. Fuente: elaboración própia}\label{fig:brazoMuneca}
\end{figure}

\paragraph*{\textbf{Eslabones}} --- \\

Los 2 eslabones se componen de 6 piezas de MDF pegadas entre sí para dar soporte estructural al servomotor y articulación desmotable respectivamente. Poseen encastres para el siguiente efector y articulación, además, como se ve en la figura~\ref{fig:brazoEslabon}, el eslabón inferior o principal, posee soportes exteriores para tornillos, los cuales trabajan en conjunto con el hombro para albergar gomas elásticas o un resorte, el cual se encargará de brindar asistencia mecánica en posiciones extendidas para la articulación inferior, la cual es la encargada de soportar la mayor carga. 

\begin{figure}[H]
  \centering
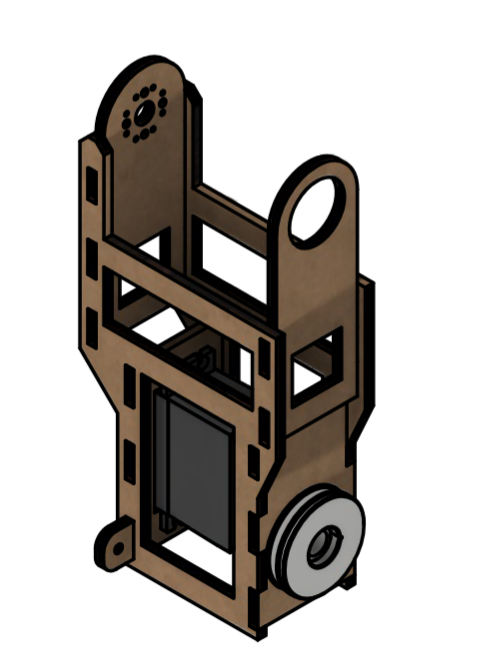
[picture p113: latex/Anexos/CAD/brazoEslabon.png]
  
  \caption{Eslabón de brazo robótico. Fuente: elaboración própia}\label{fig:brazoEslabon}
\end{figure}

\paragraph*{\textbf{Hombro}} --- \\

Este componente, como se puede observar en la figura~\ref{fig:brazoHombro}, es una pieza completmanete estructural. Sus funciones son brindar estabilidad estructural a los eslabones y a la muñeca, junto con el electroimán, permitir la rotación del brazo al acoplarse al eje del servomotor de la base, y aliviar cargas axiales en el mismo al apoyarse en el anillo de soporte. Además el hombro se encarga de contener a la suspensión de la articulación inferior, encargada de dar asistencia en posiciones de extensión máxima o cercanas, y distribuir el esfuerzo del servomotor más uniformemente en el rango de movimiento.

\begin{figure}[H]
  \centering
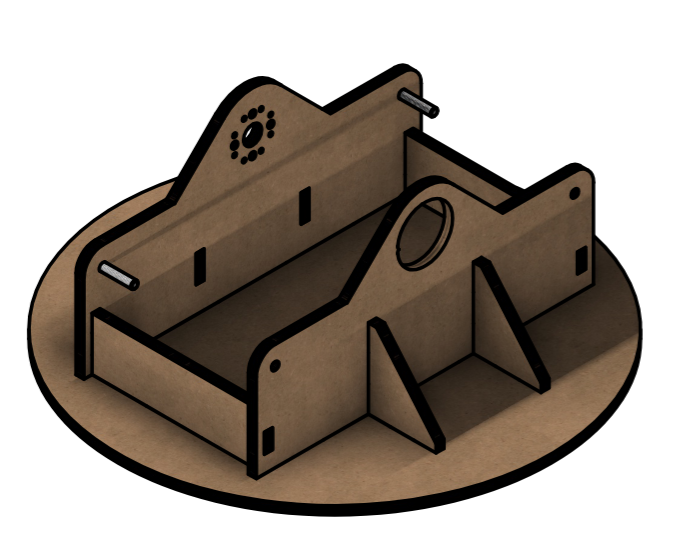
[picture p114: latex/Anexos/CAD/brazoHombro.png]
  
  \caption{Hombro de brazo robótico. Fuente: elaboración própia}\label{fig:brazoHombro}
\end{figure}

\paragraph*{\textbf{Base}} --- \\

La base del brazo se encarga de mantener estático al sistema durante operación (véase figura~\ref{fig:brazoBase}), a la vez de albergar el servomotor que se encarga de la rotación del brazo sobre su própio eje. Este se encuentra en la parte inferior de la base, y se encuentra asistido por un anillo que hace leve contacto entre la base y el hombro, lo que permite alivitar cargas axiales y momentos no deseados. 

\vspace{1em}

La base posee patas que se extienden lejos del centro de masa del sistema para brindar aproyo sobre cualquier extensión del brazo, sin que este llege a tambalearse. Además, la base cuenta con una mesa donde se alojan los componentes electrónicos, además del tablero. 

\begin{figure}[H]lidad 
  \centering
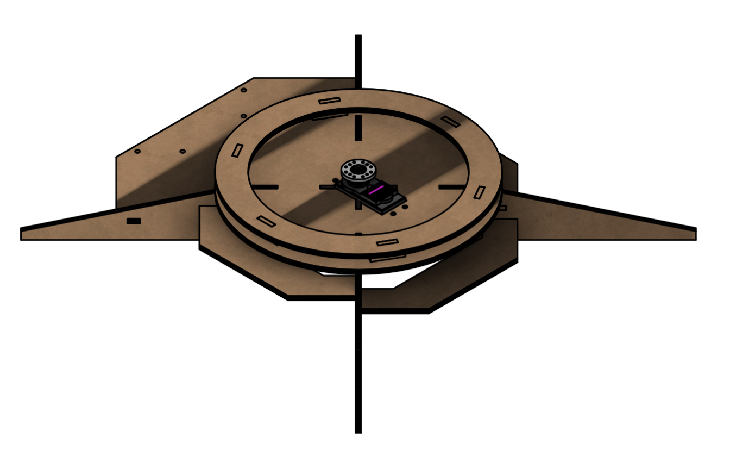
[picture p115: latex/Anexos/CAD/brazoBase.png]
  
  \caption{Base de brazo robótico. Fuente: elaboración própia}\label{fig:brazoBase}
\end{figure}

\paragraph*{\textbf{Tablero}} --- \\

Se incorpora un tablero desmontable el cual incorpora los componentes electrónicos para la comunicación del usuario, además de alojar conectores tanto para el controlador espejo como para la fuente de alimentación del sistema. 

\begin{figure}[H]
  \centering
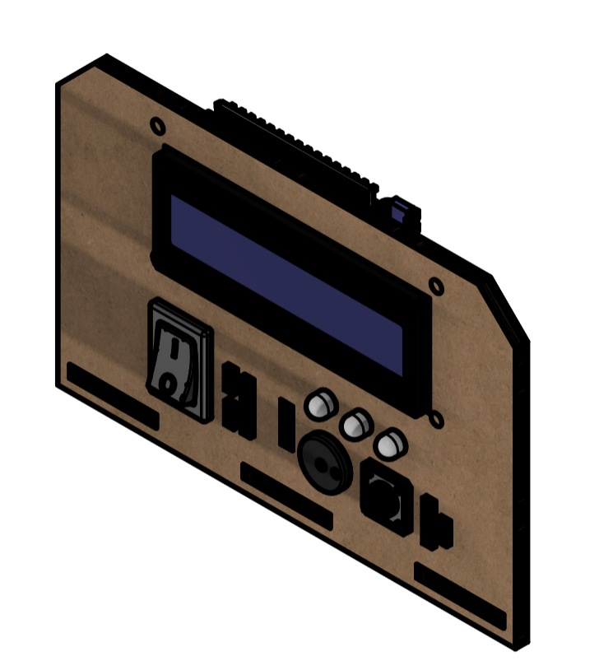
[picture p116: latex/Anexos/CAD/brasoTablero.png]
  
  \caption{Tablero de control de brazo robótico. Fuente: elaboración própia}
\end{figure}

\subsubsection{Electroimán}
Para realizar la carcasa del electroimán se realiza uso de un torno manual. Hasta tener las medidas concretadas, se dejan un excedente en espesor y longitud para realizar pruebas durante el proceso de prototipado. Cuando se obtengan el resto de valores se dará lugar a una finalización de esta pieza por motivos de reducción de peso.

\vspace{1em}

La bobina del electroimán se construyó utilizando alambre de cobre esmaltado de 0,5 mm de diámetro, enrollado a lo largo de aproximadamente 5 metros para generar el campo magnético necesario. Como núcleo ferromagnético se empleó un tornillo de acero, seleccionado por su alta permeabilidad magnética y disponibilidad. 

\begin{figure}[H]
  \centering
  
  \caption{Pieza fabricada. Fuente: elaboración própia}
\end{figure}

El electroimán cuenta con 5 partes principales, 4 de ellas se ven representadas en la figura~\ref{fig:despiece_iman}. El componente principal del electroimán es la la bobina de alambre de cobre esmaltado, esta es contenida por el carretel. Este se compone por doss piezas impresas en 3D que encastran entre sí. Esto se hizo así para evitar soportes durante el proceso de impresión. El carretel con la bobina es colocado dentro de la carcasa, el cual es asegurado por un anillo creado a partir de un segmento de barra de silicona, el cual evita que el carretel con la bobina salgan de la carcasa. Por último, se coloca un tornillo M10 o M9 en el centro que sirve tanto de núcleo para el electroimán, tanto como método de sujeción a la muñeca. 

\begin{figure}[H]
  \centering
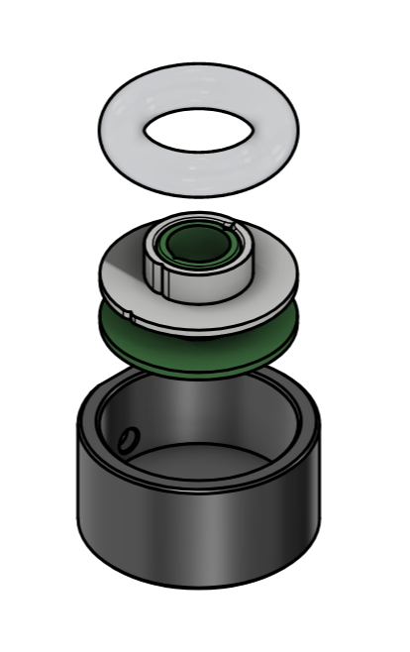
[picture p117: latex/Anexos/CAD/despieceIman.png]
  
  \caption{Despiece de electroimán. Fuente: elaboración própia}\label{fig:despiece_iman}
\end{figure}

\subsection{Fuente de alimentación}

En lo referente a la electrónica de potencia, se utilizó una fuente ATX de una computadora en desuso para alimentar los motores del sistema. Esta fuente fue seleccionada debido a su capacidad para suministrar líneas estables de 12 V y 5 V, necesarias para los distintos actuadores.

\vspace{1em}

Además, se diseñó y cortó en MDF una carcasa para alojar y proteger la fuente, permitiendo un montaje seguro y una mejor organización del cableado dentro del proyecto, la misma se enciende por un interruptor ubicado en la parte delantera de la carcasa.

\begin{figure}[H]
  \centering
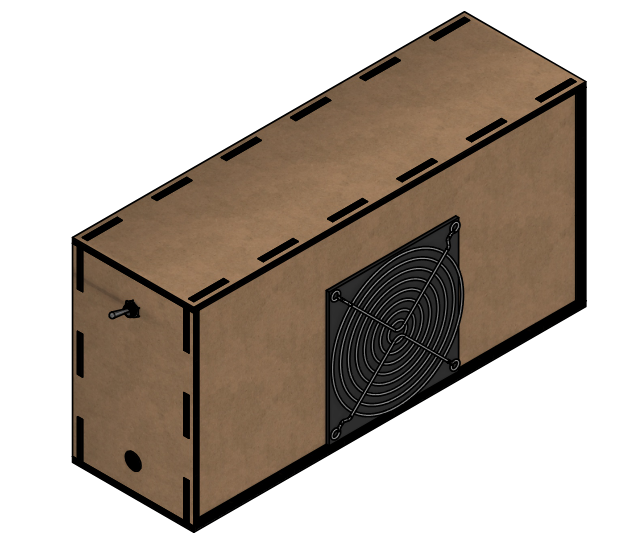
[picture p118: latex/Anexos/CAD/fuenteAlim.png]
  
  \caption{Modelo CAD de fuente de alimentación. Fuente: elaboración própia}
\end{figure}

\subsubsection{Controlador espejo}

Se realiza el diseño del controlador espejo tomando en consideración las tolerancias especuladas. Se elaboran bosquejos y se diseñan partes individuales para verificar calces y encastres, tomando como inspiración el anexo \ref{fig:insp.impreso}.

\vspace{1em}

Este controlador incorpora potenciometros para realizar la lectura de los ángulos de cada articulación, replicando la distribución de actuadores en el brazo real. A través de estos se puede realizar el control fluido del mismo, sin la necesidad de una programación extensiva de movimientos que pueden llegar a ser complicados de trazar sin cálculos complejos.

\vspace{1em}

Utilizando una filosofía de materiales híbrida, y luego de varias iteraciones, se llega al siguiente diseño: Un enfoque modular, con una estructura en MDF y con carcazas para protección y estética en PLA. La parte estructural está puramente dedicada con MDF por su velocidad de fabricación/prototipado, mientras que se utilzó PLA para carcazas por ser electricamente aislante, y su versatilidad al poder implementar impresión 3D como método de fabricación. La carcasa de la muñeca se encarga de albergar los botones para el electroimán y grabación.  

\begin{figure}[H]
  \centering
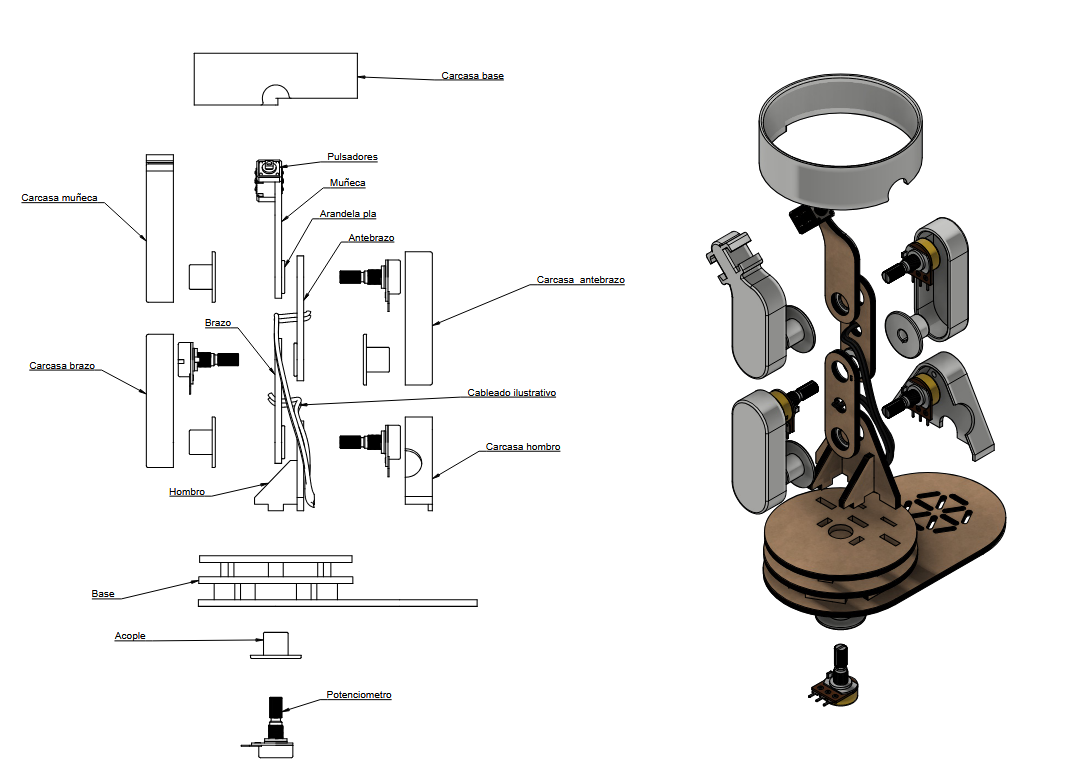
[picture p119: latex/Anexos/CAD/despieceEspejo.png]
  
  \caption{Despiece del controlador espejo. Fuente: elaboración própia}
\end{figure}

Los potenciometros se encuentran conectados en paralelo a 5V y tierra, mientras que el wiper se lo toma como referencia analógica para la lectura de los ángulos, además de conectar los pulsadores a tierra para la lectura de entradas de comando de electroimán y grabación utilizando las resistencias pull up internas del microcontrolador. Se crean conectores hembra para facilitar la manipulación de las conexiones eléctricas, tanto para la alimentación del controlador, como para salidas analógicas de los potenciomestros y las salidas digitales de los pulsadores.

\begin{figure}[H]
  \centering
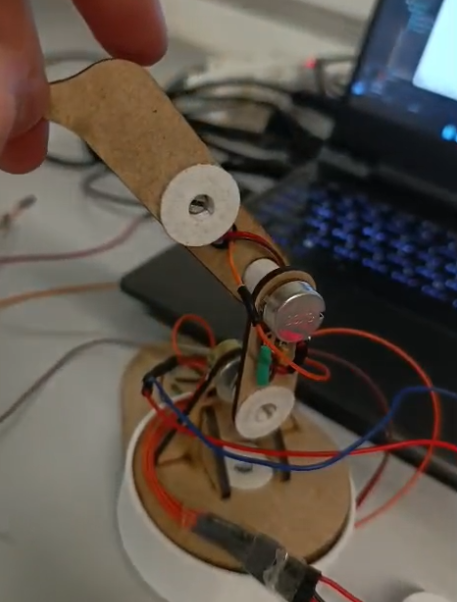
[picture p120: latex/Anexos/fisico/mini.png]
  
  \caption{Controlador espejo Fuente: elaboración própia}
\end{figure}

\subsection{Electrónica de control}

La electrónica de control se encarga de controlar adecuadamente todos los transductores implementados. Como se puede observar en la figura~\ref{fig:tinkerCAD}, el conexionado entre compoenentes se da más o menos de manera directa, donde un pin del arduino se corresponde con el elemento que se desea controlar, exceptuando el caso del electroimán. Al tratarse de un elemento inductor conmutado que maneja potencias superiores el sistema de control, se requiere alimentar con 12V. Para conmutarlo, el sistema de control emplea un módulo relé, capaz de ser accionado con el mismo microcontrolador.

\begin{figure}[H]
  \centering
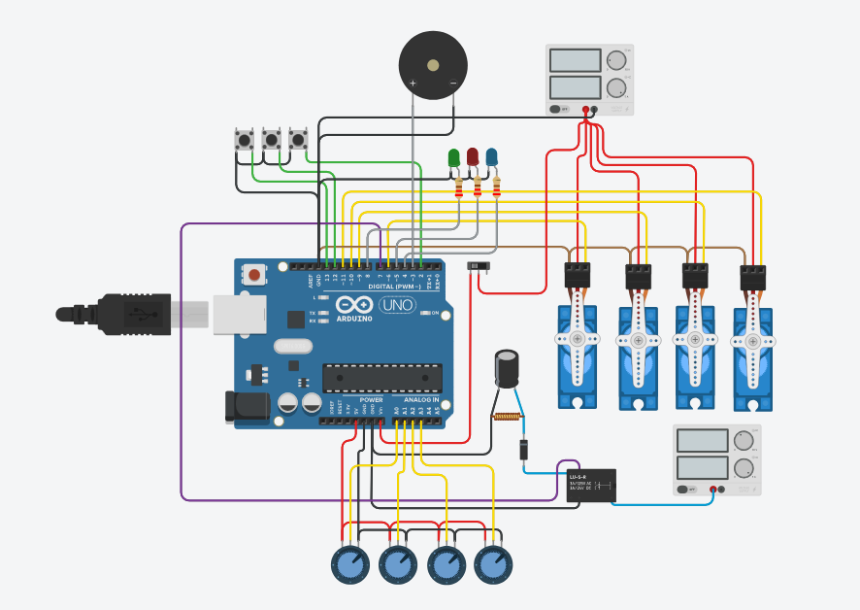
[picture p121: latex/Anexos/circuito/tinkerCAD.png]
  
  \caption{Diagrama de conexiones eléctricas. Fuente: elaboración própia}\label{fig:tinkerCAD}
\end{figure}

\subsection{Electrónica de potencia}

La electrónica de potencia del sistema tiene como finalidad suministrar las tensiones y corrientes necesarias para los actuadores. Los servomotores se alimentan desde una línea regulada de 5\,V proveniente de una fuente ATX, capaz de entregar corrientes elevadas sin caídas significativas. Para mejorar la estabilidad durante movimientos simultáneos, la distribución se realiza mediante ramales separados.

\vspace{1em}

El electroimán, por su parte, requiere una fuente independiente de 12\,V debido a su mayor demanda de potencia. Al ser una carga inductiva, se incorpora un diodo de rueda libre en paralelo con la bobina para disipar la energía almacenada durante la desconexión y evitar picos de tensión que podrían dañar el módulo relé o el microcontrolador. Ambas fuentes comparten un punto común de masa para asegurar una referencia eléctrica estable entre las etapas de control y potencia (véase figura~\ref{fig:tinkerCAD}).

\subsection{Código microcontrolador}

El firmware implementado en el microcontrolador ATmega328P coordina de maneradeterminística el control de los servomotores, la lectura de potenciómetros, lacomunicación UART, la gestión del electroimán y el sistema de señalización(acústica y lumínica). Su estructura se basa en un bucle principal de ejecucióncontinua (véase Anexo~\ref{ap:loop}), donde en cada iteración se realizan lastareas de lectura, procesamiento y actualización necesarias para mantener elestado del brazo robótico.

\begin{figure}[H]
  \centering
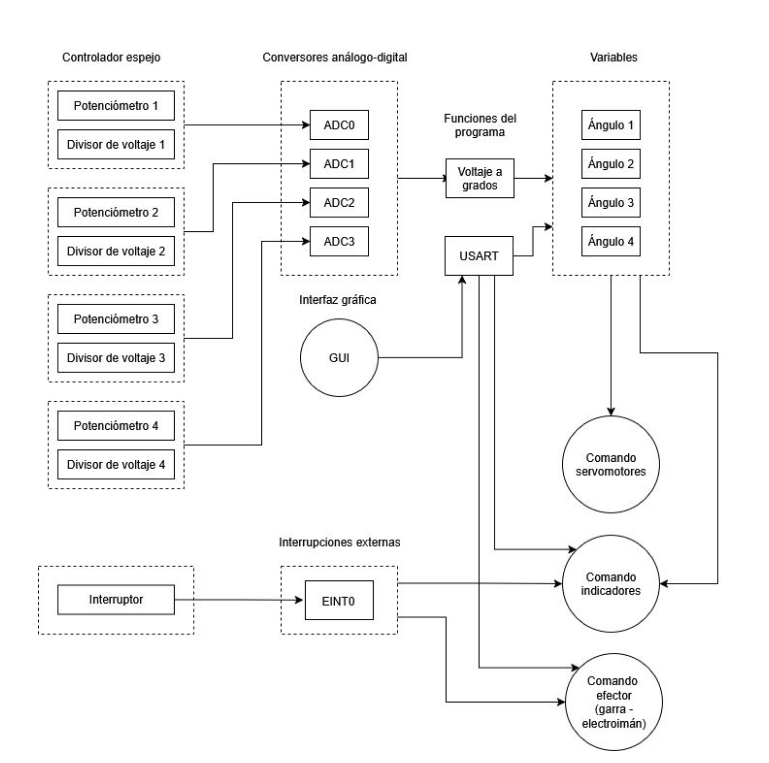
[picture p122: latex/Anexos/Codigo/Flujo.png]
  
  \caption{Diagrama de flujo del código en C. Fuente: elaboración própia}
\end{figure}

En primer lugar, el sistema gestiona la comunicación serie mediante un módulo UART configurado a 9600\,bps (Anexo~\ref{ap:uart_init}). La telemetría seenvía periódicamente a la computadora, incluyendo los ángulos articulares enformato textual, mientras que el parser de comandos (Anexo~\ref{ap:uart_parser})interpreta instrucciones tales como el cambio de modo de operación, laactivación del electroimán, la orden de inicio de grabación o consignasdirectas para los servomotores. Este mecanismo de intercambio permite manteneruna arquitectura distribuida donde el microcontrolador ejecuta el control entiempo real y la aplicación de escritorio gestiona la capa de interacción.

\vspace{1em}

El movimiento de cada articulación se calcula siguiendo un modelo de doblerepresentación: un ángulo lógico (proveniente de potenciómetros o de la APP) yun ángulo efectivo suavizado mediante un algoritmo de ``slew rate'' que limitala velocidad de cambio (Anexo~\ref{ap:slew}). Este método evita transicionesbruscas y reduce esfuerzos mecánicos. Una vez determinado el ángulo final, segenera la señal PWM correspondiente mediante un mecanismo de bit-banging basadoen el Timer1 (Anexo~\ref{ap:pwm_bitbanging}), lo cual permite controlarsimultáneamente los cuatro servomotores sin depender de librerías externas.

\vspace{1em}

Además, el firmware incorpora un control del electroimán con feedback audible yvisual (Anexo~\ref{ap:mag_control}). El estado del imán puede cambiarse tantodesde la aplicación como desde un botón físico, y la transición OFF→ON disparaautomáticamente un patrón de dos pitidos generado mediante una máquina deestados dedicada al buzzer (Anexo~\ref{ap:buzzer_fsm}). De manera similar, lagrabación de trayectorias puede activarse mediante un botón con antirrebote, loque a su vez ilumina el LED rojo y emite un patrón distintivo de tres beeps.

\vspace{1em}

Finalmente, el sistema incorpora una gestión por software de los botonesfísicos, donde se aplica filtrado de rebote (Anexo~\ref{ap:debounce}) paragarantizar detecciones fiables sin necesidad de hardware adicional. En conjunto,todas estas funcionalidades convergen en el bucle principal del firmware(Anexo~\ref{ap:loop}), el cual mantiene un comportamiento estable, coherente conla HMI y seguro para la operación del brazo robótico.

\subsection{Interfaz gráfica}

\subsubsection{Selección y justificación de la interfaz gráfica de control}

Se adoptó una aplicación de escritorio como interfaz humano-máquina (HMI) con el objetivo de facilitar el proceso de prototipado y permitir la incorporación rápida de nuevas funcionalidades. Este enfoque proporciona una mayor flexibilidad frente a paneles físicos tradicionales, ya que evita modificaciones de hardware cada vez que se requiere ajustar el sistema. Además, la interfaz gráfica integra visualización en tiempo real, ajuste fino de parámetros operativos y funciones avanzadas como la automatización de secuencias. Su implementación completa puede consultarse en el Anexo~\ref{apendice:codigo_GUI}.

\subsubsection{Arquitectura distribuida del sistema}

El sistema se diseñó bajo una arquitectura distribuida en la que la aplicación ejecuta las tareas de control de alto nivel, mientras que el microcontrolador gestiona el control de tiempo real de los actuadores. La comunicación entre ambos módulos se implementó mediante un enlace serial UART utilizando un protocolo textual simplificado. Los módulos de conexión y recepción periódica se detallan en el Anexo~\ref{gui:uart_connect}. Esta separación garantiza un comportamiento determinístico en el movimiento de los servomotores sin sacrificar la flexibilidad y escalabilidad en la capa superior.

\subsubsection{Modos de operación implementados}

Se definieron dos modos principales de operación:
\begin{itemize}
    \item \textbf{Modo de control manual (modo espejo):} el robot replica directamente los movimientos ejecutados mediante el controlador físico.
    \item \textbf{Modo de control por aplicación:} las consignas se generan desde la interfaz gráfica, permitiendo una mayor precisión y la automatización de secuencias.
\end{itemize}

La selección del modo se gestiona mediante la lógica interna del firmware, asegurando transiciones progresivas sin interrupciones bruscas. El envío regulado de comandos desde la interfaz gráfica se describe en el Anexo~\ref{gui:rate_limiter}.

\begin{figure}[H]
  \centering
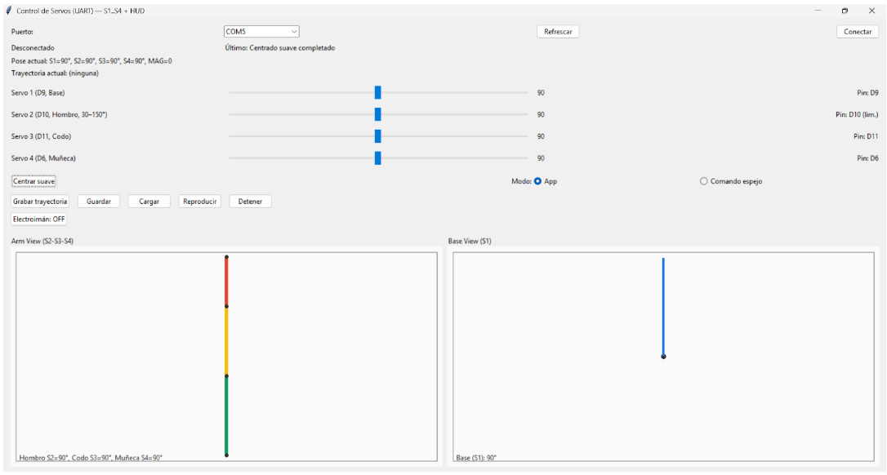
[picture p123: latex/Anexos/software/VentanaAppFinal.png]
  
  \caption{Captura de la interfaz gráfica implementada en Python. Fuente: elaboración própia}
\end{figure}

\subsubsection{Procedimiento de grabación y reproducción de trayectorias}

Se implementó un sistema de muestreo periódico de los ángulos articulares para registrar secuencias de movimiento. Las trayectorias se almacenan en estructuras ordenadas que conservan tanto los valores angulares como el intervalo de muestreo. El mecanismo de registro se presenta en el Anexo~\ref{gui:logger}, mientras que el algoritmo de reproducción —incluyendo el prealineado suave— se detalla en los Anexos~\ref{gui:smooth_playback} y~\ref{gui:playback_step}. Este método permite replicar movimientos de manera consistente respetando la cadencia temporal original.

\subsubsection{Estrategias de seguridad aplicadas}

Para garantizar la integridad del sistema y del operador, se incorporaron diversas estrategias de seguridad en la capa de software. Entre ellas se encuentran:
\begin{itemize}
    \item límites de operación por software para cada articulación;
    \item validación de comandos provenientes de la aplicación;
    \item transiciones progresivas entre modos de operación;
    \item rampas de movimiento al iniciar trayectorias automáticas.
\end{itemize}

Estas funciones complementan la lógica interna del microcontrolador, que también incorpora mecanismos de suavizado en el control de servomotores (véase Anexo~\ref{gui:center_all}).

\subsubsection{Integración entre la HMI y el microcontrolador}

La aplicación de escritorio envía comandos en un formato estructurado que el microcontrolador interpreta en tiempo real, mientras que éste devuelve información del estado del sistema para su visualización en la interfaz. El funcionamiento del parser de mensajes entrantes se detalla en los Anexos~\ref{gui:parser_uart} y~\ref{gui:parser_uart_alt}. Este enlace bidireccional garantiza coherencia entre la representación gráfica y la postura física del robot, asegurando una operación estable, confiable y sincronizada.

\subsection{Implementaciones físicas}

\begin{figure}[H]
  \centering
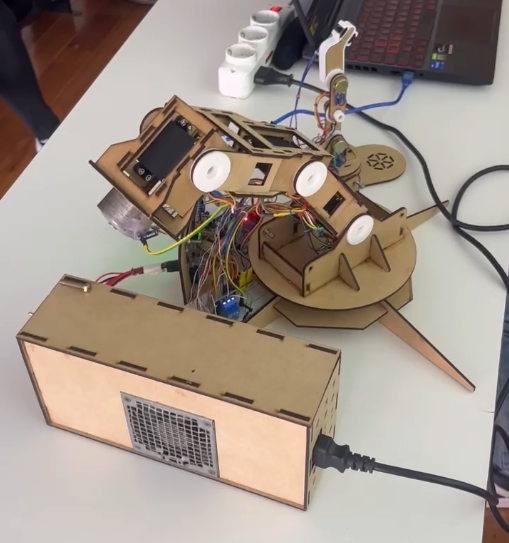
[picture p124: latex/Anexos/fisico/demo 2.png]
  
  \caption{Implementación en físico. Fuente: elaboración própia}
\end{figure}

\begin{figure}[H]
  \centering
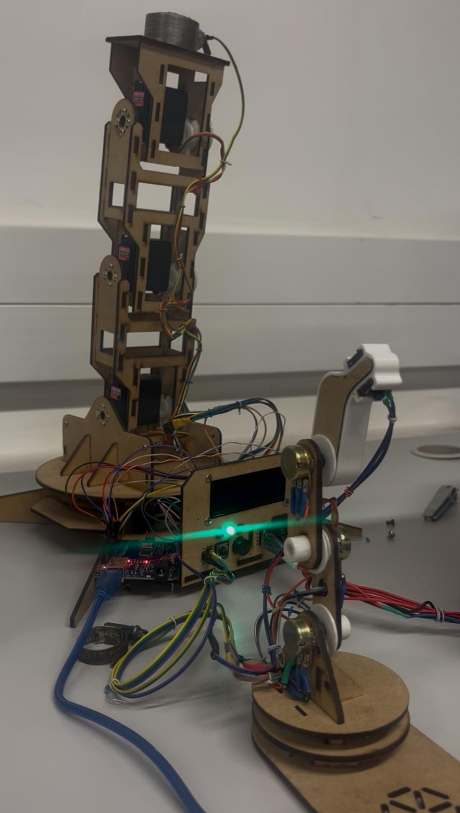
[picture p125: latex/Anexos/fisico/final.png]
  
  \caption{Funcionamiento de indicadores. Fuente: elaboración própia}
\end{figure}

\begin{figure}[H]
  \centering
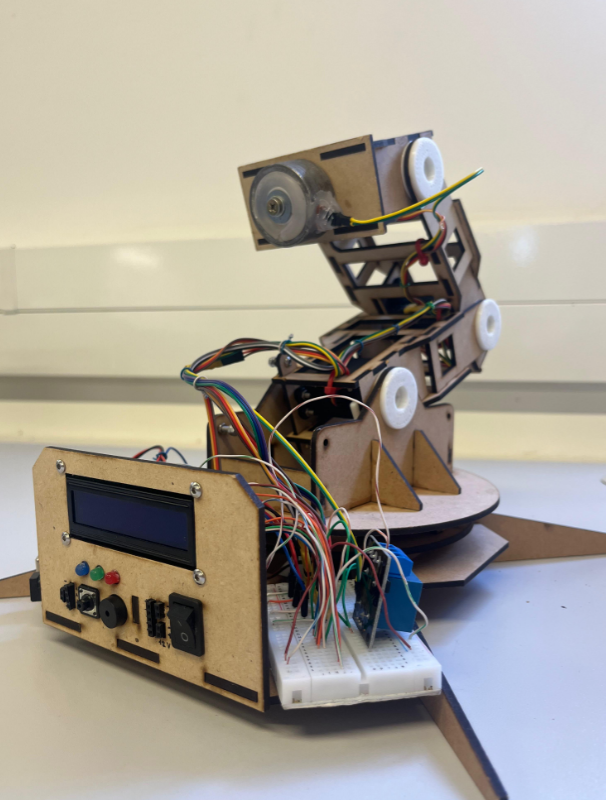
[picture p126: latex/Anexos/fisico/precioso.png]
  
  \caption{Brazo robótico, circuito y tablero. Fuente: elaboración própia}
\end{figure}

\subsection{Beneficios}

Sin tomar en cuenta la fuente de alimentación reciclada ni la mano de obra, para la elaboración de este proyecto, se obtuvieron los resultados vistos en el cuadro~\ref{tab:costos}:

\begin{table}[H]
\centering
\caption{Estimativo de costos por componente - precio. Fuente: elaboración propia}\label{tab:costos}
\begin{tabular}{p{0.63\textwidth} p{0.07\textwidth} p{0.20\textwidth}}
\toprule
\textbf{Componente} & \textbf{Cant.} & \textbf{Precio (UYU)} \\
\midrule

Arduino UNO & 1 & 450 \\

Servomotor MG996R & 4 & 2\,400 \\

Potenciómetros 10 $k\Omega$ & 4 & 280 \\

Condensadores 2200 µF & 2 & 120 \\

Protoboard / placa perforada & 1 & 400 \\

Electroimán casero (materiales) & 1 & 500 \\

MDF + tornillería + bridas + consumibles & — & 1\,100 \\

LEDs + resistencias + cableado menor & — & 100 \\

Cable multicore + funda termorretráctil + conectores & — & 600 \\

\midrule
\textbf{Total} & --- & \textbf{6\,030} \\
\bottomrule
\end{tabular}
\end{table}

% TODO: Modelo CAD con todo incorporado

% TODO: Modelo fisico del brazo
% TODO: Modelo fisico del controlador espejo
% TODO: Modelo fisico de la fuente de alimentacions

% TODO: Circuito real

% TODO: Funcionamiento del código del arduino
% TODO: Funcionamiento de la interfaz de usuario

% TODO: Desempeño del dispositivo en modo remoto
% TODO: Desempeño del dispositivo en modo manual
% TODO: Desempeño del dispositivo en modo grabado

% TODO: Comparacion de los objetivos
