HectorPereira/proyectoIntegrador2/latex/Anexos/Pruebas/Ajuste costura.jpg

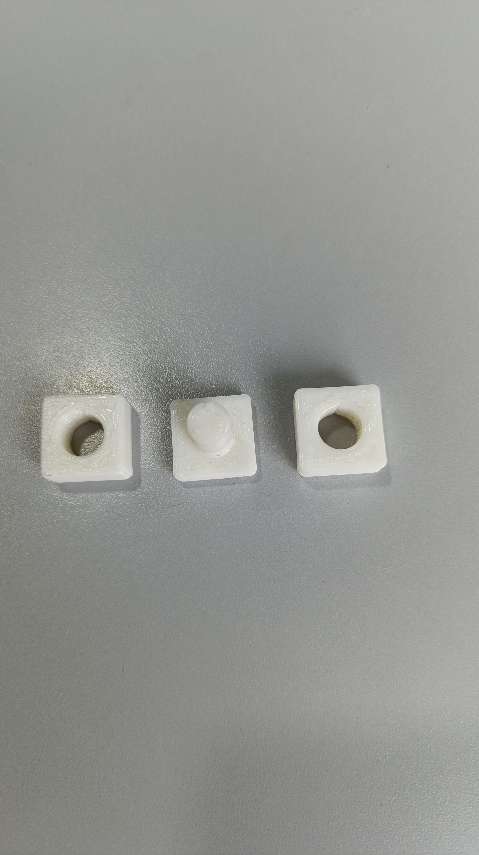
latex/Anexos/Pruebas/Ajuste costura.jpg
