HectorPereira/proyectoIntegrador2/latex/Anexos/Pruebas/Prueba articulacion armada.jpg

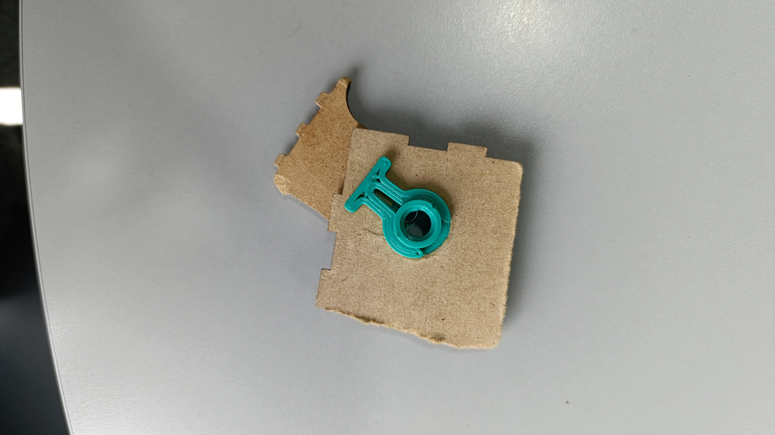
latex/Anexos/Pruebas/Prueba articulacion armada.jpg
