HectorPereira/proyectoIntegrador2/latex/Anexos/software/Pruebas de integración (2).png

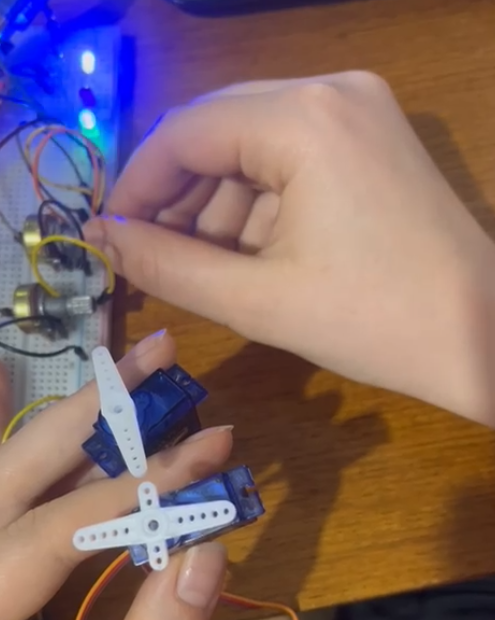
latex/Anexos/software/Pruebas de integración (2).png
