HectorPereira/proyectoIntegrador2/latex/Anexos/software/Pruebas de integración (3).png

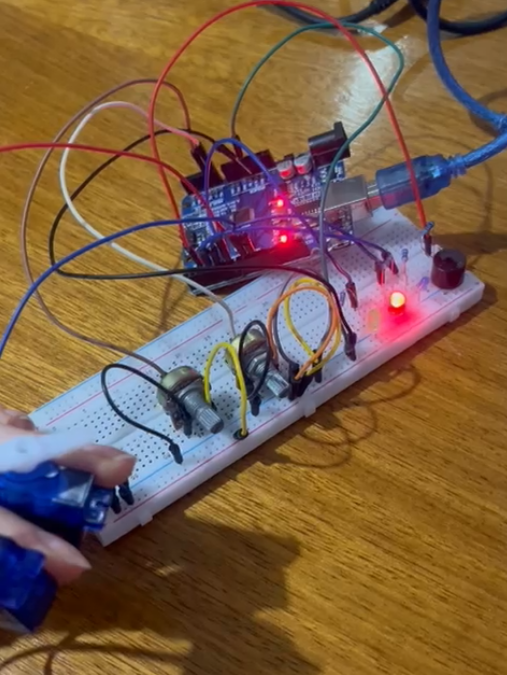
latex/Anexos/software/Pruebas de integración (3).png
