HectorPereira/proyectoIntegrador2/latex/Anexos/CAD/todo.png

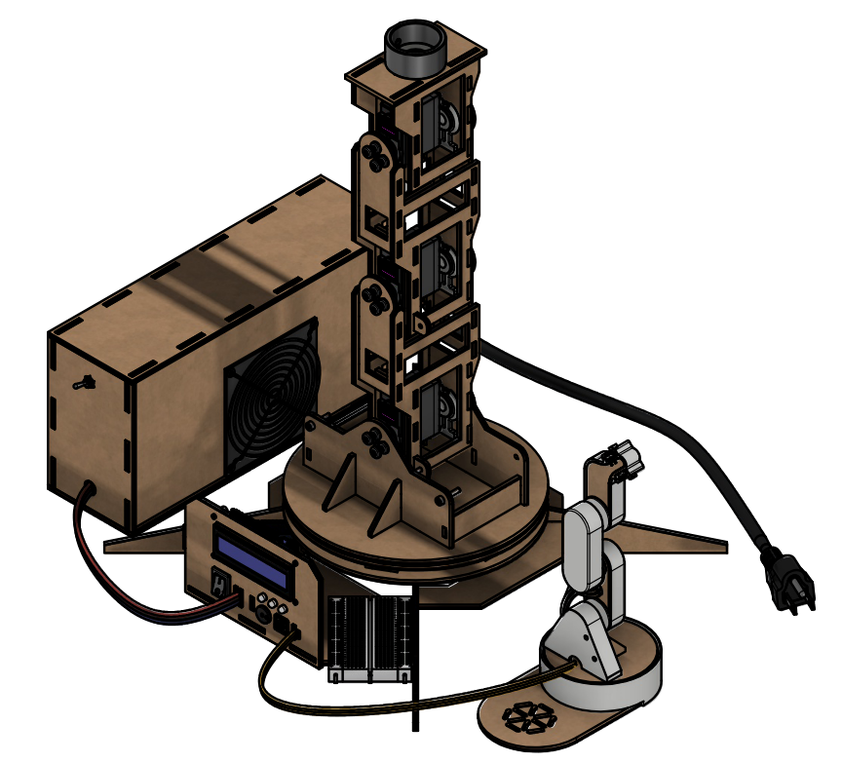
latex/Anexos/CAD/todo.png
