HectorPereira/proyectoIntegrador2/latex/Anexos/CAD/todoFrente.png

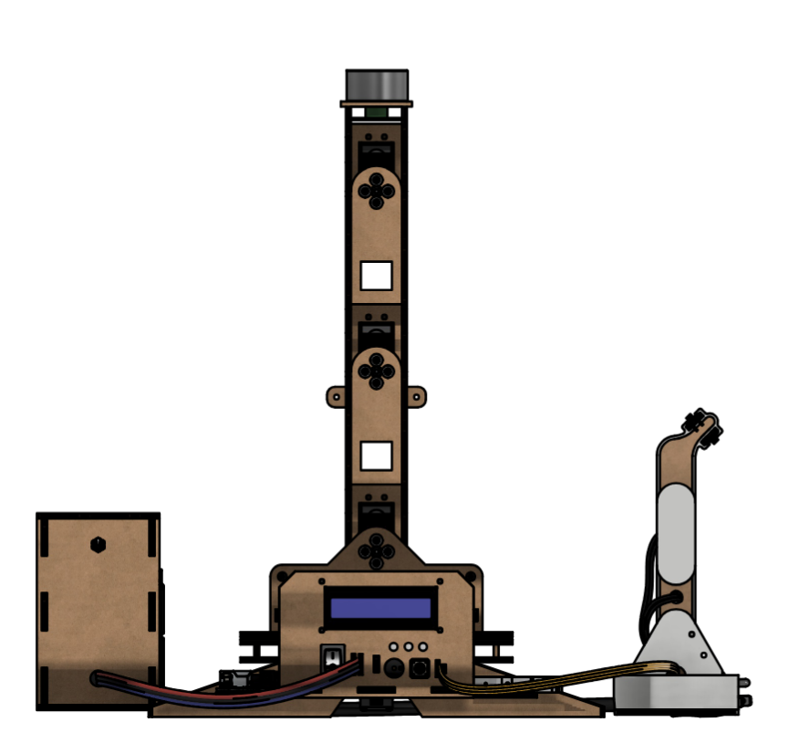
latex/Anexos/CAD/todoFrente.png
