HectorPereira/proyectoIntegrador2/latex/Anexos/CAD/CAD.pdf

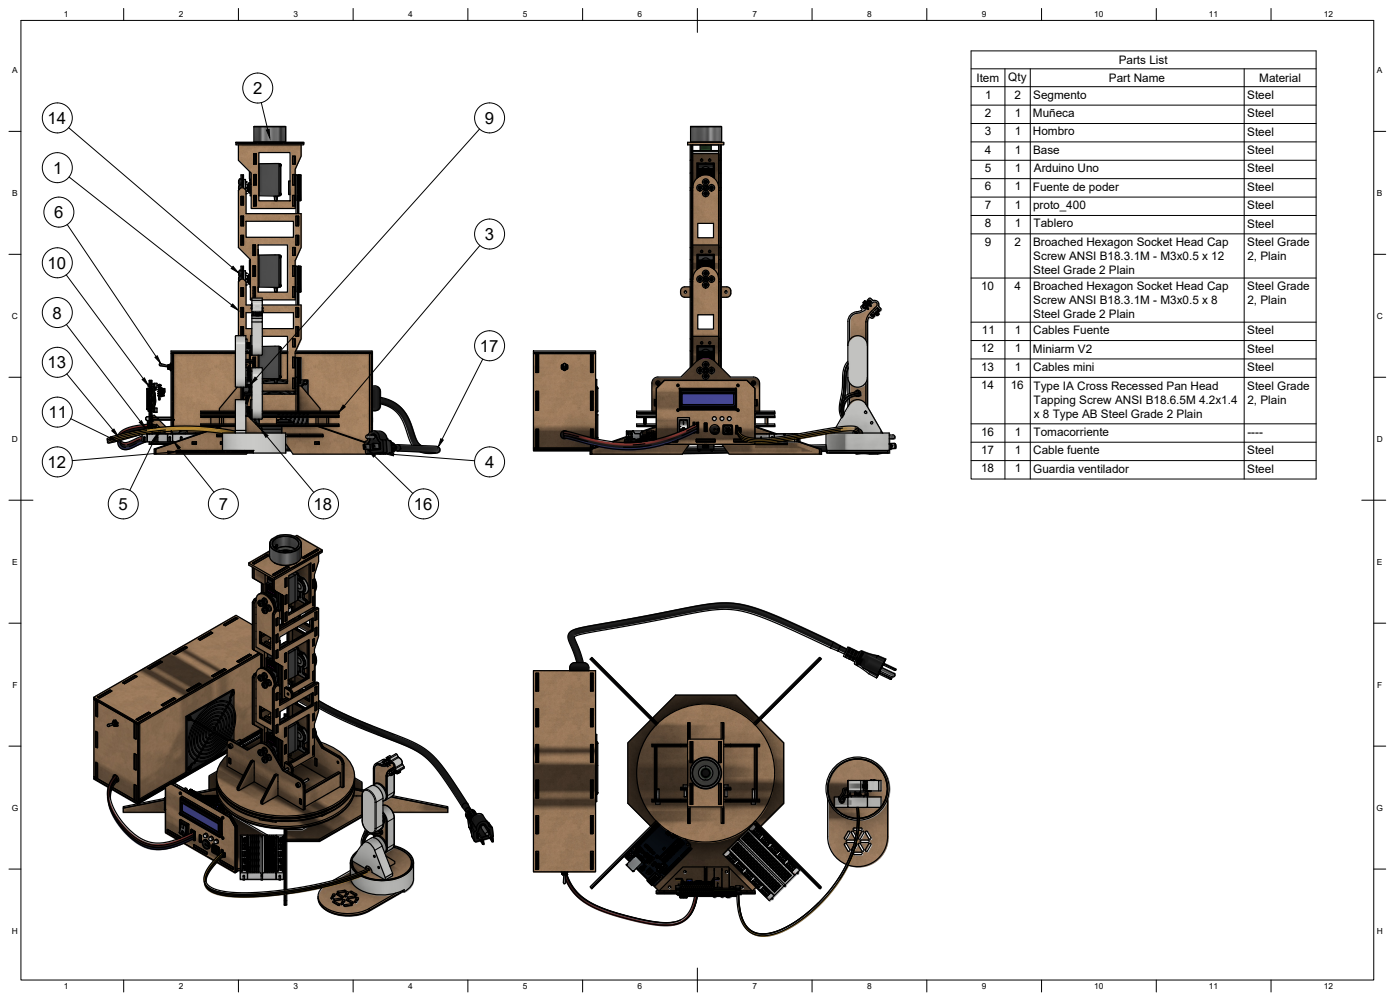
[picture p133: page 1]
12 BACDEFGH; BACDEFGH; Parts List; Item Qty; Part Name; Material 1; 2 Segmento; Steel 2; 1 Muñeca; Steel 3; 1 Hombro; Steel 4; 1 Base; Steel 5; 1 Arduino Uno; Steel 6; 1 Fuente de poder; Steel 7; 1 proto_400; Steel 8; 1 Tablero; Steel 9; 2 Broached Hexagon Socket Head Cap; Steel Grade 2, Plain; 4 Broached Hexagon Socket Head Cap; 1 Cables Fuente; Steel; 1 Miniarm V2; 1 Cables mini; 16 Type IA Cross Recessed Pan Head; 1 Tomacorriente; 1 Cable fuente; 1 Guardia ventilador; Steel 12

Screw ANSI B18.3.1M - M3x0.5 x 12
Steel Grade 2 Plain

Screw ANSI B18.3.1M - M3x0.5 x 8

Tapping Screw ANSI B18.6.5M 4.2x1.4
x 8 Type AB Steel Grade 2 Plain

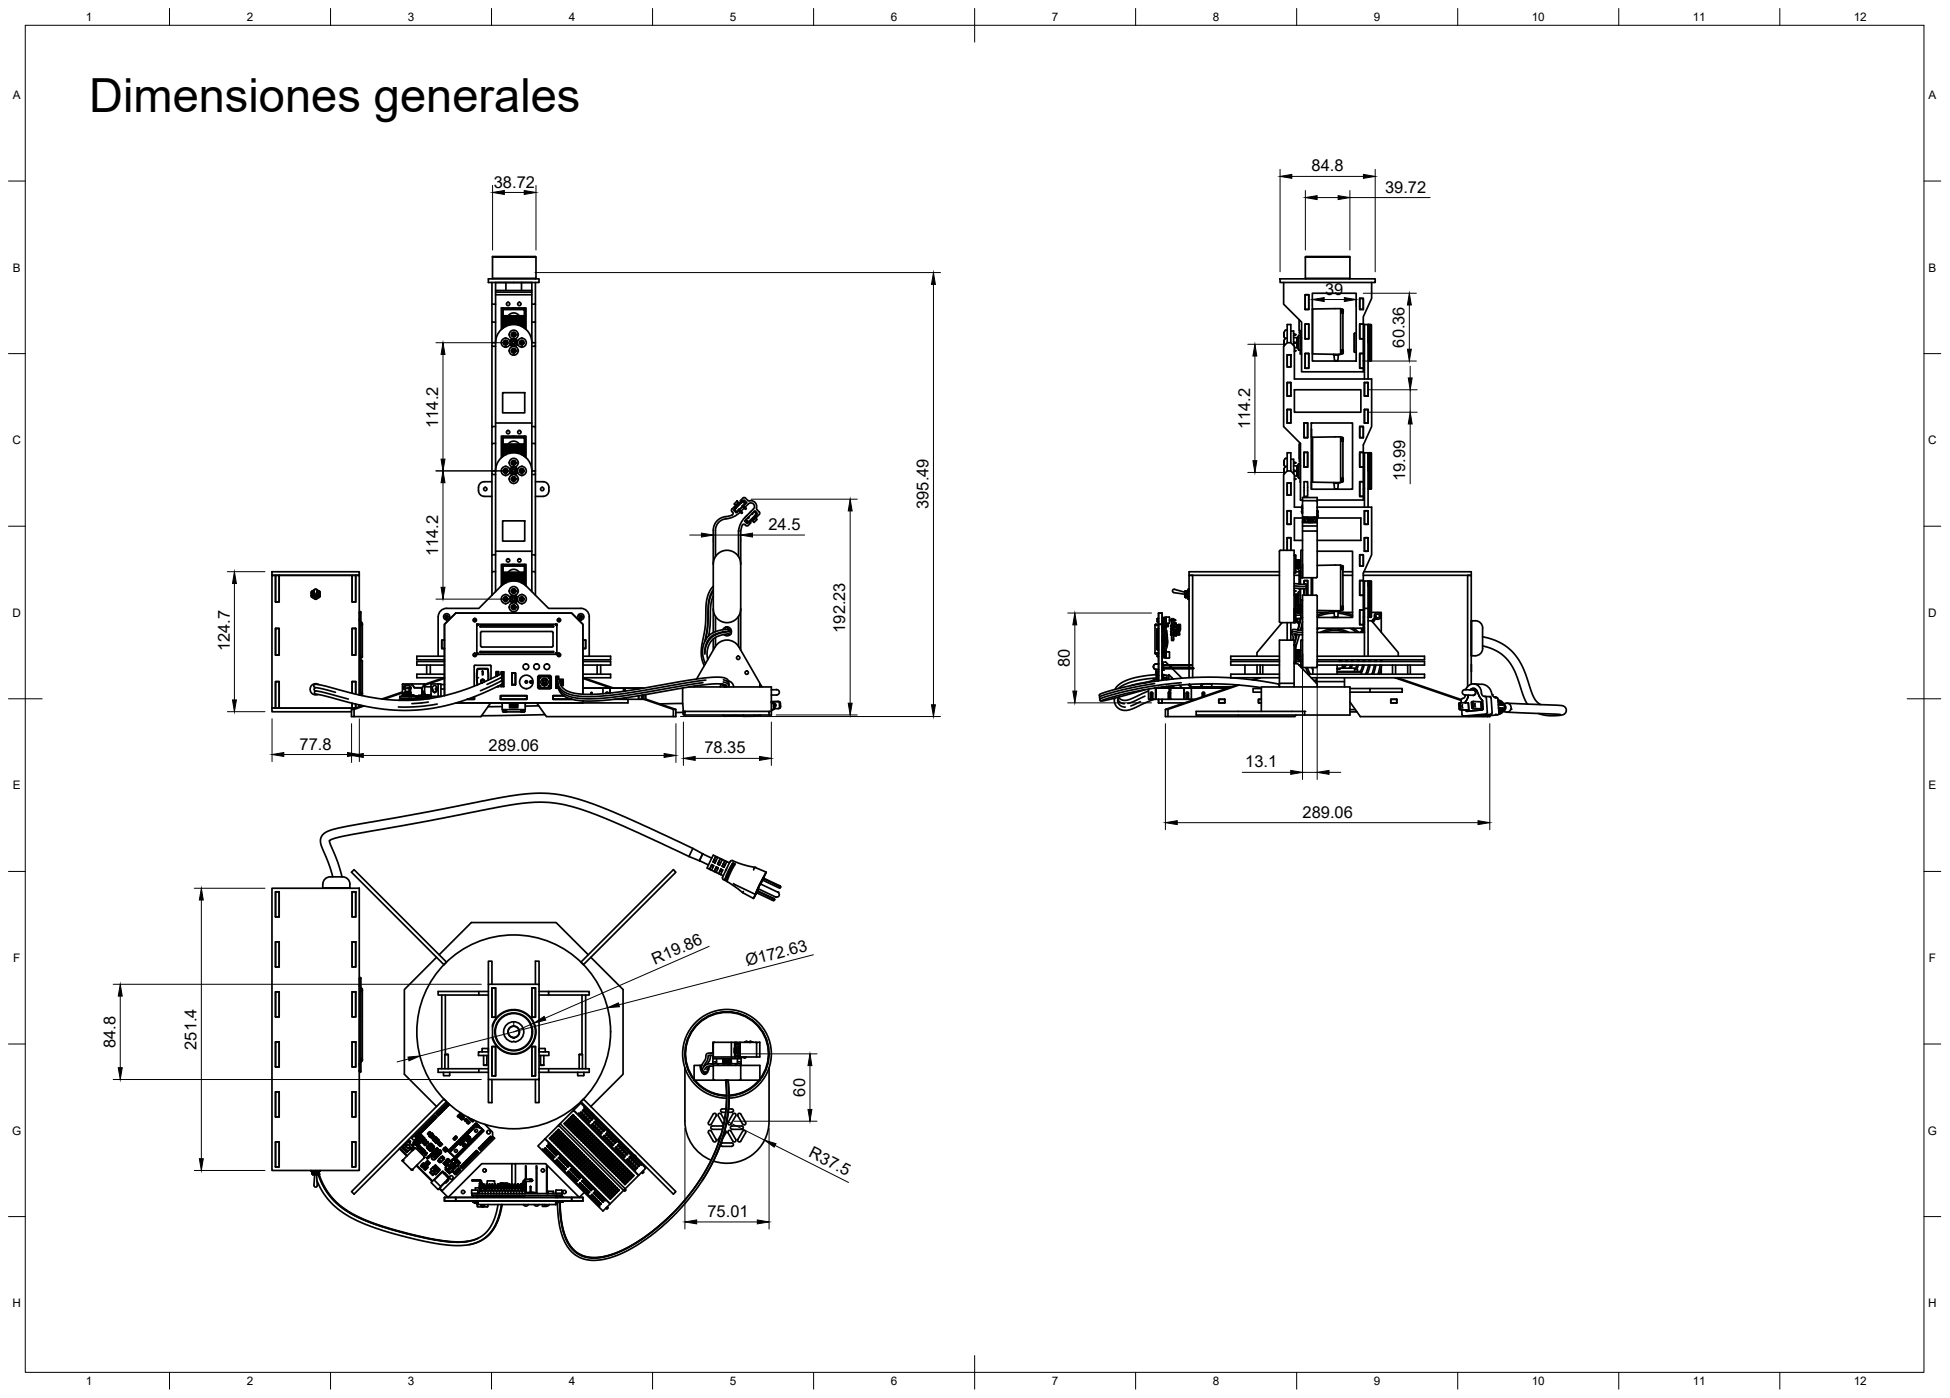
[picture p134: page 2]
Dimensiones generales

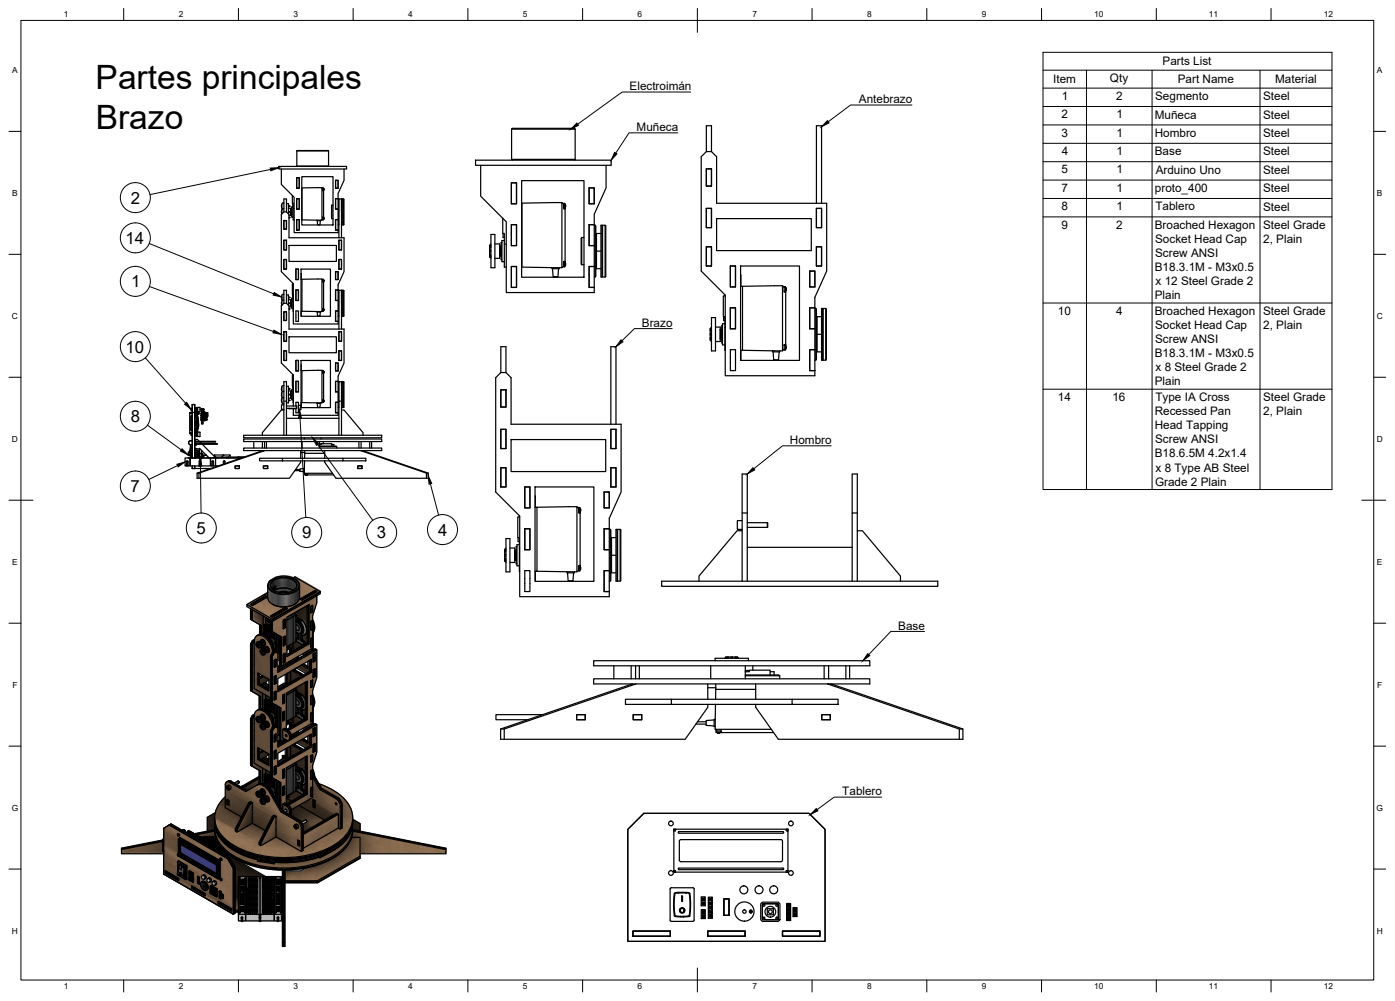
[picture p135: page 3]
Parts List; Item; Qty; Part Name; Material; Arduino Uno; Steel; Broached Hexagon; Steel Grade 2, Plain; Type IA Cross; Partes principales

Socket Head Cap
Screw ANSI
x 12 Steel Grade 2
Plain

x 8 Steel Grade 2

Recessed Pan
Head Tapping
x 8 Type AB Steel
Grade 2 Plain

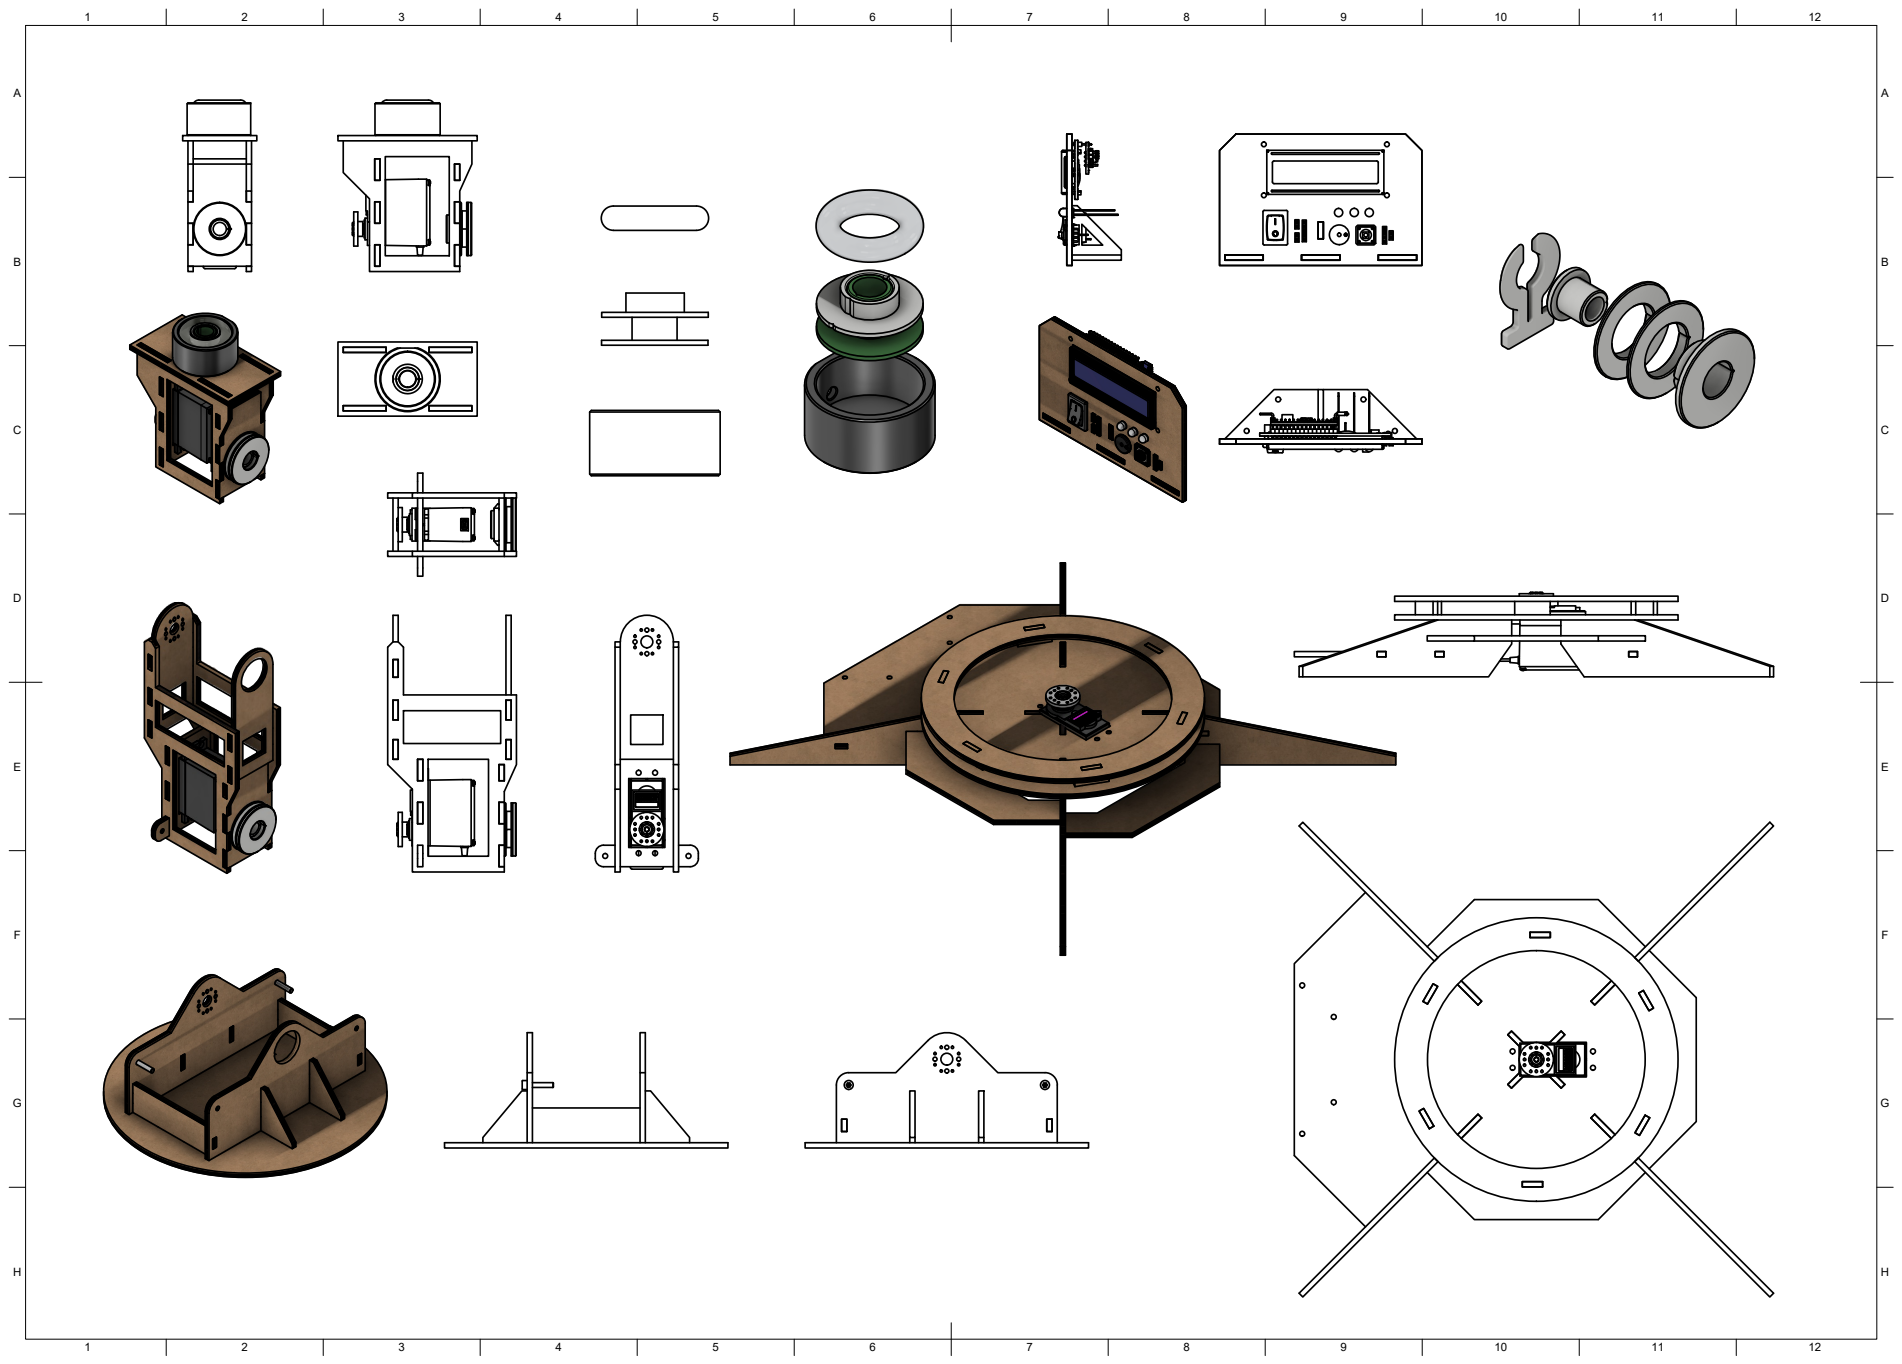
[picture p136: page 4]
12 BACDEFGH; BACDEFGH

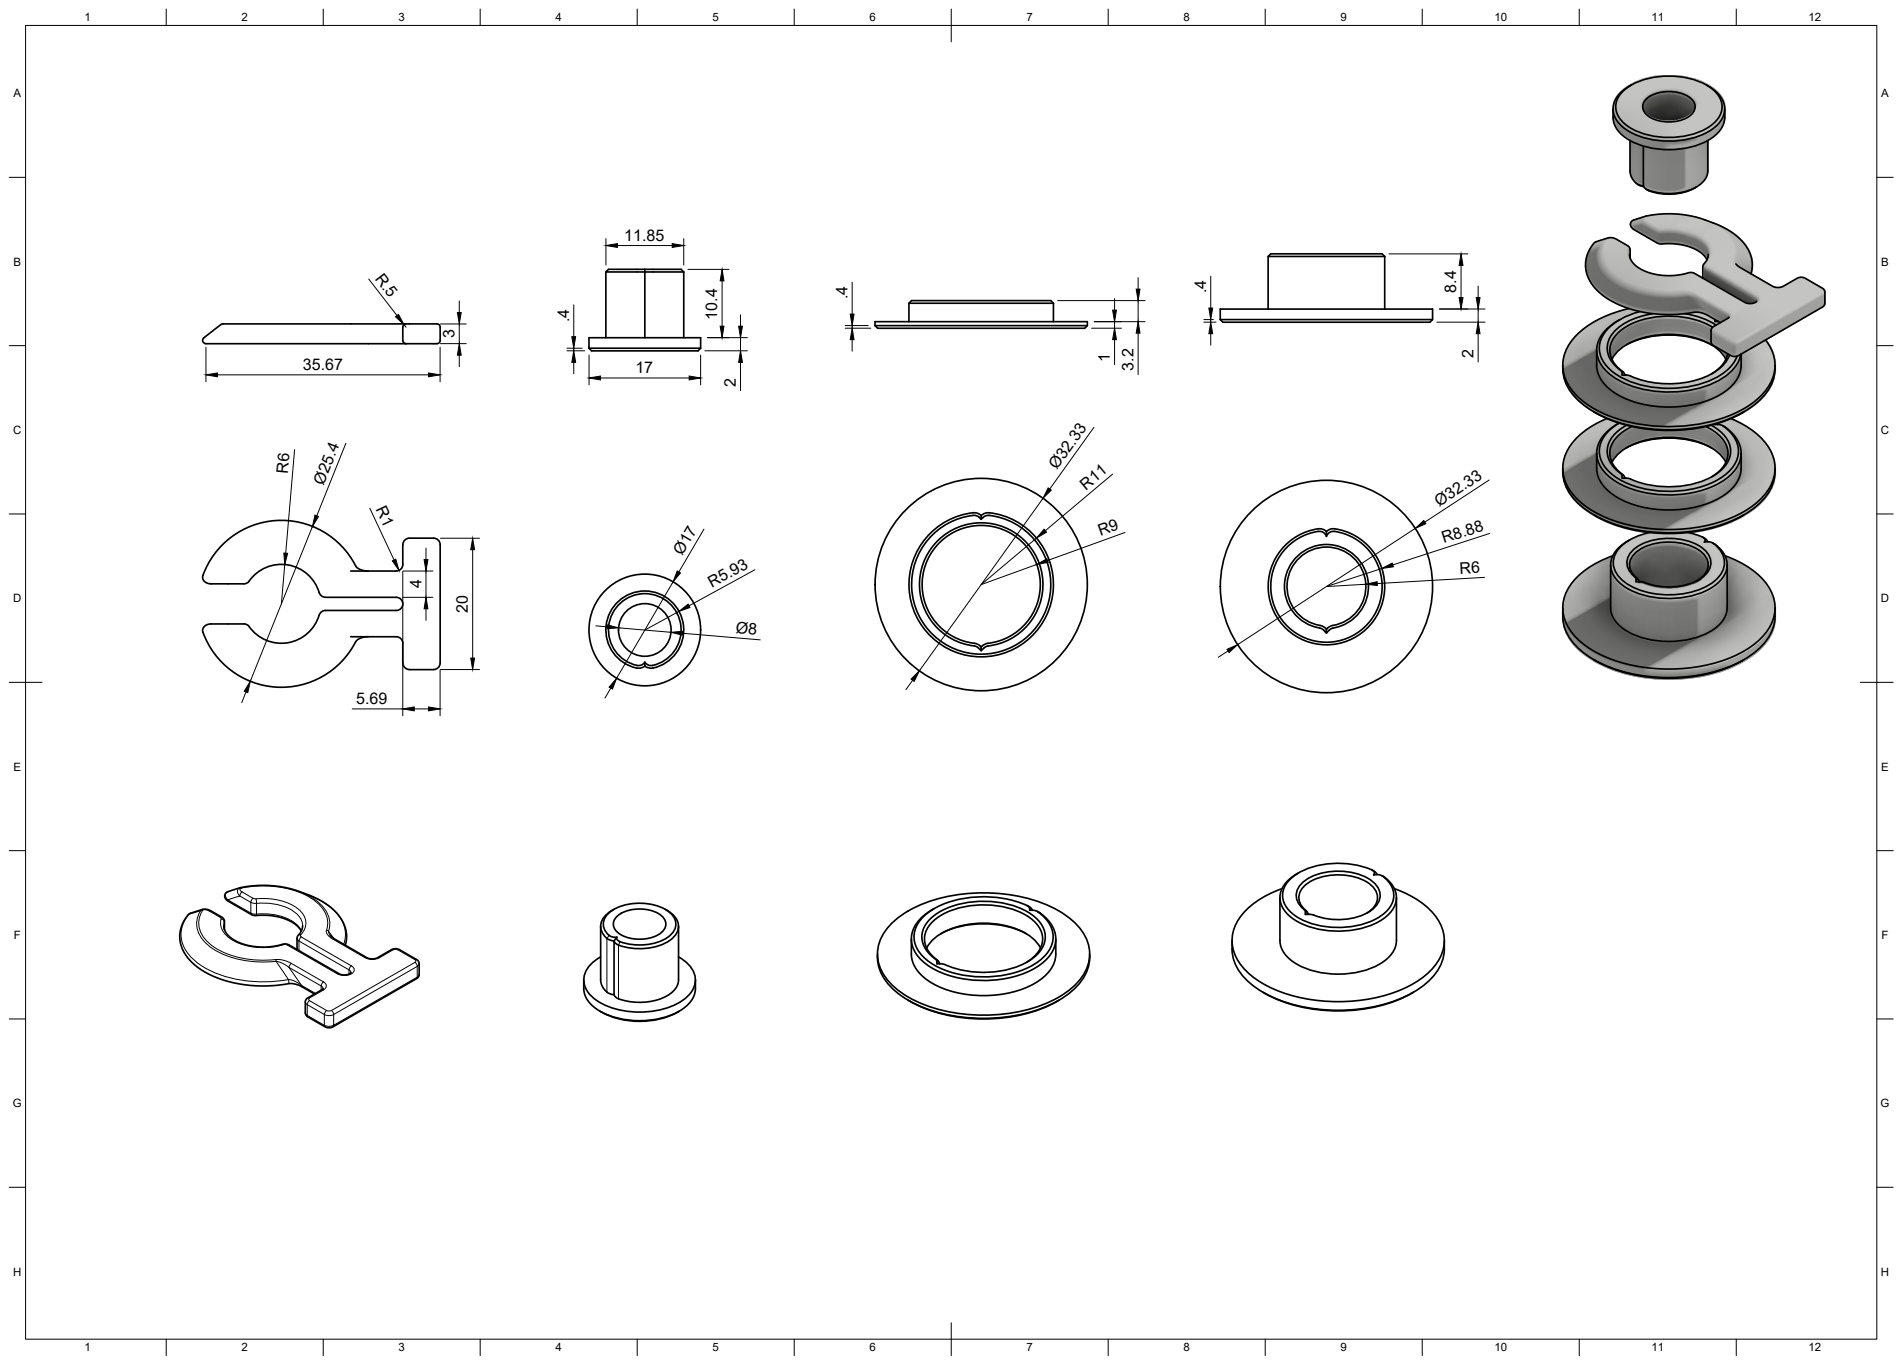
[picture p137: page 5]
12 BACDEFGH; BACDEFGH

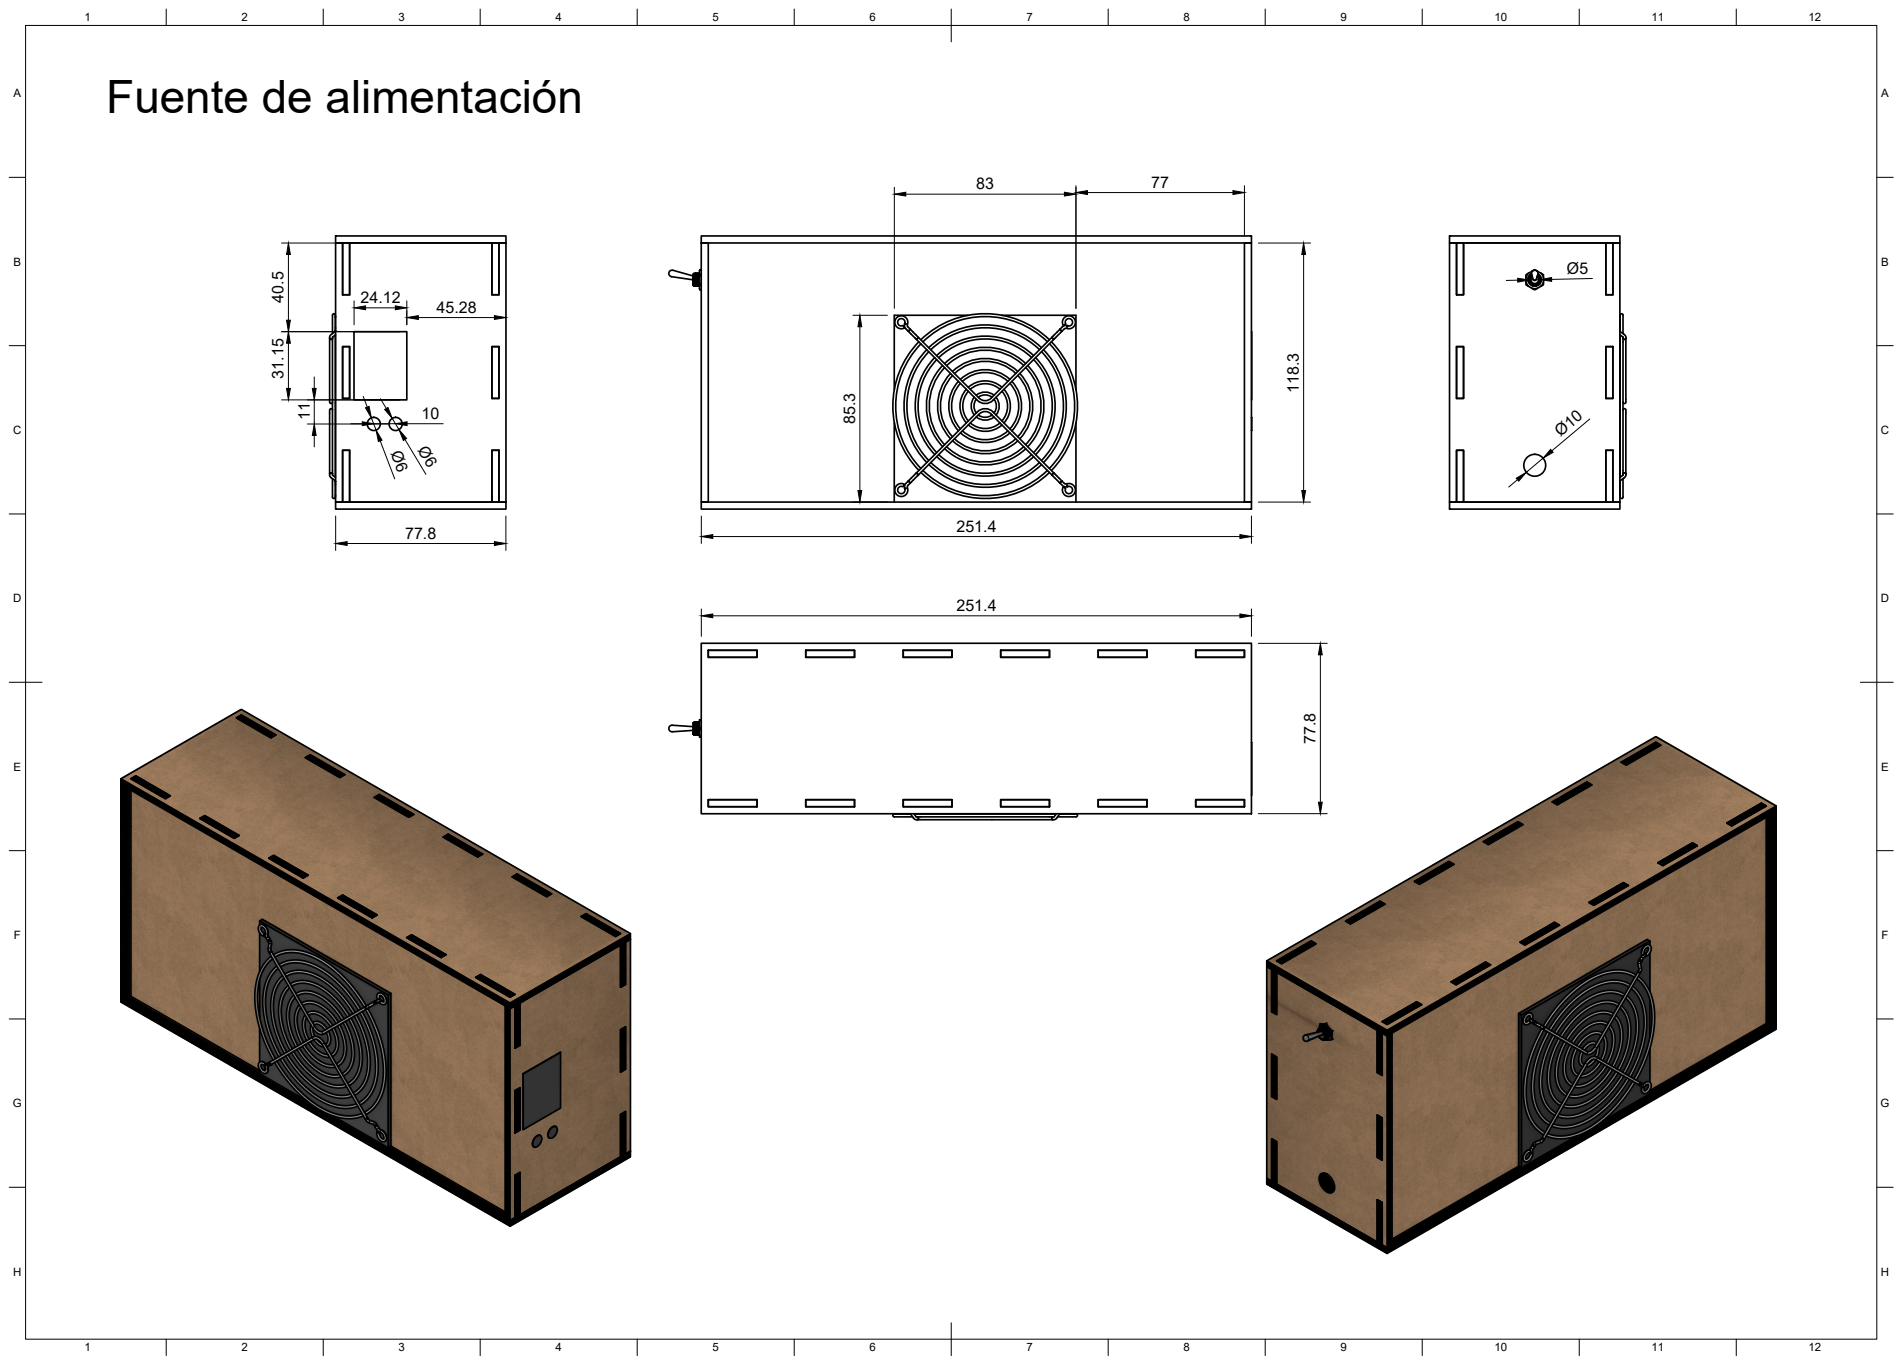
[picture p138: page 6]

Fuente de alimentación

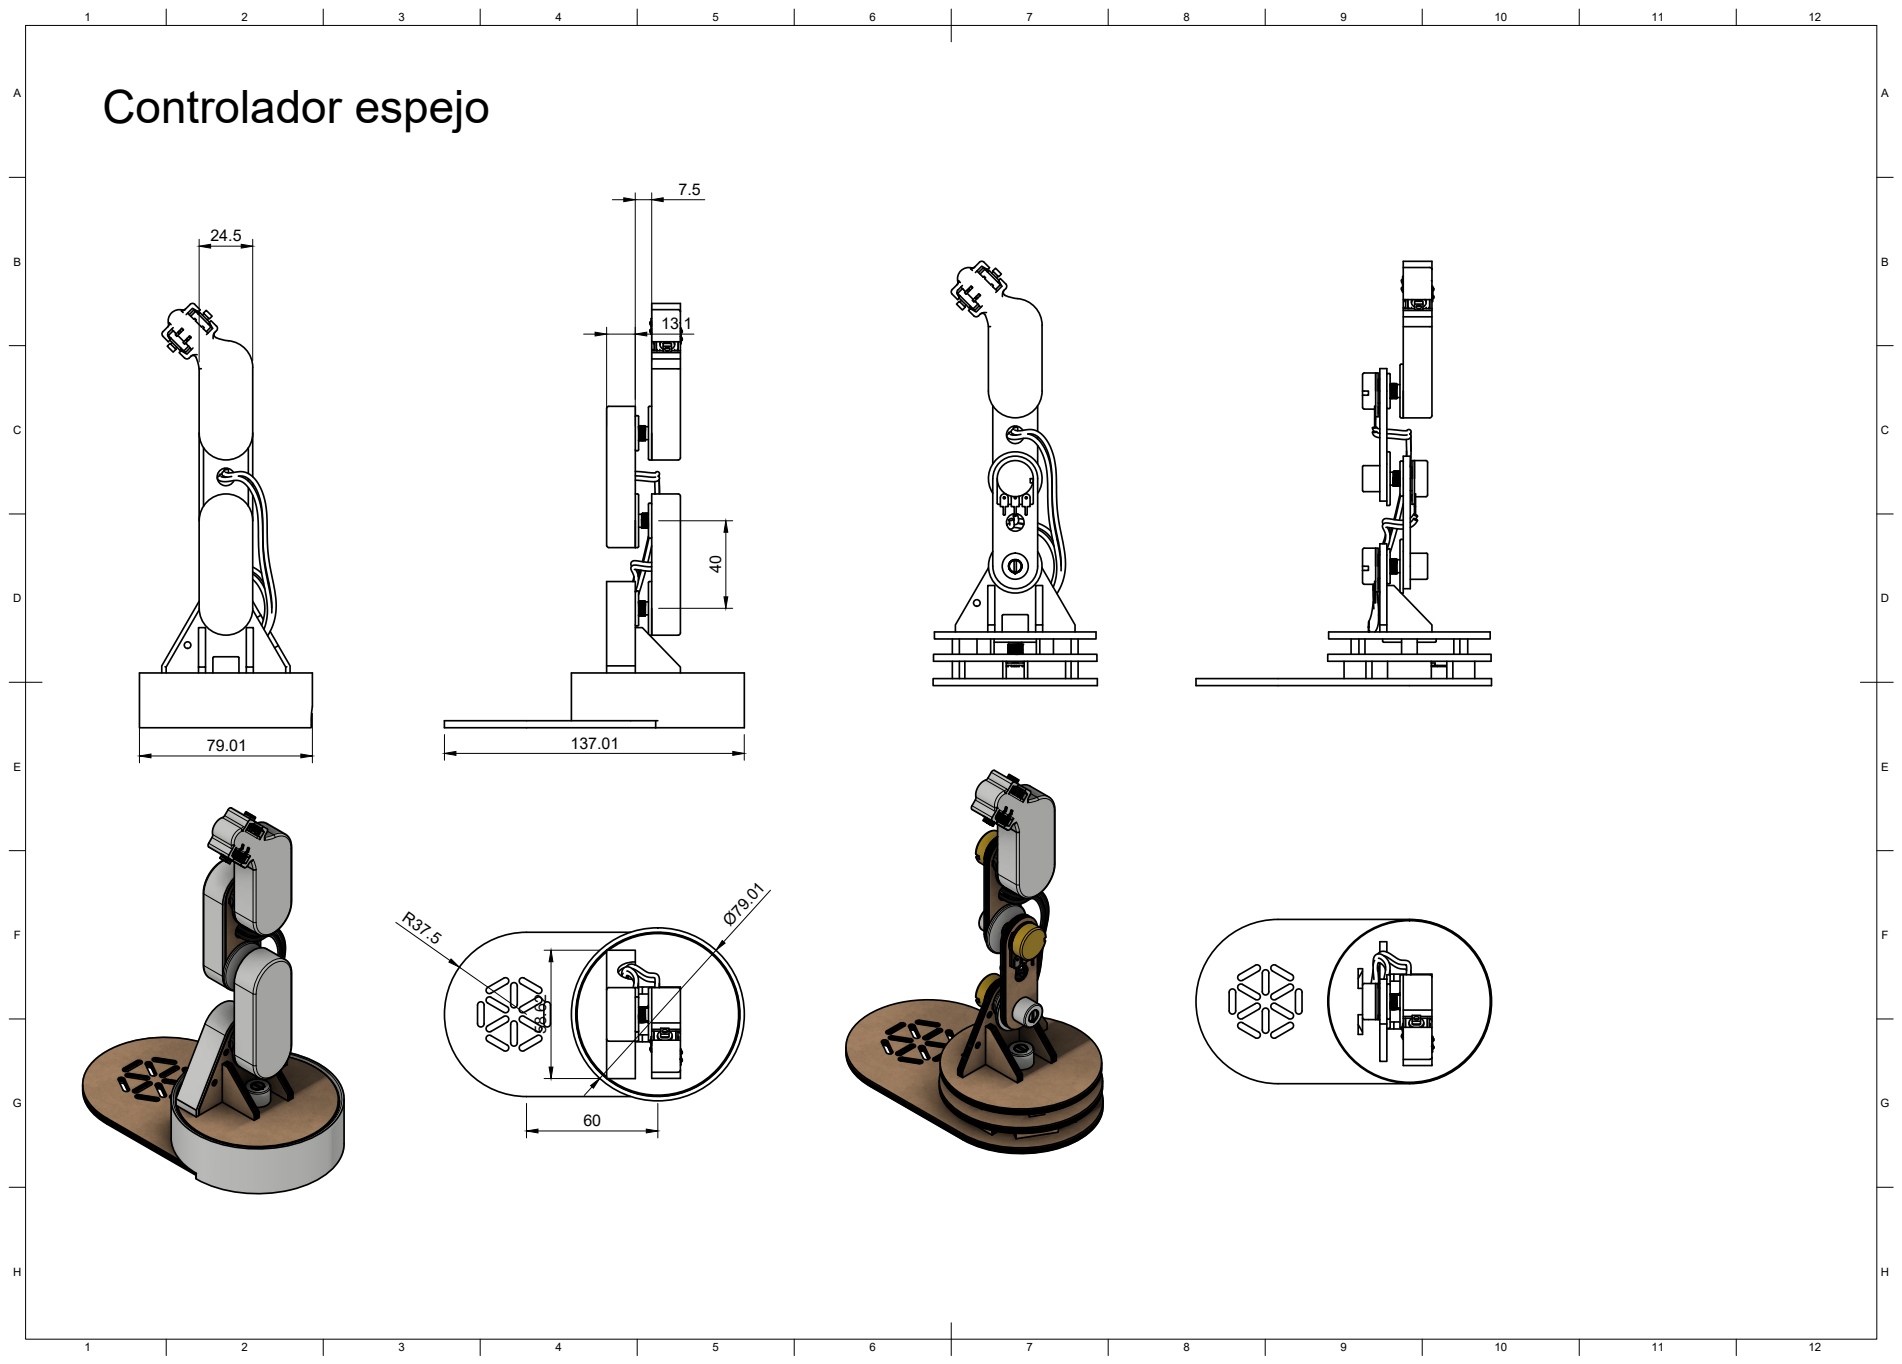
[picture p139: page 7]
Controlador espejo

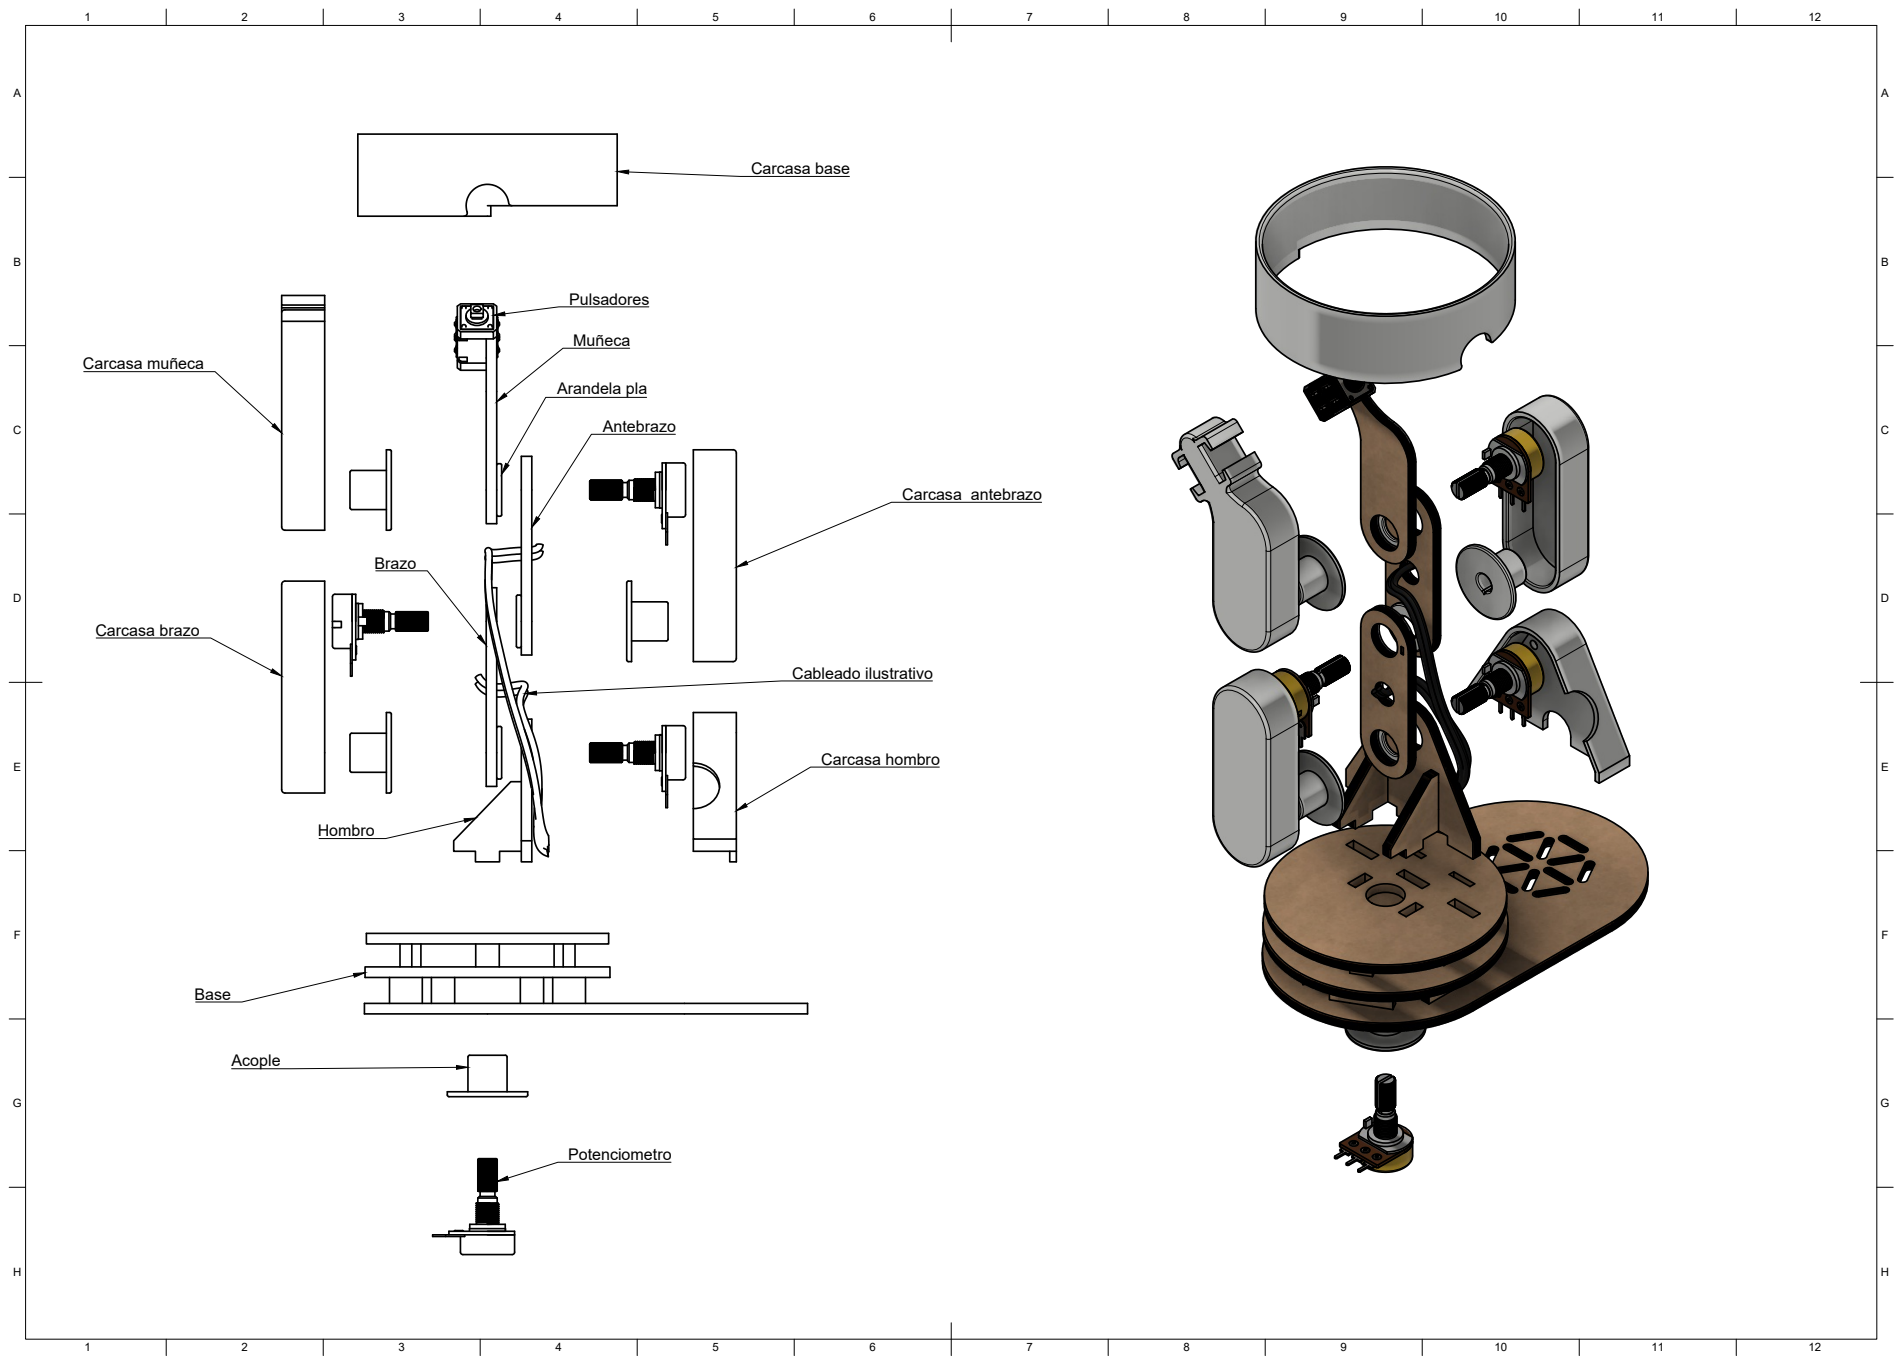
[picture p140: page 8]
Carcasa base; Carcasa antebrazo; Carcasa hombro; Carcasa brazo; Carcasa muñeca; Cableado ilustrativo; Arandela pla

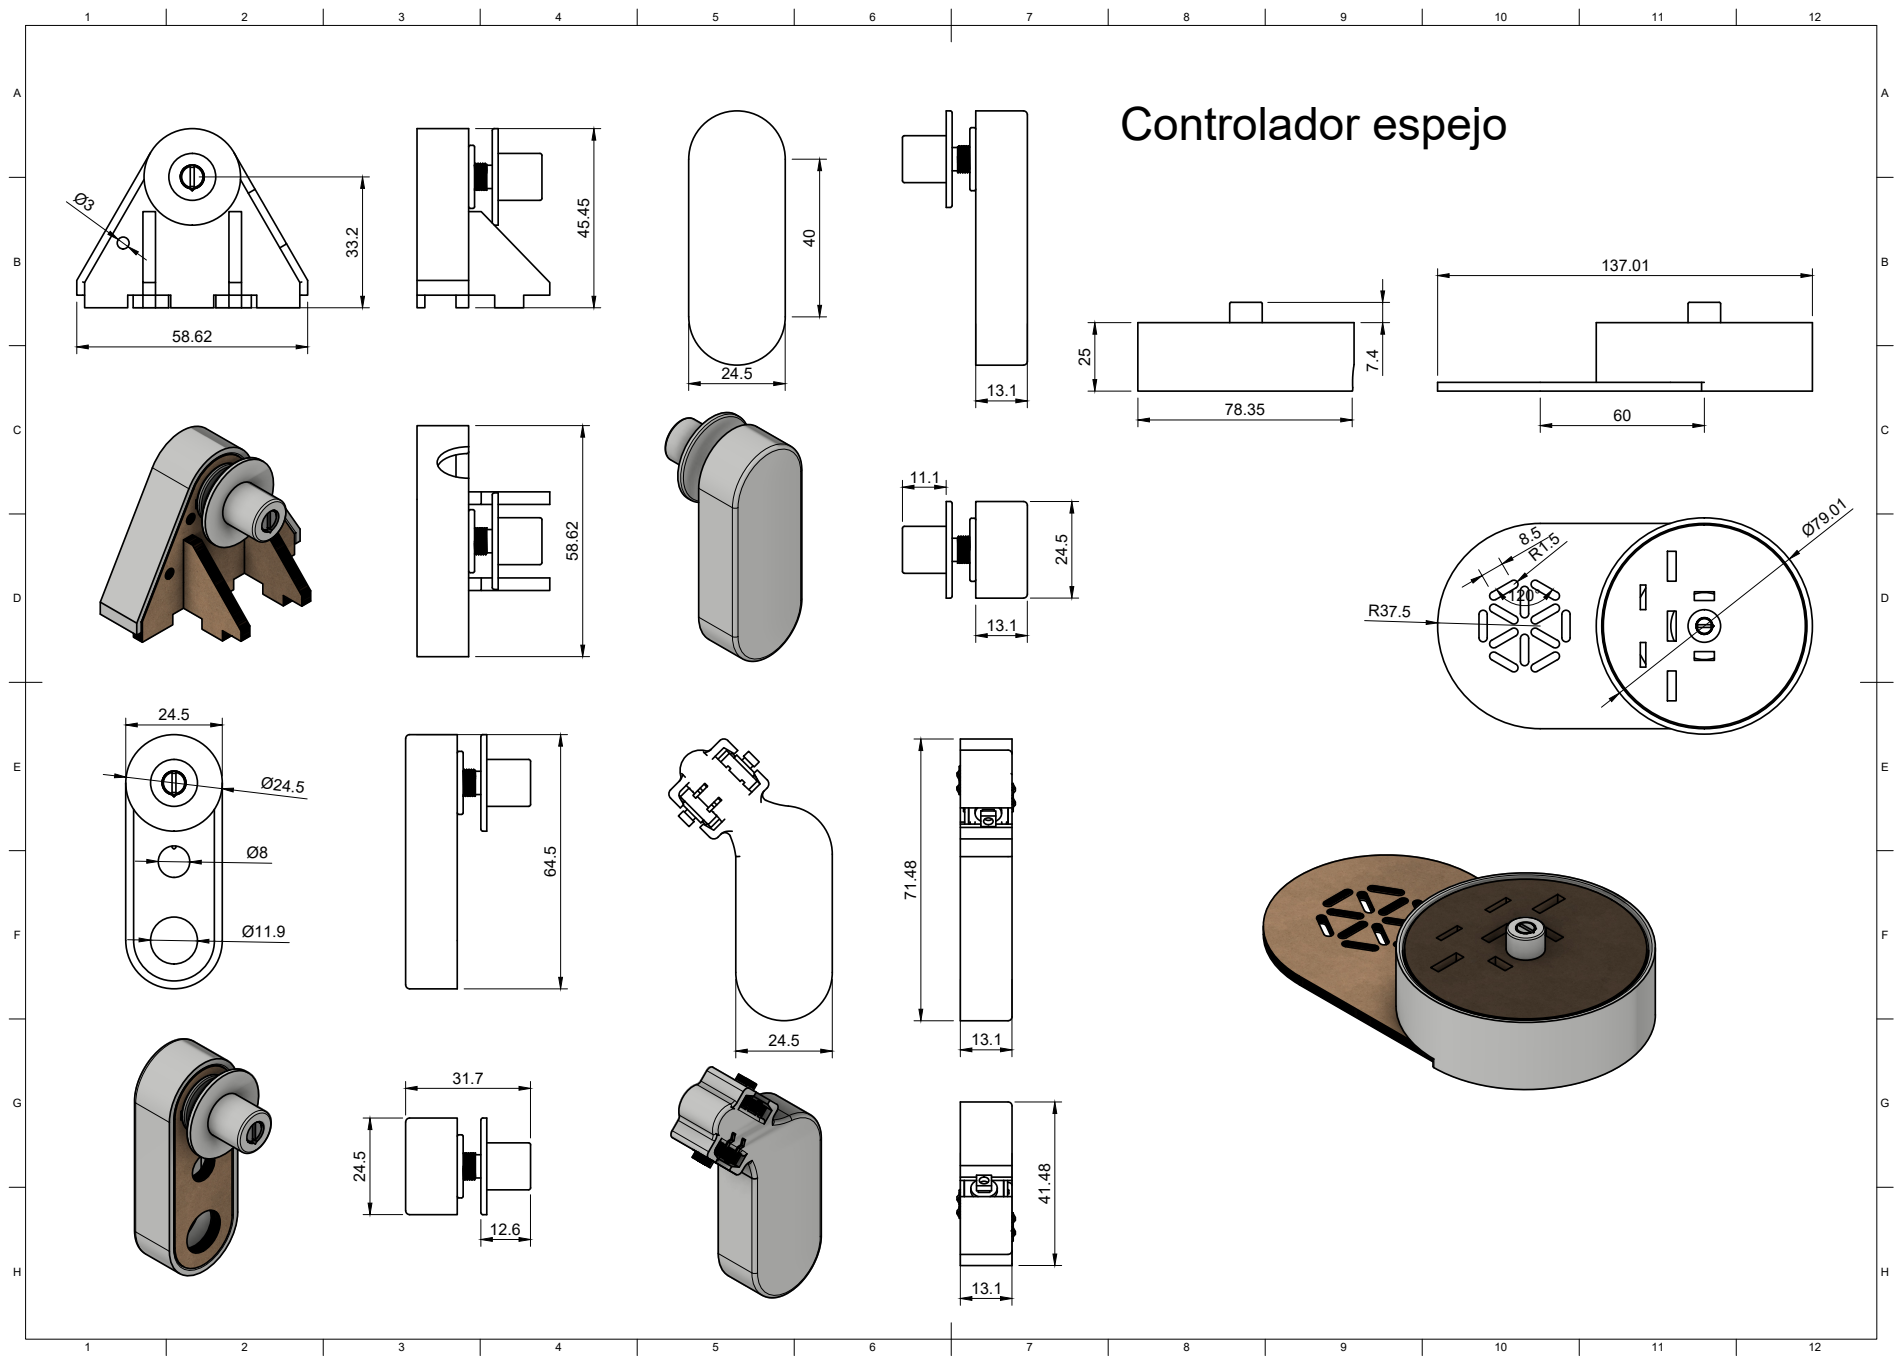
[picture p141: page 9]
Controlador espejo 64.5 58.62 45.45

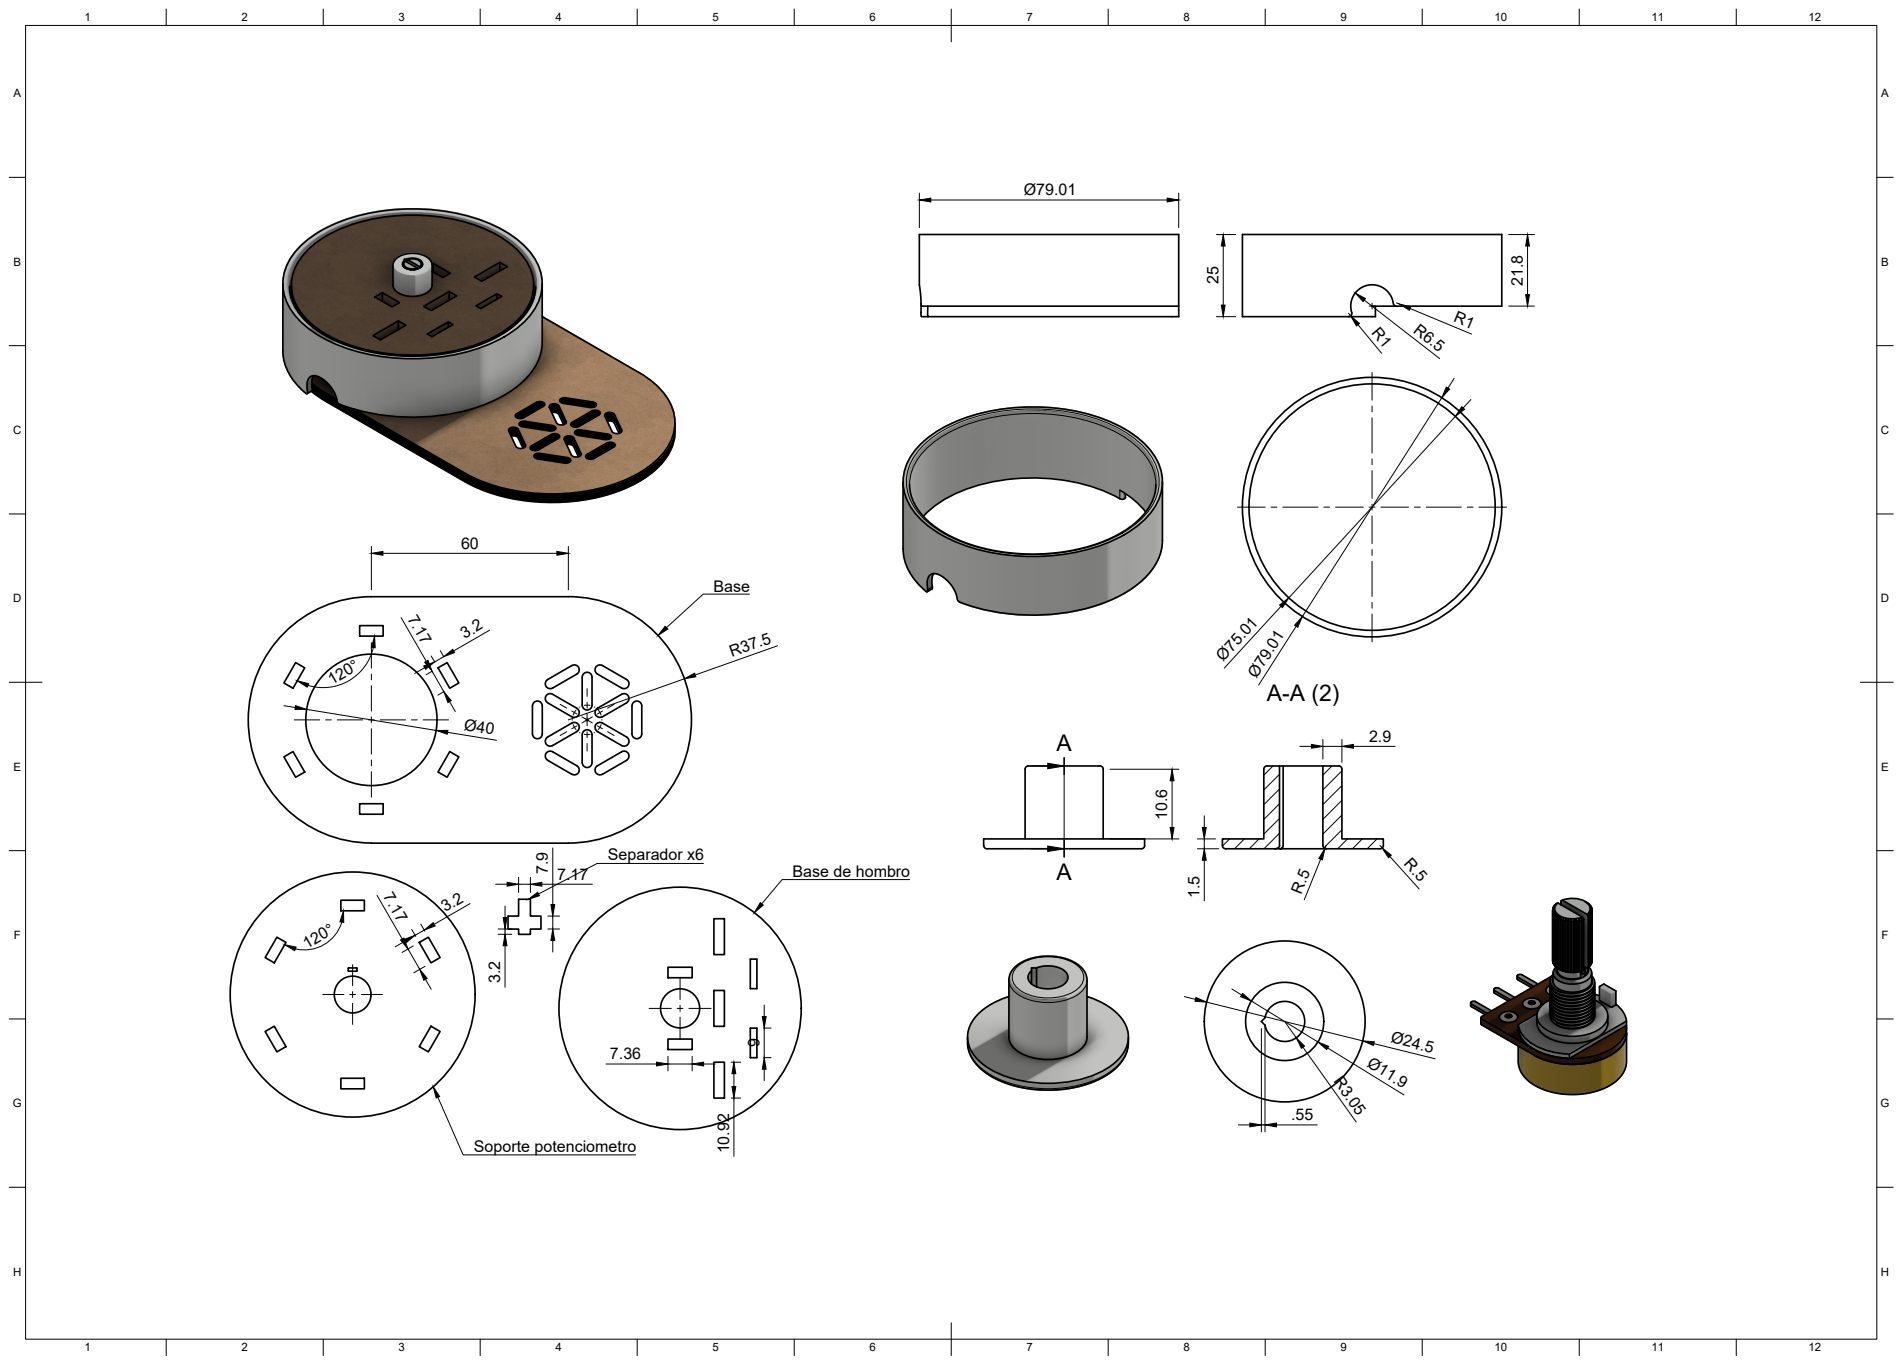
[picture p142: page 10]
Separador x6; Soporte potenciometro

Base de hombro

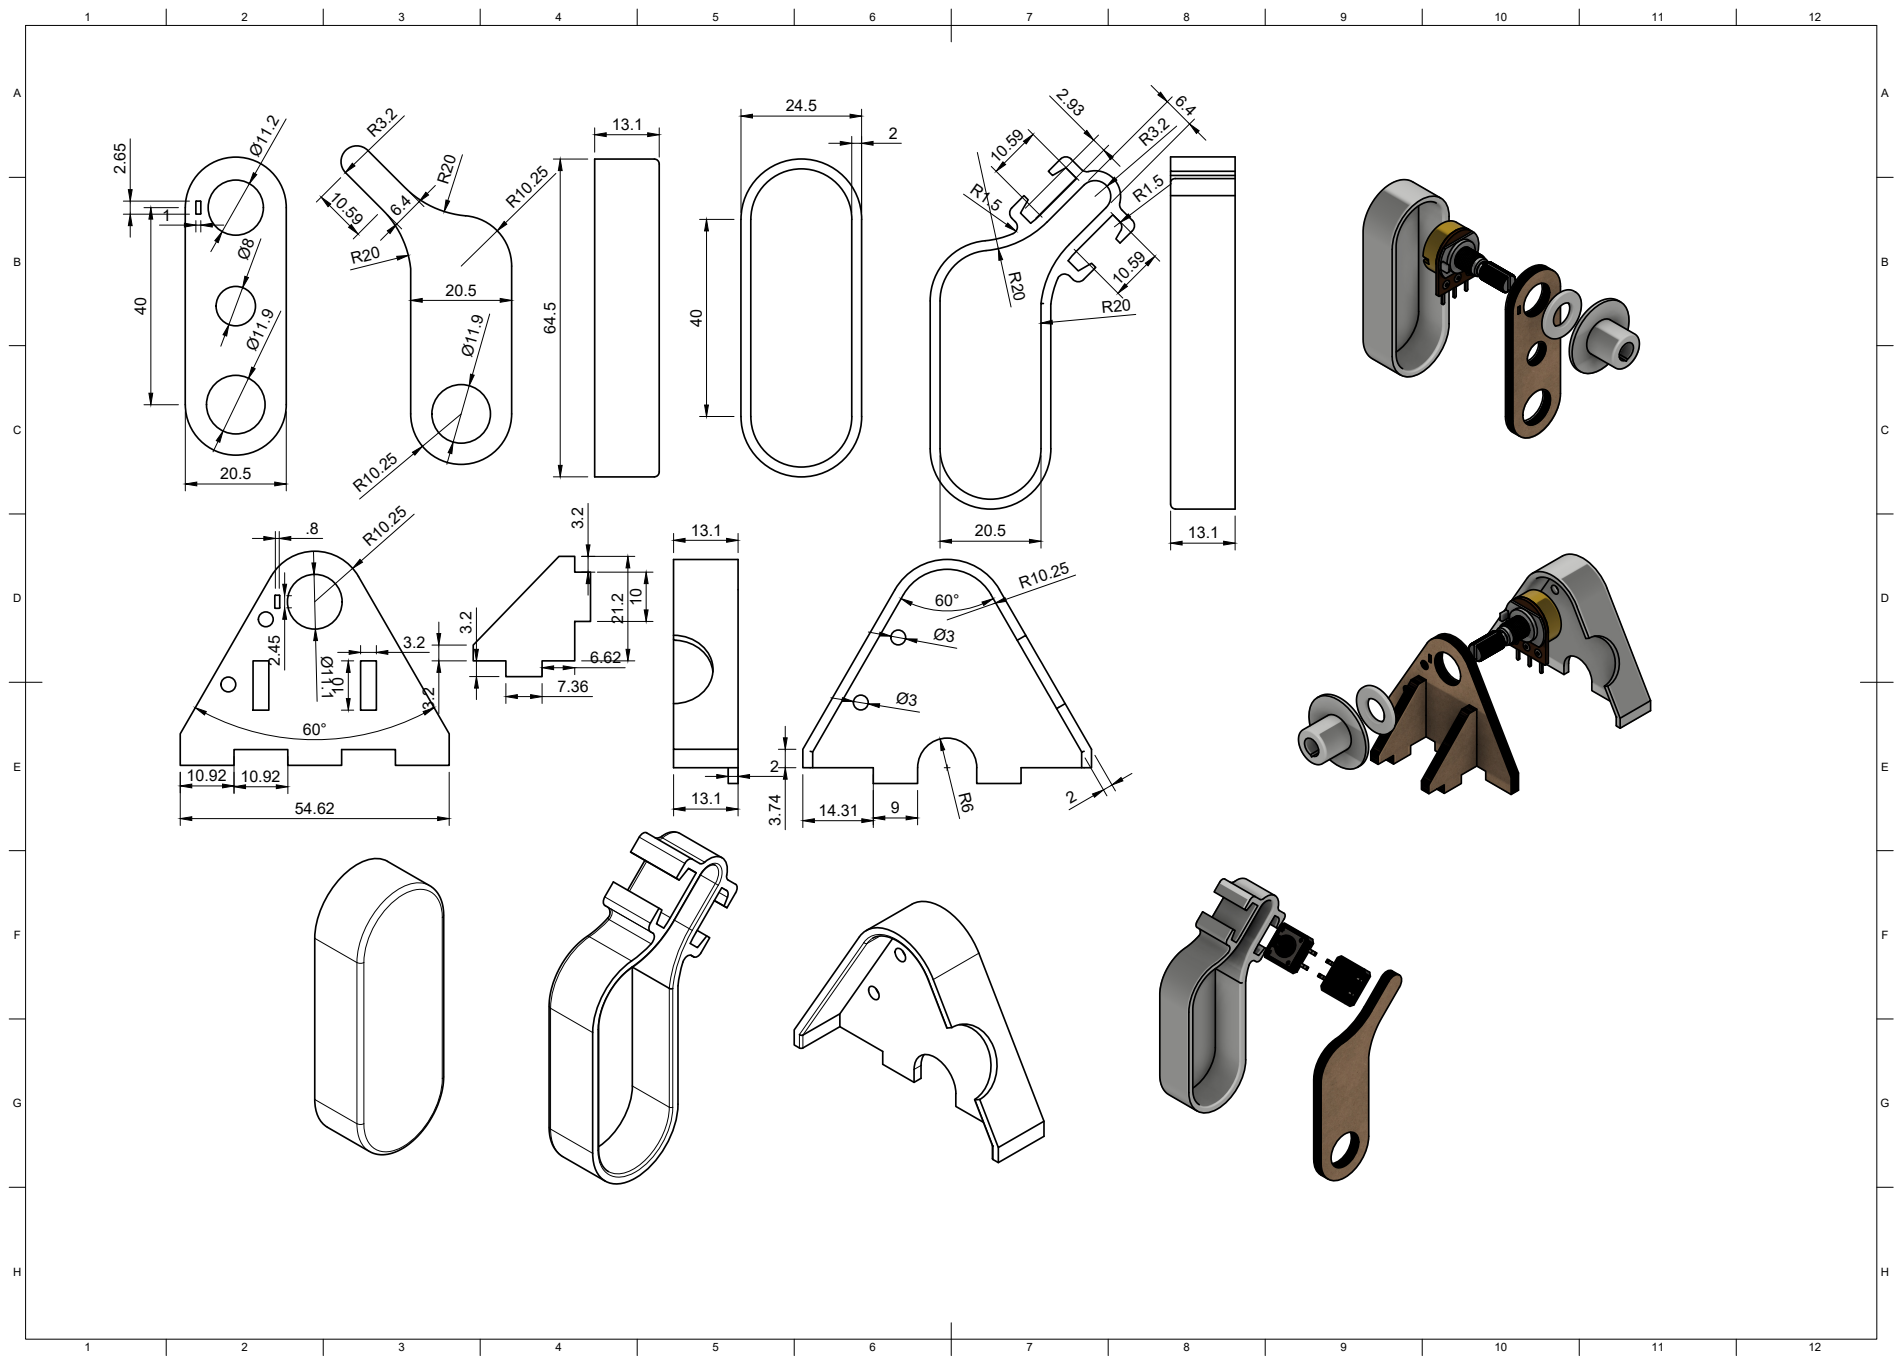
[picture p143: page 11]
