HectorPereira/proyectoIntegrador2/latex/evidencias 2/anexos/Videos brazo/tinkercad.pdf

A

1 | 2 | 3 | 4 | 5 | 6

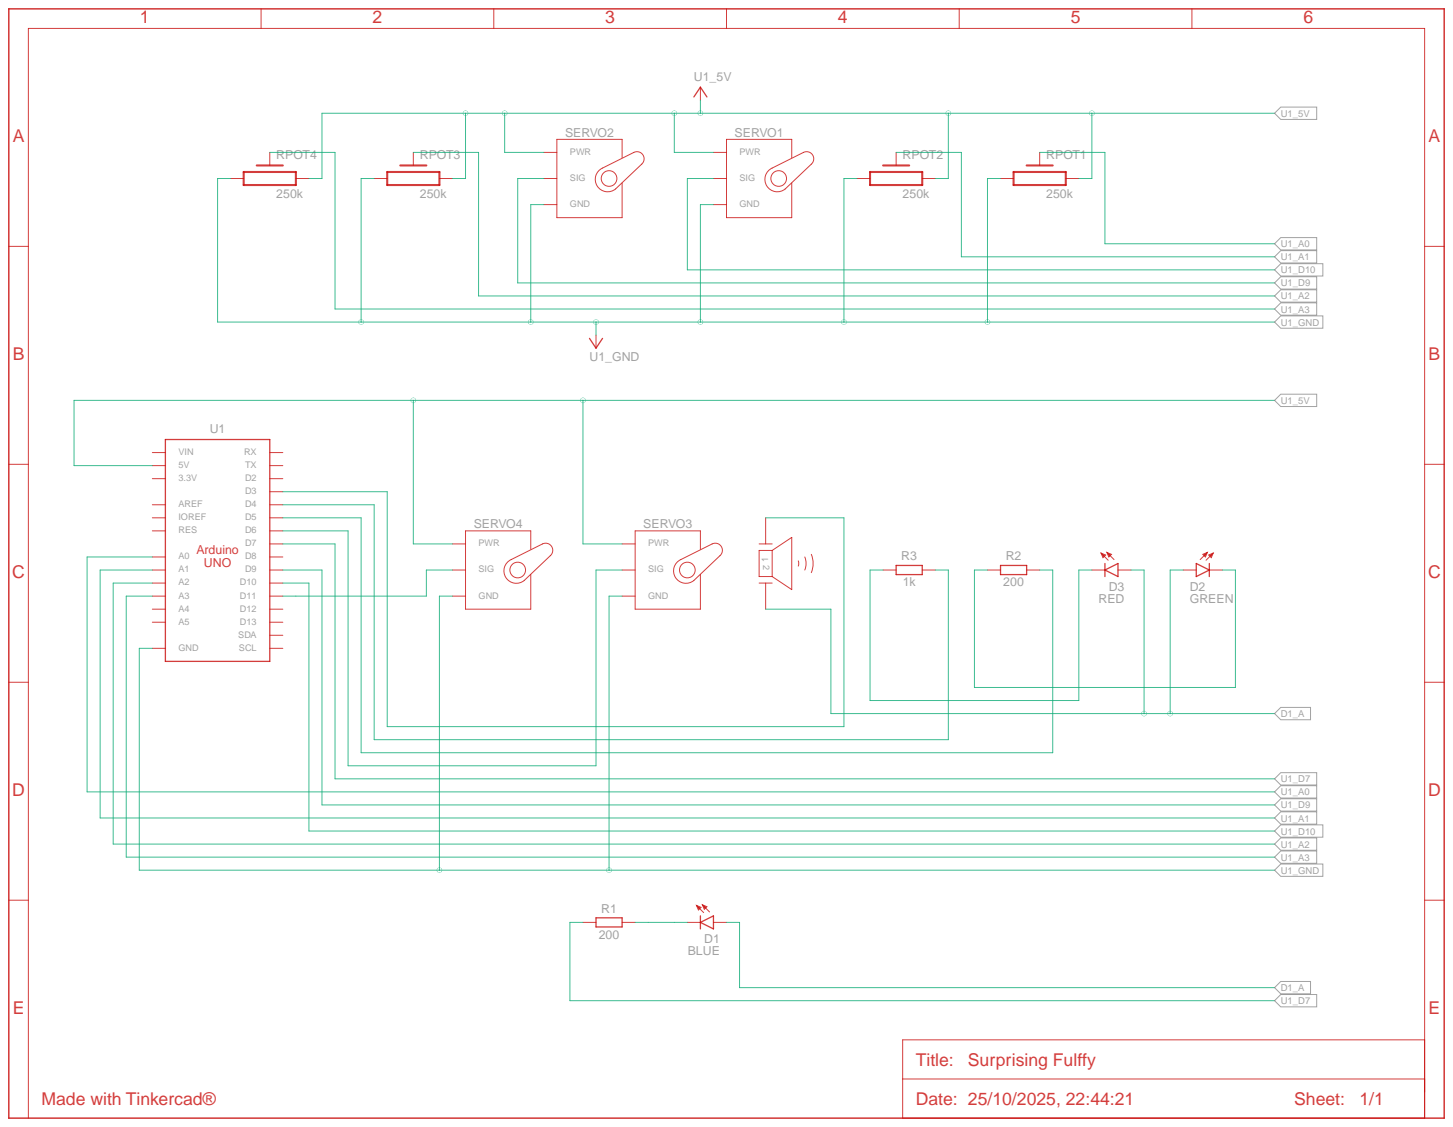
[picture p144: page 1]
