HectorPereira/proyectoIntegrador2/(commit log)

2025-08-23 Criterios de diseño
2025-08-25 Cambiando formatos de lista
2025-08-28 Código inicial para mover los servos a base de los potenciometros
2025-08-28 Código para manipular los 4 servomotores junto con una explicación breve del mismo, en la que se incluyen los parametros que se pueden modificar, y que puede afectar la modificación del mismo para el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
2025-08-29 Quitado el backup
2025-09-01 Actualización del logo de UTEC en el software de control del brazo
2025-09-01 Actualización de software para control del brazo
2025-09-01 Eliminación de los botones "cargar imagen" en software de control del brazo
2025-09-01 Solución de error en software de control del brazo. Se agrego "from typing import Optional, Any" (linea 9), y se cambio la actual linea 47 por "self.ser: Optional[Any] = None"
    [main.py]
2025-09-03 Breve introducción de lo que hace la app dentro del informe.
    Corrección de errores en el código del minibrazo.
    [mini_brazo.ino]
2025-09-03 Descripción y explicación del software de control del brazo robot
2025-09-06 Added fabrication folder
    [100.stl, 101.stl, 102.stl, 103.stl, 104.stl, 105.stl, 95.stl, 96.stl]
2025-09-15 Actualización de la app
2025-09-15 actualización de app
2025-09-15 Actualización de software de control
2025-09-15 Correxión de errores de la ultima aplicación (mejor visualización de los valores que se van cargando a la lista de posiciónes y correcta implementación de la opción guardar lista de posiciones), elim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
    [main.py]
2025-09-27 En camino el código ...
2025-09-27 Matrices de seleccion y referencias
2025-09-27 Matrices de selección y diagrama de Gantt
2025-09-27 Segmentacion de proyecto
2025-09-28 No se que mas agregar
2025-10-25 Código controlado por la aplicación, se parte de la base de "codigoPri", saque un servo, y una lectura de pote, por que no tenía los materiales, pero funciona bien, hay que apliarlo a futuro con 4 se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
2025-11-20 Actualización del main.py y codigoMateo, funcionan juntos, falta agregar la funcion de guardar movimientos
2025-11-23 Actualización de la aplicación.
    Agregado de grabar posiciones y ejecutar movimientos pregrabados.
2025-11-24 Actualización de main.py y códigoMateo
2025-11-25 Actualuzación del main.py para la aplicación
2025-11-25 Actualizaciópn de la aplicación
2025-11-26 Parte del marco teórico de la GUI
2025-11-26 Reescritura de concluciónes con un poco más de detalle y queda más completa (desde mi punto de vista).
2025-11-26 Eliminación de lineas sin importancia
2025-11-26 Corrección de ortografía
